XavierianAerospace/Plane_Proyect/Simulacion_Matlab_SolidWorks/Documento_Maestro_Proyecto_VTOL_Tipo_Stallion.docx

Documento Maestro del Proyecto

Avión VTOL Académico de Ala Fija Tipo Stallion

Campo | Definición inicial
Tipo de aeronave | VTOL académico de ala fija
Configuración | Tricóptero tipo Stallion: 2 motores delanteros inclinables + 1 motor trasero
Objetivo principal | Despegue vertical, hover estacionario, transición y vuelo horizontal
Autonomía objetivo | 20 a 30 minutos
Carga útil | Cámara pequeña de 300 a 400 g como máximo
Equipo de trabajo | 5 integrantes
Presupuesto inicial | Aproximadamente 1 millón COP, ampliable si es necesario

# 1. Descripción general del proyecto

El proyecto consiste en desarrollar un prototipo académico de avión VTOL de ala fija, inspirado en la configuración tipo Stallion. La aeronave deberá despegar y aterrizar verticalmente, mantenerse en hover como un dron, realizar una transición controlada hacia vuelo horizontal y operar en crucero como un avión de ala fija. El diseño se plantea desde cero para poder adaptar geometría, estructura, electrónica y distribución interna a las necesidades del equipo.

La configuración seleccionada es de tricóptero VTOL: dos motores delanteros inclinables y un motor trasero. Durante el despegue y el hover, los motores generan la sustentación vertical. Durante el vuelo horizontal, los motores delanteros inclinables actúan como propulsión principal y las alas generan la sustentación aerodinámica.

Planteamiento central

El avión debe comportarse como un dron durante el despegue, aterrizaje y hover, pero como un avión de ala fija durante la mayor parte del vuelo para alcanzar una autonomía objetivo de 20 a 30 minutos.

Variable | Valor o decisión actual
Envergadura | 1.2 m a 1.5 m
Longitud | 0.8 m a 1.2 m
Peso total objetivo | 2.5 kg a 3.5 kg
Velocidad de crucero | 40 a 60 km/h
Carga útil | Cámara pequeña de 300 a 400 g máximo
Autonomía objetivo | 20 a 30 minutos
Fabricación disponible | Impresión 3D en PLA/PETG, aluminio y barras de fibra comercial
Pruebas | Primero en laboratorio y luego en campo abierto

# 2. Objetivos del avión VTOL

## 2.1 Objetivo general

Diseñar y construir un prototipo académico de avión VTOL de ala fija tipo tricóptero, capaz de realizar despegue vertical, hover estacionario, transición a vuelo horizontal y vuelo de crucero, considerando una carga útil de cámara pequeña y una autonomía objetivo de 20 a 30 minutos.

## 2.2 Objetivos específicos

1. Definir una arquitectura VTOL tipo Stallion con dos motores delanteros inclinables y un motor trasero.
2. Diseñar una estructura liviana, fabricable con impresión 3D, aluminio y elementos de fibra comercial.
3. Seleccionar un sistema de propulsión que permita despegue vertical, hover estable y vuelo horizontal eficiente.
4. Escoger un controlador de vuelo y software gratuito que facilite la integración de motores, servos, sensores y modos VTOL.
5. Reservar desde el diseño espacio, capacidad de carga y ubicación adecuada para una cámara de 300 a 400 g.
6. Desarrollar pruebas progresivas: laboratorio, motores sin hélices, hover controlado, vuelo horizontal y transición.
7. Mantener una documentación clara del diseño, presupuesto, riesgos, pruebas y modificaciones realizadas.

# 3. Requisitos de diseño

Los requisitos iniciales se dividen en funcionales, de desempeño, de fabricación, de presupuesto y de seguridad. Estos requisitos permiten que todos los grupos trabajen con una misma base de diseño.

Tipo de requisito | Requisito inicial
Funcional | Despegue y aterrizaje vertical, hover estacionario, transición y vuelo horizontal.
Configuración | Tricóptero VTOL: 2 motores delanteros inclinables + 1 motor trasero.
Autonomía | 20 a 30 minutos, priorizando el vuelo horizontal y minimizando el tiempo en hover.
Carga útil | Cámara pequeña de 300 a 400 g máximo. La transmisión de video será una meta posterior.
Velocidad | Crucero entre 40 y 60 km/h.
Peso | Objetivo entre 2.5 kg y 3.5 kg. Se debe evitar superar este rango sin recalcular propulsión y estructura.
Materiales | PLA, PETG, aluminio y barras de fibra comercial disponibles en Colombia.
Presupuesto | 1 millón COP inicial, ampliable si la selección de componentes lo exige.
Software | Preferiblemente gratuito, de fácil integración y con soporte para VTOL.
Pruebas | Secuencia segura: laboratorio, configuración sin hélices, pruebas estáticas, hover bajo, vuelo horizontal y transición.

Criterio de autonomía

La autonomía objetivo de 20 a 30 minutos debe buscarse principalmente en modo avión. El hover consume mucha energía y debe limitarse a despegue, aterrizaje, estabilización y pruebas cortas.

# 4. Configuración tipo Stallion

La configuración tipo Stallion combina características de un avión de ala fija y de un multirrotor. El avión utiliza dos motores delanteros capaces de inclinarse y un motor trasero para el modo vertical. Esta arquitectura permite despegar como dron y luego inclinar los motores delanteros para generar empuje horizontal durante el vuelo de crucero.

Etapa de vuelo | Funcionamiento esperado
Despegue vertical | Los tres motores generan empuje vertical. El fuselaje debe mantenerse nivelado como un dron.
Hover estacionario | El avión se mantiene quieto en el aire durante pruebas o maniobras cortas.
Transición | Los motores delanteros se inclinan progresivamente hasta generar empuje horizontal. Las alas comienzan a producir sustentación.
Vuelo horizontal | Las alas sostienen la aeronave y los motores delanteros actúan como propulsores principales.
Aterrizaje vertical | El avión reduce velocidad, vuelve a modo vertical y desciende de forma controlada.

Ventaja | Implicación para el proyecto
Menos motores que un quadplane | Puede reducir peso y resistencia, pero aumenta la exigencia de control.
Transición eficiente | Los motores delanteros sirven para hover y crucero.
Diseño limpio | Permite una geometría de avión más integrada.
Mayor complejidad que un avión normal | Requiere servos inclinables, configuración VTOL y pruebas cuidadosas.
Mayor dificultad que quadplane | El control de hover y transición puede ser más delicado al tener tres puntos de empuje.

# 5. Arquitectura general del sistema

La aeronave se puede entender como la integración de cinco sistemas principales: estructura, propulsión, energía, control de vuelo y carga útil. Todos deben diseñarse coordinadamente porque los cambios de peso, ubicación o consumo afectan al resto del avión.

Sistema | Elementos principales | Función
Estructura y aerodinámica | Fuselaje, alas, cola, soportes, tren o patas | Dar forma al avión, soportar cargas y garantizar estabilidad.
Propulsión VTOL/crucero | Motores, hélices, ESC y servos inclinables | Permitir despegue vertical, hover, transición y vuelo horizontal.
Energía | Batería, distribución de potencia, reguladores, conectores | Alimentar motores, controlador, servos, sensores y cámara.
Control de vuelo | Controlador, IMU, barómetro, GPS, receptor, telemetría | Estabilizar el avión y gestionar modos de vuelo.
Carga útil y video | Cámara, soporte antivibración, transmisor o módulo de video futuro | Capturar y transmitir video en una etapa posterior del proyecto.

Esquema general de flujo de energía y control:

Batería -> distribución de potencia -> ESC -> motores VTOL/crucero
Batería -> regulador 5 V / BEC -> controlador de vuelo -> sensores, receptor, servos y cámara

# 6. Distribución de grupos de trabajo

Se recomienda dividir el trabajo en cinco grupos o responsables. Cada responsable puede liderar un área, pero todas las decisiones críticas deben revisarse en conjunto.

Responsable / grupo | Área principal | Actividades | Entregables
Grupo 1 | Aerodinámica y geometría | Definir ala, fuselaje, cola, centro de gravedad preliminar y estabilidad básica. | Plano general, dimensiones, área alar, ubicación del centro de gravedad.
Grupo 2 | Estructura y manufactura | Diseñar piezas, soportes de motores, unión de alas, tren/patas y selección de materiales. | CAD, piezas imprimibles, lista de materiales estructurales, plan de ensamble.
Grupo 3 | Propulsión y energía | Seleccionar motores, hélices, ESC, batería, servos y estimar consumo. | Tabla de componentes, empuje requerido, potencia, autonomía estimada.
Grupo 4 | Electrónica y control | Seleccionar controlador, software, sensores, cableado y configuración de modos VTOL. | Diagrama eléctrico, configuración inicial, checklist de conexión.

Regla de coordinación

Cada cambio de peso, batería, cámara, motor o posición interna debe actualizarse en una tabla común del proyecto. En un VTOL, un cambio pequeño puede afectar el centro de gravedad, la autonomía, la estabilidad y la selección de motores.

# 7. Materiales y fabricación

El equipo cuenta con una impresora Ender 3 S1 y puede fabricar piezas en PLA y PETG. También se consideran materiales comerciales de aluminio y barras de fibra disponibles en Colombia. La estrategia recomendada es usar impresión 3D para piezas de unión, soportes y carcasas, pero no depender de piezas impresas pesadas para toda la estructura.

Material | Uso recomendado | Observaciones
PLA | Prototipos, carcasas, piezas no críticas y pruebas de forma. | Fácil de imprimir, pero puede deformarse con temperatura y no es ideal para zonas de alto esfuerzo.
PETG | Soportes, piezas expuestas a esfuerzo moderado, bases de motor y elementos funcionales. | Más resistente y flexible que PLA, aunque puede ser más difícil de imprimir con buena precisión.
Aluminio | Refuerzos, soportes, uniones y elementos estructurales delgados. | Buena resistencia, fácil de conseguir y útil para zonas sometidas a carga.
Barras/tubos de fibra | Brazos de motor, largueros de ala y refuerzos livianos. | Muy útiles para reducir peso y aumentar rigidez.
Tornillería y adhesivos | Uniones desmontables y ensamble final. | Debe controlarse el peso acumulado de tornillos, tuercas y accesorios.

- Evitar un fuselaje completamente macizo o excesivamente impreso en 3D, porque el peso puede aumentar rápidamente.
- Usar PETG o piezas reforzadas en zonas cercanas a motores, servos y mecanismos de inclinación.
- Diseñar alas y fuselaje pensando en mantenimiento: acceso a batería, ESC, controlador, cableado y cámara.
- Asegurar que las piezas principales puedan imprimirse dentro del volumen útil de la Ender 3 S1.

# 8. Electrónica, control y software

El equipo todavía no cuenta con controlador de vuelo, radio control, cargador ni sensores. Por eso, la selección debe hacerse considerando compatibilidad con VTOL, facilidad de configuración, disponibilidad, documentación y presupuesto.

Elemento | Criterio de selección
Controlador de vuelo | Debe soportar modos VTOL, salidas para motores/servos, sensores integrados y configuración con software libre.
Software | Debe ser gratuito, documentado y compatible con configuración de tricóptero VTOL o tiltrotor.
Radio control | Debe tener suficientes canales para modo manual, armado, cambio de modo, transición y seguridad.
GPS | Recomendado para vuelo asistido, navegación y pruebas en campo abierto.
Telemetría | Útil para monitorear batería, modo de vuelo, posición y parámetros durante pruebas.
Servos de inclinación | Deben tener torque suficiente, buena precisión y baja holgura mecánica.
Reguladores/BEC | Deben entregar voltajes estables para controlador, receptor, servos y cámara.

Recomendación inicial: evaluar primero controladores compatibles con ArduPilot o PX4. Para un equipo que busca facilidad y documentación, ArduPilot suele ser una opción fuerte para configuraciones VTOL/QuadPlane, pero la decisión final debe tomarse al comparar compatibilidad, costo y disponibilidad de hardware.

- No instalar hélices durante configuración inicial del controlador.
- Verificar sentido de giro de motores y respuesta de servos sin hélices.
- Documentar cada canal, salida PWM, modo de vuelo y parámetro modificado.
- Separar pruebas de electrónica, pruebas de motores y pruebas de control antes de volar.

# 9. Propulsión y energía

La propulsión es uno de los sistemas más importantes del proyecto. Debe cumplir dos condiciones: generar suficiente empuje vertical para despegar y tener eficiencia adecuada para el vuelo horizontal. No basta con seleccionar motores de mucho empuje; también se debe controlar peso, consumo, tamaño de hélice, corriente de batería y eficiencia en crucero.

Parámetro | Criterio inicial
Relación empuje/peso en vertical | Mínimo 1.5:1. Para pruebas, es preferible acercarse a 1.8:1 o 2:1.
Tiempo en hover | Debe ser corto. El hover consume más energía que el vuelo horizontal.
Autonomía | 20 a 30 minutos, principalmente en vuelo de ala fija.
Batería | Debe entregar suficiente corriente para despegue vertical y suficiente energía para crucero.
ESC | Deben soportar la corriente máxima con margen de seguridad.
Hélices | Deben seleccionarse junto con motor y batería, no de forma aislada.
Servos inclinables | Deben soportar carga aerodinámica y vibración durante transición y crucero.

Advertencia de diseño

Aumentar batería no siempre aumenta la autonomía. Una batería más grande aporta más energía, pero también más peso; ese peso incrementa consumo, esfuerzo estructural y empuje requerido. La autonomía debe obtenerse con eficiencia, no solo con capacidad de batería.

# 10. Cámara y transmisión de video como meta futura

La cámara será una carga útil de 300 a 400 g como máximo. La transmisión de video en tiempo real no será parte de la primera etapa funcional, pero debe considerarse desde el inicio para evitar rediseños fuertes del fuselaje y del sistema eléctrico.

Aspecto | Consideración de diseño
Peso | Reservar 300 a 400 g dentro del presupuesto de masa del avión.
Ubicación | Preferiblemente cerca del centro de gravedad o en una posición que pueda compensarse con la batería.
Vibración | Usar soporte o montaje que reduzca vibraciones de motores y estructura.
Energía | Prever alimentación estable para cámara y transmisor de video.
Espacio interno | Diseñar compartimento accesible para cámara, cables y posible transmisor.
Interferencia | Mantener ordenado el cableado y separar potencia de señal cuando sea posible.
Etapa de integración | Primero probar avión básico; luego integrar cámara física; finalmente transmisión en tiempo real.

# 11. Fases de desarrollo

El proyecto debe desarrollarse por etapas. No conviene intentar desde el inicio un vuelo completo con transición y cámara funcionando. La estrategia debe ser construir confianza técnica en cada subsistema antes de integrarlos.

Fase | Objetivo | Resultado esperado
Fase 0 - Definición | Cerrar misión, configuración, rango de peso, carga útil y presupuesto. | Documento maestro y requisitos base.
Fase 1 - Diseño preliminar | Definir geometría, estructura, ubicación de componentes y arquitectura eléctrica. | Bocetos, CAD preliminar y tabla de masa.
Fase 2 - Selección de componentes | Elegir motores, ESC, hélices, batería, servos, controlador y radio. | Lista de materiales y presupuesto actualizado.
Fase 3 - Fabricación | Construir fuselaje, alas, soportes, mecanismos de inclinación y compartimentos. | Estructura ensamblada y lista para integración.
Fase 4 - Integración electrónica | Conectar controlador, ESC, servos, receptor, sensores y alimentación. | Sistema encendido y configurado sin hélices.
Fase 5 - Pruebas de laboratorio | Verificar motores, servos, sensores, comunicación y seguridad. | Checklist validado y correcciones iniciales.
Fase 6 - Pruebas de hover | Probar despegue bajo, estabilidad y control como dron. | Hover estable y aterrizaje controlado.
Fase 7 - Vuelo horizontal | Validar comportamiento como avión de ala fija. | Vuelo estable a velocidad de crucero.
Fase 8 - Transición | Probar el cambio entre modo vertical y modo avión. | Transición controlada y repetible.
Fase 9 - Cámara y video | Integrar cámara física y luego transmisión en tiempo real. | Carga útil funcional sin comprometer estabilidad.

https://app.clickup.com/90131695726/v/li/901327686813

Proyecto VTOL tipo Stallion - Documento maestro
