XavierianAerospace/Plane_Proyect/Simulacion_Matlab_SolidWorks/Estado_Tecnico_VTOL_Stallion.docx

README tecnico del codigo
Proyecto VTOL Stallion

MATLAB - SolidWorks - CSV - Simulink

Version de trabajo: calculos iniciales de masa y centro de gravedad
Fecha: 2026-07-17

Proposito del documento: Este documento funciona como un README en formato Word. Su objetivo es que una persona que nunca haya visto el codigo pueda entender que se quiere lograr, como esta organizada la arquitectura, que archivos son importantes, que calcula actualmente MATLAB y que falta por desarrollar.

# 1. Resumen ejecutivo

El proyecto busca construir una cadena de trabajo para un avion VTOL tipo tricopter, llamado internamente VTOL Stallion. La idea es conectar progresivamente el diseno CAD, los datos de masa, los calculos fisicos y un simulador simple en MATLAB/Simulink.

El flujo actual parte de archivos DXF exportados desde SolidWorks. MATLAB lee esos DXF, identifica o importa partes separadas, crea un CSV maestro, permite completar masas y posiciones verticales manualmente, y luego calcula la masa total y el centro de gravedad del avion.

La meta no es tener desde el primer dia un modelo final exacto, sino construir una arquitectura ordenada que permita reemplazar datos manuales por datos reales de SolidWorks y, mas adelante, conectar esos resultados con Simulink y pruebas de banco.

Bloque | Estado actual | Comentario
DXF general | Funcionando | Se usa para silueta y referencia visual del avion.
DXF por partes | Funcionando | Cada pieza importante se importa desde una carpeta separada.
CSV maestro | Funcionando | Guarda geometria, masa, material y posicion de cada parte.
Masa y CG | En desarrollo funcional | Ya se plantea el calculo desde el CSV.
Inercias | Pendiente | Se hara primero como masa puntual y luego con SolidWorks.
Aerodinamica basica | Pendiente | Area alar, MAC, carga alar y estimaciones de vuelo.
Simulink | Pendiente | Primero servos, luego dinamica basica del avion.

# 2. Objetivo tecnico del proyecto

El objetivo tecnico es crear una herramienta de calculo que reciba informacion geometrica y de masa del avion, calcule propiedades fisicas importantes y prepare parametros para simulacion. La herramienta debe crecer por etapas, evitando depender desde el inicio de automatizaciones complejas.

Etapa | Objetivo | Resultado esperado
1 | Exportar o preparar datos desde SolidWorks | DXF general y DXF por partes.
2 | Crear CSV maestro | Tabla editable con nombre, tipo, posicion, area, masa y material.
3 | Calcular masa y CG | Masa total, peso total y centro de gravedad 3D.
4 | Calcular inercias aproximadas | Ixx, Iyy, Izz e inercias cruzadas con masas puntuales.
5 | Calcular geometria aerodinamica | Area alar, envergadura, MAC y posicion CG/MAC.
6 | Preparar Simulink | Estructura de parametros para servos, motores y dinamica.
7 | Automatizar SolidWorks | Macro para exportar masa, CG e inercias reales.

# 3. Flujo de trabajo recomendado

El flujo de trabajo se definio para ir de lo simple a lo automatizado. Primero se acepta una etapa manual con CSV, despues se reemplazan esos datos por salidas automaticas de SolidWorks.

SolidWorks / CAD
-> exporta DXF general y DXF por partes

MATLAB
-> lee DXF
-> crea tabla maestra
-> guarda componentes_vtol_base.csv

Usuario
-> completa masa_g, z_mm y material

MATLAB
-> lee CSV completo
-> calcula masa total y CG
-> genera graficas y tablas

Futuro
-> calcula inercias, MAC, carga alar, hover y parametros Simulink
-> reemplaza datos manuales con macro de SolidWorks

Regla clave: Los DXF separados deben conservar el mismo origen global que el DXF general. No deben exportarse centrados en su propio origen local, porque eso romperia las posiciones relativas dentro del avion.

# 4. Arquitectura de carpetas

La arquitectura separa CAD, codigo fuente, resultados, pruebas y modelos de Simulink. Esto permite que cada modulo tenga una responsabilidad clara.

MatLab_Simulaciones/
|
|-- Main_Vtol.m
|
|-- cad/
| |-- general_dxf/
| | `-- VTOL_GENERAL.dxf
| |
| |-- estructura_dxf/
| | |-- ALA_DER_FIJA.dxf
| | |-- ALA_IZQ_FIJA.dxf
| | |-- ALERON_DER.dxf
| | |-- ALERON_IZQ.dxf
| | |-- BOOM_TRASERO.dxf
| | |-- COLA_DER_FIJA.dxf
| | |-- COLA_IZQ_FIJA.dxf
| | |-- ELEVON_COLA_DER.dxf
| | |-- ELEVON_COLA_IZQ.dxf
| | |-- FUSELAJE.dxf
| | |-- FUSELAJE_COLA.dxf
| | |-- SOPORTE_MOTOR_DER.dxf
| | `-- SOPORTE_MOTOR_IZQ.dxf
| |
| |-- componentes_dxf/
| | |-- BATERIA.dxf
| | |-- ELECTRONICA.dxf
| | |-- MOTOR_DER.dxf
| | |-- MOTOR_IZQ.dxf
| | |-- MOTOR_TRASERO.dxf
| | |-- SERVO_ALA_DER.dxf
| | |-- SERVO_ALA_IZQ.dxf
| | |-- SERVO_COLA_DER.dxf
| | |-- SERVO_COLA_IZQ.dxf
| | |-- SERVO_MOTOR_DER.dxf
| | `-- SERVO_MOTOR_IZQ.dxf
| |
| `-- Piezas3D/
|
|-- src/
| |-- config/
| |-- CAD_2D/
| |-- geometria/
| |-- exportacion/
| |-- masa_CG/
| |-- aero/
| |-- propulsion/
| |-- visualizacion/
| `-- simulador/
|
|-- resultados/
| |-- datos_procesados/
| `-- figuras/
|
|-- tests/
`-- simulink/

# 5. Responsabilidad de cada carpeta de codigo

Carpeta | Responsabilidad | Ejemplos de funciones
src/config | Crear rutas, configurar unidades y parametros globales. | configurar_proyecto_vtol.m, configurar_DXF_vtol.m
src/CAD_2D | Leer archivos DXF ASCII y convertir entidades geometricas. | analizar_DXF_avion_2D.m, importar_DXF_avion_2D.m
src/geometria | Procesar geometria general del avion. | procesar_geometria_2D.m, imprimir_resumen_geometria_2D.m
src/exportacion | Crear o actualizar tablas/CSV. | actualizar_tabla_maestra_desde_csv.m
src/masa_CG | Calcular masa total, peso y centro de gravedad. | calcular_masa_CG_vtol.m, imprimir_resumen_masa_CG_vtol.m
src/visualizacion | Generar graficas, tablas visuales y guardar figuras. | graficar_masa_CG_vtol.m, mostrar_tabla_partes_vtol.m
src/aero | Calculos aerodinamicos futuros. | Area alar, MAC, carga alar, stall.
src/propulsion | Calculos de motores, hover y empuje. | T/W, brazos de motor, momentos.
src/simulador | Preparacion de datos para Simulink. | Parametros para servos, motores y dinamica.

# 6. Sistema de coordenadas y unidades

El sistema interno del proyecto usa coordenadas del avion. Es importante no confundir coordenadas con momentos de inercia. Las columnas x_mm, y_mm y z_mm son posiciones de cada parte, no son Ixx, Iyy ni Izz.

Variable | Significado | Unidad en CSV | Quien la define
x_mm | Posicion longitudinal desde la nariz hacia la cola. | mm | MATLAB desde DXF.
y_mm | Posicion lateral, izquierda/derecha del avion. | mm | MATLAB desde DXF.
z_mm | Posicion vertical, arriba/abajo del plano de referencia. | mm | Usuario por ahora.
masa_g | Masa de la pieza. | g | Usuario por ahora.
area_mm2 | Area 2D aproximada de la pieza en el DXF. | mm2 | MATLAB desde DXF.
material | Material o tipo de elemento. | texto | Usuario o script de prueba.

Convencion temporal de z: z_mm = 0 representa el plano medio usado en el DXF. Valores positivos indican piezas por encima del plano y valores negativos indican piezas por debajo. Esta convencion sirve para probar la logica antes de tener el modelo 3D final.

# 7. CSV maestro: componentes_vtol_base.csv

El CSV maestro es el puente entre CAD y calculos fisicos. MATLAB lo crea desde los DXF y el usuario completa los datos que aun no se extraen automaticamente.

Columna | Uso actual | Observacion
id_global | Identificador interno. | Lo asigna MATLAB.
categoria | Distingue estructura o componente. | Ejemplo: estructura, componente.
tipo | Clasifica la pieza. | Ejemplo: ala, servo, motor, bateria.
nombre | Nombre de la pieza. | Debe coincidir con el nombre del DXF.
x_mm, y_mm | Posicion 2D. | Calculada desde DXF.
z_mm | Posicion vertical. | Manual por ahora.
area_mm2 | Area 2D. | Sirve como referencia geometrica.
masa_g | Masa de la pieza. | Manual por ahora. Es obligatoria para calcular CG.
material | Material o descripcion. | No afecta el CG, pero ayuda en reportes.
fuente_masa | Origen de la masa. | manual, manual_prueba, csv_manual, futuro SolidWorks.

Archivo esperado:
resultados/datos_procesados/componentes_vtol_base.csv

Columnas que se completan manualmente ahora:
masa_g
z_mm
material

# 8. Funcion principal: Main_Vtol.m

Main_Vtol.m es el punto de entrada del proyecto. Ejecuta el flujo completo y conecta los modulos. La idea es que el usuario no tenga que correr funciones individuales, excepto scripts de prueba o herramientas auxiliares.

Paso en Main | Que hace | Resultado
1 | Configura carpetas y rutas. | cfgProyecto.
2 | Configura lector DXF. | cfgDXF.
3 | Selecciona DXF general. | Ruta a VTOL_GENERAL.dxf.
4 | Importa geometria general. | geom2D.
5 | Procesa geometria general. | resGeom2D.
6 | Importa partes separadas. | resPartesDXF.
7 | Crea/actualiza CSV maestro. | tablaMaestraVTOL.
8 | Muestra resumen y graficas de partes. | Figuras de geometria.
9 | Calcula masa y CG. | resMasaCG.
10 | Guarda datos y figuras. | MAT, CSV y PNG/figuras.

Forma usual de ejecucion en MATLAB:

cd("C:\Users\Juan Andres Sanchez\Desktop\Vtol Stallion\MatLab_Simulaciones")
clear functions
rehash
Main_Vtol

# 9. Calculos actuales: masa total y centro de gravedad

El primer modulo fisico calcula masa total, peso total y centro de gravedad del avion a partir del CSV. El calculo usa todas las filas que tengan masa_g positiva y posiciones x_mm, y_mm, z_mm validas.

Masa total:
masa_total_g = suma(masa_g)
masa_total_kg = masa_total_g / 1000
peso_total_N = masa_total_kg * g

Centro de gravedad:
CG_x = suma(masa_i * x_i) / suma(masa_i)
CG_y = suma(masa_i * y_i) / suma(masa_i)
CG_z = suma(masa_i * z_i) / suma(masa_i)

Las graficas de masa y CG muestran puntos cuyo tamano es proporcional a masa_g. Como peso = masa por gravedad, visualmente una bola mas grande tambien representa una pieza con mayor peso relativo.

Resultado | Descripcion
resMasaCG.masa.total_g | Masa total en gramos.
resMasaCG.masa.total_kg | Masa total en kilogramos.
resMasaCG.masa.peso_N | Peso total en newtons.
resMasaCG.CG.x_mm | Centro de gravedad longitudinal.
resMasaCG.CG.y_mm | Centro de gravedad lateral.
resMasaCG.CG.z_mm | Centro de gravedad vertical.
resMasaCG.resumen.porCategoria | Masa acumulada por categoria.
resMasaCG.resumen.porTipo | Masa acumulada por tipo.

# 10. Visualizacion actual

Las visualizaciones ayudan a revisar que la distribucion de masas tenga sentido antes de usar los resultados en calculos mas avanzados.

Figura | Contenido | Detalles importantes
Partes DXF separadas | Dibuja piezas importadas desde DXF. | Usa lineas finas y areas transparentes.
Tabla resumen partes | Muestra las piezas detectadas/importadas. | No debe tener textos dentro de la silueta.
Vista superior masa-CG | Puntos de masa sobre el avion. | Debe mantener la orientacion con la nariz hacia arriba y contorno gris.
Vista lateral masa-CG | Puntos segun x y z. | Muestra altura vertical z_mm de cada pieza.
Masa por categoria/tipo | Barras de masa acumulada. | Sirve para detectar componentes que dominan el peso.
Tabla referencia masa-CG | Tabla externa de colores y puntos. | Evita poner etiquetas dentro de la grafica.

# 11. Scripts de prueba

Para probar la logica sin datos reales se usa un script que llena masa_g, z_mm y material con valores temporales. Esto no valida el avion real, solo valida que el flujo de lectura, calculo y graficacion funcione.

Script recomendado:
tests/editar_csv_prueba_masas.m

Que hace:
- lee componentes_vtol_base.csv
- convierte columnas a tipos correctos
- llena masa_g, z_mm y material
- guarda de nuevo el CSV

Despues se corre:
Main_Vtol

Importante: Antes de guardar el CSV desde MATLAB, cerrar el archivo en Excel, VS Code u otro visor. Si el CSV esta abierto, MATLAB puede fallar al escribirlo.

# 12. Supuestos y limitaciones actuales

Tema | Supuesto actual | Impacto
Masa | Se ingresa manualmente en el CSV. | Sirve para probar, pero luego debe medirse o salir de SolidWorks.
z_mm | Se ingresa manualmente. | El CG vertical es aproximado.
x_mm, y_mm | Salen del centro geometrico 2D de cada DXF. | No son todavia el CG 3D real de cada pieza.
Inercias | No se calculan todavia. | La dinamica Simulink aun no debe considerarse final.
Area alar | No esta integrada al calculo fisico final. | Aun falta relacionar alas, alerones y MAC.
Unidades DXF | General en mm y partes posiblemente en m. | cfgDXF debe indicar correctamente unidadesDXFPartes.
Validacion aerodinamica | Pendiente. | Los resultados actuales son de arquitectura y masa/CG.

# 13. Que falta por desarrollar

Prioridad | Modulo pendiente | Descripcion
Alta | Inercias aproximadas | Calcular Ixx, Iyy, Izz, Ixy, Ixz e Iyz con masas puntuales respecto al CG.
Alta | Area alar y MAC | Usar alas y alerones para area alar, cuerda media y posicion del 25% MAC.
Media | Carga alar y stall | Calcular W/S, CL de crucero y velocidad de perdida aproximada.
Media | Geometria de motores | Calcular brazos de momento de motores respecto al CG.
Media | Hover tricopter | Empuje requerido, T/W y distribucion inicial entre motores.
Media | Parametros Simulink | Crear estructura limpia para alimentar bloques de servos y dinamica.
Baja/Posterior | Macro SolidWorks | Exportar masa, CG e inercias reales automaticamente a CSV.
Posterior | Pruebas de banco | Conectar hardware real y comparar con simulador.

# 14. Guia rapida para una persona nueva

Para entender y correr el proyecto por primera vez, seguir este orden:

1. Abrir la carpeta raiz MatLab_Simulaciones.
2. Revisar que Main_Vtol.m este en la raiz, no dentro de src.
3. Revisar que los DXF esten en cad/general_dxf, cad/estructura_dxf y cad/componentes_dxf.
4. Ejecutar Main_Vtol para crear o actualizar el CSV maestro.
5. Completar masa_g, z_mm y material en componentes_vtol_base.csv.
6. Ejecutar Main_Vtol otra vez.
7. Revisar consola:
- masa total
- CG_x, CG_y, CG_z
- partes ignoradas
8. Revisar figuras:
- vista superior
- vista lateral
- masas por tipo/categoria
9. Solo despues de que masa y CG sean razonables, pasar a inercias y aerodinamica.

# 15. Errores comunes y solucion

Problema | Causa probable | Solucion
MATLAB no encuentra una funcion | La carpeta src no esta en el path o se movio un archivo. | Ejecutar clear functions, rehash y correr Main desde la raiz.
CSV no guarda | El archivo esta abierto en Excel o VS Code. | Cerrar el archivo y volver a ejecutar writetable.
Masa total sale NaN o 0 | masa_g tiene celdas vacias, texto no numerico o NaN. | Limpiar el CSV o usar el script de prueba.
Filas ignoradas en masa/CG | Faltan masa_g, x_mm, y_mm o z_mm. | Completar esas columnas.
Piezas aparecen fuera de lugar | DXF separado no conserva origen global. | Reexportar desde SolidWorks con la misma referencia global.
Areas muy pequenas o enormes | Unidades incorrectas en DXF separados. | Revisar cfgDXF.unidadesDXFPartes.
Graficas con lineas raras | Uso de contornos aproximados en vez de entidades reales. | Dibujar entidades DXF reales y evitar boundary para visualizacion.

# 16. Glosario minimo

Termino | Significado
CG | Centro de gravedad. Punto donde se balancea el avion segun su distribucion de masa.
DXF | Archivo 2D exportado desde CAD que contiene lineas, arcos, splines, circulos y polilineas.
CSV maestro | Tabla central que conecta CAD con calculos de masa, CG y futuros modulos.
MAC | Cuerda aerodinamica media. Referencia clave para ubicar el CG respecto al ala.
Ixx, Iyy, Izz | Momentos de inercia alrededor de los ejes principales del avion.
T/W | Relacion empuje/peso. Importante para hover y margen de control.
masa_g | Masa de una pieza en gramos.
z_mm | Altura vertical de una pieza respecto al plano de referencia.

# 17. Recomendacion de mantenimiento

Mantener la regla de una responsabilidad por archivo. Las funciones que calculan deben quedarse en carpetas de calculo, y las funciones que solo dibujan deben quedarse en visualizacion. Main_Vtol debe coordinar, pero no debe llenarse de formulas largas.

Buena practica:
- calcular_masa_CG_vtol.m calcula.
- imprimir_resumen_masa_CG_vtol.m imprime.
- graficar_masa_CG_vtol.m grafica.
- actualizar_tabla_maestra_desde_csv.m conserva datos manuales.
- Main_Vtol.m conecta el flujo completo.

Estado final de esta etapa: La etapa actual se considera correcta cuando el CSV se lee sin errores, no hay filas ignoradas por datos incompletos, la masa total aparece razonable y el CG se muestra correctamente en las vistas superior y lateral.

Documento de orientacion para arquitectura MATLAB/SolidWorks/Simulink

README tecnico - Proyecto VTOL Stallion
