XavierianAerospace/Plane_Proyect/DOCUMENTACIÓN/2026_01/INDIVIDUAL/Antonio Mora-reporte_semana 13.docx

Reporte Semanal Individual

Lo llena cada miembro cada semana. Toma máximo 10 minutos. El coordinador lo revisa antes de la reunión.

Identificación

Nombre | Proyecto / Rol | Semana # | Fecha de envío
Antonio Mora | Avion | Semana 13 | 28/04/2026

Esta semana

Nota: Describe lo que hiciste en términos de tus metas del semestre. No lo que intentaste: lo que efectivamente avanzaste.

Meta | ¿Qué avancé esta semana? | % de avance acumulado
Meta 1 | Estudiar la manera de como hacer los planos | 20%
Meta 2 | Describe brevemente qué hiciste | Ej: 40%
Meta 3 | Describe brevemente qué hiciste | Ej: 40%

La próxima semana

¿Qué voy a hacer la próxima semana?

Analisis mecánicos de encaje de partes internas para el funcionamiento eléctrico

Bloqueos y necesidades

Nota: Si no tienes nada bloqueando, escribe 'Sin bloqueos'. No lo dejes en blanco: un blanco no le dice nada al coordinador.

¿Algo me está bloqueando? | ¿Qué necesito del coordinador o del semillero?
Tener parciales y entregas de avances de proyectos | Ej: por ahora ninguno

Participación

¿Asistí a la reunión de esta semana? | Si no asistí, ¿por qué?
Sí | Dejar en blanco si sí asistí

XAVERIAN AEROSPACE ENGINEERING Reporte Semanal Individual Versión 1.0 · 2025
