XavierianAerospace/Plane_Proyect/DOCUMENTACIÓN/2026_01/PROYECTO_SEMANAL/reporte_semanal_transversal_20260421.docx

Reporte Semanal Individual

Lo llena cada miembro cada semana. Toma máximo 10 minutos. El coordinador lo revisa antes de la reunión.

Identificación

Nombre | Proyecto / Rol | Semana # | Fecha de envío
Miguel | Avion | Semana 11 | 21/04/2026

Esta semana

Nota: Se consulto distintitos tipos de amortiguadores para visualizar cual es mas indicado

Meta | ¿Qué avancé esta semana? | % de avance acumulado
Meta 1 | Se avanzo en los diferentes tipos de amortiguadores aplicando un tabla de diferencias | 80%

La próxima semana

¿Qué voy a hacer la próxima semana?

Terminar de visualizar y hacer la propuesta para que se acepte la propuesta del prototipo

Bloqueos y necesidades

Nota: Si no tienes nada bloqueando, escribe 'Sin bloqueos'. No lo dejes en blanco: un blanco no le dice nada al coordinador.

¿Algo me está bloqueando? | ¿Qué necesito del coordinador o del semillero?
El tiempo de realizado de los por parciales continuoa | Por el momento no hay novedad

Participación

¿Asistí a la reunión de esta semana? | Si no asistí, ¿por qué?
SI | Dejar en blanco si sí asistí

XAVERIAN AEROSPACE ENGINEERING Reporte Semanal Individual Versión 1.0 · 2025
