XavierianAerospace/Plane_Proyect/DOCUMENTACIÓN/2026_01/INDIVIDUAL/samuel_garcia_reporte_semanal_individual.docx

Reporte Semanal Individual

Lo llena cada miembro cada semana. Toma máximo 10 minutos. El coordinador lo revisa antes de la reunión.

Identificación

Nombre | Proyecto / Rol | Semana # | Fecha de envío
Samuel Garcia | Avión | Semana 12 | 21/04/2026

Esta semana

Nota: Describe lo que hiciste en términos de tus metas del semestre. No lo que intentaste: lo que efectivamente avanzaste.

Meta | ¿Qué avancé esta semana? | % de avance acumulado
Meta 1 | Tren de aterrizaje del avión | Ej: 80%
Meta 2 | Describe brevemente qué hiciste | Ej: 40%
Meta 3 | Describe brevemente qué hiciste | Ej: 40%

La próxima semana

¿Qué voy a hacer la próxima semana?

- Rediseñar el tren de aterrizaje .
- Organizar el github.
- Diseñar sistema de flaps.

Bloqueos y necesidades

Nota: Si no tienes nada bloqueando, escribe 'Sin bloqueos'. No lo dejes en blanco: un blanco no le dice nada al coordinador.

¿Algo me está bloqueando? | ¿Qué necesito del coordinador o del semillero?
Sin bloqueos por ahora

Participación

¿Asistí a la reunión de esta semana? | Si no asistí, ¿por qué?
Sí | Dejar en blanco si sí asistí

XAVERIAN AEROSPACE ENGINEERING Reporte Semanal Individual Versión 1.0 · 2025
