XavierianAerospace/Plane_Proyect/Simulacion_Matlab_SolidWorks/Vtol Stallion/MatLab_Simulaciones/codigo Matlab avion explicacion.docx

Explicación del código Main_Vtol.m

Introducción

El archivo Main_Vtol.m constituye el programa principal del proyecto VTOL. Su función es coordinar todas las etapas necesarias para importar la geometría del avión desde archivos DXF, procesar la información obtenida, generar una tabla maestra con todos los componentes del vehículo, calcular propiedades como la masa total y el centro de gravedad, y finalmente guardar todos los resultados obtenidos.

Este script actúa como el punto de control del proyecto, llamando diferentes funciones especializadas que realizan tareas específicas.

1. Encabezado del programa

%% Main_Vtol.m

% MAIN PRINCIPAL DEL PROYECTO VTOL

%

% Flujo actual:

Explicación

En esta primera sección se encuentra la documentación del programa. Mediante comentarios se describe el propósito general del script y el flujo de trabajo que sigue el proyecto.

Se diferencian dos etapas:

- Flujo actual: corresponde a las funciones que ya están implementadas.
- Flujo futuro: enumera las funcionalidades que posteriormente serán añadidas al proyecto, como el cálculo del área alar, la cuerda aerodinámica media (MAC) y la preparación de parámetros para Simulink.

Estos comentarios sirven como guía para cualquier persona que necesite comprender rápidamente la estructura general del proyecto.

2. Limpieza del entorno de trabajo

clear;

clc;

close all;

Explicación

Antes de comenzar la ejecución del programa se limpia completamente el entorno de MATLAB.

La instrucción

clear

elimina todas las variables almacenadas en memoria, evitando que datos de ejecuciones anteriores afecten los resultados actuales.

La instrucción

clc

limpia la ventana de comandos para que la salida sea más organizada.

Finalmente,

close all

cierra todas las figuras abiertas, garantizando que las nuevas gráficas correspondan únicamente a la ejecución actual.

3. Mensaje de inicio

fprintf('\n============================================\n');

fprintf(' PROYECTO VTOL - MAIN GENERAL\n');

fprintf('============================================\n\n');

Explicación

Se imprime un encabezado en la consola indicando que el programa ha comenzado su ejecución.

La función fprintf permite escribir texto en la ventana de comandos, facilitando el seguimiento del proceso mientras el programa se ejecuta.

4. Configuración del proyecto

rootProyecto = fileparts(mfilename('fullpath'));

if isempty(rootProyecto)

rootProyecto = pwd;

end

Explicación

Esta sección determina automáticamente la ubicación del proyecto.

La función

mfilename('fullpath')

obtiene la ruta completa del archivo que se está ejecutando.

Posteriormente,

fileparts()

extrae únicamente la carpeta donde se encuentra dicho archivo.

Si por alguna razón MATLAB no puede determinar la ruta, se utiliza

pwd

para obtener el directorio de trabajo actual.

De esta manera el programa puede ejecutarse desde cualquier computador sin modificar rutas manualmente.

5. Agregar la carpeta "src"

srcPath = fullfile(rootProyecto,'src');

if isfolder(srcPath)

addpath(genpath(srcPath));

end

Explicación

Aquí se incorpora automáticamente la carpeta src al Path de MATLAB.

La función

fullfile()

construye rutas compatibles con cualquier sistema operativo.

Posteriormente,

isfolder()

verifica que la carpeta exista.

Si existe, la instrucción

addpath(genpath(srcPath))

añade dicha carpeta y todas sus subcarpetas al entorno de MATLAB, permitiendo utilizar todas las funciones del proyecto sin necesidad de indicar su ubicación.

6. Configuración general del proyecto

cfgProyecto = configurar_proyecto_vtol(rootProyecto);

Explicación

Se llama a la función configurar_proyecto_vtol, cuya finalidad es crear una estructura (cfgProyecto) con todas las rutas importantes del proyecto.

Entre ellas se encuentran:

- Carpeta principal.
- Carpeta de archivos DXF.
- Carpeta de resultados.
- Carpeta de figuras.
- Carpeta de datos.
- Carpeta de código fuente.

Esta estructura centraliza toda la configuración del proyecto.

7. Mostrar información de las carpetas

fprintf(...)

Explicación

Se muestran en pantalla las rutas utilizadas por el programa.

Esto permite verificar rápidamente que el proyecto está utilizando las carpetas correctas para leer los archivos DXF y guardar los resultados.

8. Configuración del lector DXF

cfgDXF = configurar_DXF_vtol();

Explicación

Se crea una estructura denominada cfgDXF, la cual contiene toda la configuración relacionada con la importación de archivos DXF.

Esta estructura almacena información como:

- unidades del dibujo;
- orientación;
- escala;
- configuración de importación.

Centralizar estos parámetros facilita modificar el proyecto sin cambiar múltiples archivos.

9. Número de servomotores

cfgDXF.numServos = 6;

Explicación

Se especifica que el vehículo VTOL posee seis servomotores.

Los servos definidos corresponden a:

- Servo ala derecha.
- Servo ala izquierda.
- Servo cola derecha.
- Servo cola izquierda.
- Servo motor derecho.
- Servo motor izquierdo.

Este dato puede ser utilizado posteriormente para cálculos de masa, centro de gravedad o generación automática de componentes.

10. Verificación de unidades

if ~isfield(...)

Explicación

Esta condición verifica si dentro de la estructura cfgDXF existe el campo correspondiente a las unidades de los DXF de las piezas individuales.

Si el campo no existe, se asigna automáticamente:

cfgDXF.unidadesDXFPartes = "m";

Esto evita errores durante la importación de archivos.

11. Selección del archivo DXF general

archivoDXFGeneral = seleccionar_archivo_DXF(cfgProyecto);

Explicación

Se selecciona el archivo DXF que contiene la geometría completa del avión.

Este archivo representa la silueta general del vehículo y servirá como referencia para posicionar todas las piezas individuales.

12. Importación del DXF general

geom2D = importar_DXF_avion_2D(archivoDXFGeneral,cfgDXF);

Explicación

En esta etapa se importa toda la geometría bidimensional del avión.

La función genera una estructura denominada geom2D, que almacena:

- líneas;
- polilíneas;
- coordenadas;
- límites del dibujo;
- información geométrica necesaria para el resto del proyecto.

13. Verificación del Bounding Box

if ~isfield(geom2D,'bbox')

Explicación

Se comprueba que la estructura generada contenga el Bounding Box (bbox).

El Bounding Box es un rectángulo que encierra completamente la geometría del avión.

Este dato es indispensable para posicionar correctamente las piezas individuales importadas posteriormente.

Si no existe, el programa se detiene utilizando la función

error(...)

indicando que existe un problema durante la importación.

14. Procesamiento de la geometría

resGeom2D = procesar_geometria_2D(geom2D);

Explicación

Una vez importada la geometría, esta es procesada para obtener información adicional.

Durante este proceso pueden calcularse parámetros geométricos como dimensiones, áreas o referencias que serán utilizadas en etapas posteriores.

Toda esta información queda almacenada en la estructura resGeom2D.

15. Importación de partes separadas

resPartesDXF = importar_partes_separadas_DXF(...)

Explicación

Esta función importa cada componente del avión desde archivos DXF independientes.

Por ejemplo:

- alas;
- fuselaje;
- motores;
- superficies de control;
- estructura.

Cada pieza se procesa individualmente y posteriormente se almacena dentro de la estructura resPartesDXF.

16. Creación de la tabla maestra

tablaMaestraVTOL = resPartesDXF.tablaCSV;

Explicación

Se crea una tabla que contiene toda la información de los componentes del vehículo.

Cada fila representa una pieza distinta.

Entre las columnas se encuentran:

- identificador;
- categoría;
- tipo;
- nombre;
- posición;
- área;
- masa;
- material.

Esta tabla será la base para todos los cálculos posteriores.

17. Recuperación de información previa

actualizar_tabla_maestra_desde_csv(...)

Explicación

Si ya existe un archivo CSV previamente editado por el usuario, esta función recupera los valores ingresados manualmente.

Por ejemplo:

- masa;
- posición en Z;
- material.

De esta manera el usuario no necesita volver a escribir toda la información después de ejecutar nuevamente el programa.

18. Resumen de la geometría

imprimir_resumen_geometria_2D(resGeom2D);

Explicación

Se imprime en la consola un resumen de la geometría procesada.

Este resumen facilita comprobar que la importación fue correcta antes de continuar con el resto del análisis.

19. Vista previa de la tabla

disp(tablaMaestraVTOL(:,columnasDisponibles));

Explicación

Se muestran únicamente las columnas más importantes de la tabla maestra.

Esto permite revisar rápidamente los datos de cada componente sin imprimir toda la tabla.

20. Generación de la gráfica

graficar_zonas_sobre_silueta_DXF(...)

Explicación

Se genera una representación gráfica donde las diferentes piezas del avión son dibujadas sobre la silueta general obtenida del archivo DXF.

Esta gráfica permite verificar visualmente que todos los componentes fueron ubicados correctamente.

21. Tabla visual

mostrar_tabla_partes_vtol(tablaMaestraVTOL);

Explicación

Se genera una tabla visual con todos los componentes detectados.

Su finalidad es facilitar la inspección de la información almacenada antes de realizar los cálculos de masa.

22. Cálculo de masa y centro de gravedad

resMasaCG = calcular_masa_CG_vtol(tablaMaestraVTOL);

Explicación

Esta es una de las etapas más importantes del programa.

A partir de las masas y posiciones de todos los componentes se calcula:

- masa total del vehículo;
- centro de gravedad (CG).

El resultado queda almacenado en la estructura resMasaCG.

Posteriormente se imprime un resumen y se genera una gráfica donde se muestra la ubicación del centro de gravedad respecto al avión.

23. Guardado de datos MATLAB

save(...)

Explicación

Toda la información procesada se almacena en un archivo con extensión .mat.

Este archivo conserva todas las variables de MATLAB y permite continuar el trabajo posteriormente sin repetir toda la importación.

24. Guardado del archivo CSV

writetable(tablaMaestraVTOL,archivoCSV);

Explicación

La tabla maestra se exporta a un archivo CSV.

Este archivo puede abrirse fácilmente en Microsoft Excel para completar manualmente datos como:

- masa de cada componente;
- posición en el eje Z;
- material.

25. Guardado de figuras

guardar_figuras_abiertas_vtol(...)

Explicación

Todas las figuras abiertas durante la ejecución se guardan automáticamente en la carpeta de resultados.

Esto evita perder las gráficas generadas y facilita su inclusión en informes o documentación técnica.

26. Finalización del programa

fprintf(' MAIN FINALIZADO CORRECTAMENTE\n');

Explicación

Finalmente, el programa muestra un mensaje indicando que todas las etapas fueron ejecutadas correctamente y que los resultados han sido almacenados.

Este mensaje confirma que no ocurrieron errores durante la ejecución del script.
