XavierianAerospace/Plane_Proyect/DOCUMENTACIÓN/2026_01/INDIVIDUAL/Juan_Pablo_Arenas.docx

Reporte Semanal · Roles Transversales

Para Gestión del Conocimiento, Vinculación Externa e Infraestructura Digital. Se entrega a la Dirección cada semana.

Identificación

Nombre | Rol transversal | Semana # | Fecha
Juan Pablo Arenas | Subsistema de electrónica | Semana 12 | 21/04/2026

Avance en metas del semestre

Nota: Referencia directamente las metas que acordaste al inicio del semestre.

Meta | ¿Qué avancé esta semana? | % de avance acumulado
Meta 1 | He estado diseñando el sistema de regulación de potencia y conversión de voltaje a un voltaje digital. | 10%
Meta 2 | El diseño debe tener un mayor avance para poder comenzar con el prototipo | 0%

Actividades de la semana

¿Qué hice esta semana? | ¿A qué proyectos o personas impactó?
Realizar los reportes semanal/semestral | Todos

Próxima semana

¿Qué voy a hacer la próxima semana?

Continuar (finalizar) el sistema de potencia para poder empezar a revisar los tipos de sensores que queremos para el avión y validar que sus rangos concuerden con el contexto

Solicitudes a la Dirección

Nota: Lo que necesitas para poder cumplir tus metas. Si no necesitas nada, escríbelo explícitamente.

¿Qué necesito? | ¿Para cuándo lo necesito?
Sin solicitudes | DD/MM/AAAA o 'Sin urgencia'

XAVERIAN AEROSPACE ENGINEERING Reporte Semanal · Roles Transversales Versión 1.0 · 2025
