XavierianAerospace/Plane_Proyect/DOCUMENTACIÓN/PLANTILLAS/Plantillas de los Proyectos/Plantillas de los Proyectos/xae_P3_registro_de_decisiones.docx

Registro de Decisiones Técnicas

Documenta las decisiones que cambian el rumbo técnico del proyecto: materiales, diseños, métodos, enfoques. Este documento es lo que demuestra que el equipo sabe por qué hace lo que hace.

↳ Crea una entrada nueva por cada decisión técnica relevante. No todas las decisiones van aquí: solo las que, si se tomaran diferente, cambiarían el proyecto de forma significativa.

Decisión 1

ID de decisión | Fecha | Área técnica | Tomada por
DEC-001 | DD/MM/AAAA | Ej: Propulsión / Estructura / Aerodinámica | Nombre o 'Equipo completo'

¿Qué se decidió?

Enuncia la decisión de forma clara y definitiva. Ej: se utilizará propulsión sólida con motor comercial clase H en lugar de motor híbrido de fabricación propia.

Contexto: ¿por qué esta decisión era necesaria?

Explica el problema o la encrucijada que llevó a tomar esta decisión. Qué estaba en juego.

Opción evaluada | Ventajas | Por qué se descartó
Describe la alternativa considerada | ¿Qué tenía a favor? | ¿Por qué no se eligió?
Describe la alternativa considerada | ¿Qué tenía a favor? | ¿Por qué no se eligió?
Describe la alternativa considerada | ¿Qué tenía a favor? | ¿Por qué no se eligió?

Justificación de la decisión tomada

Explica por qué esta opción fue la elegida. Incluye los criterios técnicos, económicos o prácticos que la sustentan.

Referencias o evidencias que respaldan la decisión | Riesgos o limitaciones que se asumen
Ej: cálculo estructural en archivo 'estructura_v3.xlsx', norma ASTM E1382, paper adjunto | Ej: el motor comercial limita la altitud máxima, pero elimina el riesgo de falla en fabricación propia

¿Esta decisión es revisable? ¿Bajo qué condiciones se reconsideraría?

Ej: se reconsiderará si el presupuesto aumenta en más del 30% o si se consigue acceso al torno CNC del departamento.

Decisión 2

ID de decisión | Fecha | Área técnica | Tomada por
DEC-002 | DD/MM/AAAA | Ej: Propulsión / Estructura / Aerodinámica | Nombre o 'Equipo completo'

¿Qué se decidió?

Enuncia la decisión de forma clara y definitiva. Ej: se utilizará propulsión sólida con motor comercial clase H en lugar de motor híbrido de fabricación propia.

Contexto: ¿por qué esta decisión era necesaria?

Explica el problema o la encrucijada que llevó a tomar esta decisión. Qué estaba en juego.

Opción evaluada | Ventajas | Por qué se descartó
Describe la alternativa considerada | ¿Qué tenía a favor? | ¿Por qué no se eligió?
Describe la alternativa considerada | ¿Qué tenía a favor? | ¿Por qué no se eligió?
Describe la alternativa considerada | ¿Qué tenía a favor? | ¿Por qué no se eligió?

Justificación de la decisión tomada

Explica por qué esta opción fue la elegida. Incluye los criterios técnicos, económicos o prácticos que la sustentan.

Referencias o evidencias que respaldan la decisión | Riesgos o limitaciones que se asumen
Ej: cálculo estructural en archivo 'estructura_v3.xlsx', norma ASTM E1382, paper adjunto | Ej: el motor comercial limita la altitud máxima, pero elimina el riesgo de falla en fabricación propia

¿Esta decisión es revisable? ¿Bajo qué condiciones se reconsideraría?

Ej: se reconsiderará si el presupuesto aumenta en más del 30% o si se consigue acceso al torno CNC del departamento.

Decisión 3

ID de decisión | Fecha | Área técnica | Tomada por
DEC-003 | DD/MM/AAAA | Ej: Propulsión / Estructura / Aerodinámica | Nombre o 'Equipo completo'

¿Qué se decidió?

Enuncia la decisión de forma clara y definitiva. Ej: se utilizará propulsión sólida con motor comercial clase H en lugar de motor híbrido de fabricación propia.

Contexto: ¿por qué esta decisión era necesaria?

Explica el problema o la encrucijada que llevó a tomar esta decisión. Qué estaba en juego.

Opción evaluada | Ventajas | Por qué se descartó
Describe la alternativa considerada | ¿Qué tenía a favor? | ¿Por qué no se eligió?
Describe la alternativa considerada | ¿Qué tenía a favor? | ¿Por qué no se eligió?
Describe la alternativa considerada | ¿Qué tenía a favor? | ¿Por qué no se eligió?

Justificación de la decisión tomada

Explica por qué esta opción fue la elegida. Incluye los criterios técnicos, económicos o prácticos que la sustentan.

Referencias o evidencias que respaldan la decisión | Riesgos o limitaciones que se asumen
Ej: cálculo estructural en archivo 'estructura_v3.xlsx', norma ASTM E1382, paper adjunto | Ej: el motor comercial limita la altitud máxima, pero elimina el riesgo de falla en fabricación propia

¿Esta decisión es revisable? ¿Bajo qué condiciones se reconsideraría?

Ej: se reconsiderará si el presupuesto aumenta en más del 30% o si se consigue acceso al torno CNC del departamento.

Agregar más decisiones según sea necesario

↳ Copia el bloque completo de una entrada y pégalo a continuación. Numera las decisiones de forma consecutiva (DEC-004, DEC-005...).

XAVERIAN AEROSPACE ENGINEERING Registro de Decisiones Técnicas Versión 1.0 · 2025
