XavierianAerospace/Plane_Proyect/MECÁNICA/Modelo 3D Avion/Bateria Avion/CAPTURA CAJA CE.png

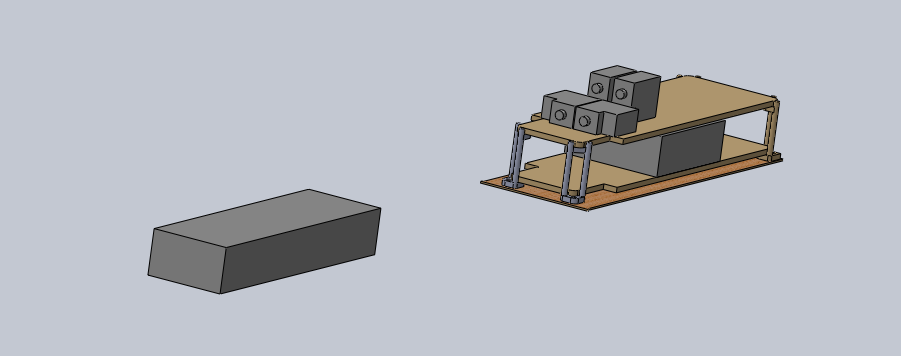
MECÁNICA/Modelo 3D Avion/Bateria Avion/CAPTURA CAJA CE.png
