XavierianAerospace/Plane_Proyect/Electronica/VTOL_RC_Plane_BOM(1).xlsx

RC Tilt-Rotor VTOL — Design Bill of Materials (BOM)
Juan · Mechatronics Engineering, PUJ — Propulsion & tilt-mechanism electronics
MAIN LIST — Target Budget Selection
Category | Component | Qty | Key Characteristics | Unit Price (USD) | Total Price (USD) | Notes / Source
Motors (x3, one per rotor/tilt-arm)
Motor | FlashHobby Arthur A2807 1300KV | 3 | 2807 stator, 12N14P, ~56g w/ cable, 4mm shaft, 19x19mm mount (M2), 175W rated power, CNC 6061-T6 aluminum bell, NSK/NMB bearings. Suited to 7" props for hover + forward-flight thrust. | $15.29 | $45.87 | Approx. street price (Banggood/RaceDayQuads), single unit, ex-shipping. Verify current stock.
Motor (alt-in-main) | EMAX ECO II 2807 1300KV | 3 | 2807 stator, N52SH arc magnets, 12mm EZO bearing, 19x19mm mount, mirror-polished bell. Listed as an equal option to the FlashHobby unit in your main selection. | $18.50 | $55.50 | Range seen $16.99–$19.49 (GetFPV/RaceDayQuads/EMAX USA). Use ONE motor SKU only — this row is the alternate brand for the same main-list slot, not an extra purchase.
Servos (x2, tilt-rotor actuation)
Servo | Corona DS-939MG Digital Metal Gear | 2 | 22.5x11.5x24.6mm, 12.5g, metal gear + MR85 ball bearing, coreless motor, 2.5–2.7kg·cm torque (4.8V/6V), 0.13–0.14s/60°, digital, 21T spline. Handles tilt-mechanism mechanical loads. | $9.50 | $19.00 | Range seen $8.29–$11.90 (HobbyKing/RCecho). Confirm torque is adequate for your tilt-arm lever length under motor thrust load.
ESCs (x3, one per motor)
ESC | Flycolor 45A BLHeli_S (single/individual) | 3 | 45A continuous / ~55A burst, 2–6S, BLHeli_S firmware, DShot150/300/600 support, runs cleanly off F405 signal pads. Individual (non 4-in-1) ESC so each motor/arm is electrically independent. | $13.50 | $40.50 | Estimated from comparable single BLHeli_S 45A units (Flycolor/GoolRC/Readytosky $8–15); confirm exact SKU + price with a Colombia-reachable vendor (e.g. AliExpress/Banggood) before ordering.
Flight Computer (x1)
Flight Controller | STM32 F405 Flight Controller (e.g. Matek F405-Wing V2 class) | 1 | STM32F405RGT6 @168MHz, 1MB flash, 6x UART, 10x PWM outputs, dual BEC, IMU + barometer, OSD, microSD blackbox. Runs ArduPilot (ArduPlane/QuadPlane) or INAV for VTOL mixing. | $62.00 | $62.00 | Range seen $58.87–$65 for Matek F405-Wing V2 class boards (Amazon/eBay). Confirm 10 PWM outputs cover 3 motors + 2 tilt servos + control surfaces.
MAIN LIST SUBTOTAL (excl. duplicate motor alt.) |  |  |  |  | $167.37
SECONDARY LIST — Alternatives (price / quality trade-offs)
Category | Component | Qty | Key Characteristics | Unit Price (USD) | Total Price (USD) | Notes / Source
Motors (x3) — Alternatives
Motor - Option A | Readytosky / Angel A2807 1300KV | 3 | Entry-level clone motor, 2807 size, 1300KV. Lower-cost bearings/build tolerance than name-brand units. | $11.00 | $33.00 | User-provided range $10–$12 each. Budget clone — inspect bearing play on arrival.
Motor - Option B | BrotherHobby SE 2807 1300KV | 3 | Higher quality build, smoother bearings, better heat dissipation/management than budget clones. | $17.00 | $51.00 | User-provided range $16–$18 each.
Servos (x2) — Alternatives
Servo - Option A | Emax ES08MD II Digital Metal Gear | 2 | Popular budget digital metal-gear servo. Note: ~12mm thick — check tilt-mechanism slot depth before committing. | $7.00 | $14.00 | User-provided range $6–$8 each.
Servo - Option B | GDW DS041MG / Kingmax 1203MD (low-profile 9mm) | 2 | Slim 9mm wing servos, fit flat inside thin 3D-printed wing sections — useful if tilt-arm housing is space-constrained. | $16.50 | $33.00 | User-provided range $15–$18 each.
ESCs (x3) — Alternatives
ESC - Option A | Spedix IS45A / Skystars 45A BLHeli_32 | 3 | 32-bit upgrade over BLHeli_S — smoother telemetry and RPM filtering (useful for ArduPilot ESC telemetry / harmonic notch). | $12.00 | $36.00 | User-provided range $10–$14 each.
ESC - Option B | Flycolor Francy 2 40A/50A | 3 | Includes small integrated BEC — useful if the F405 board's high-current servo power output is insufficient for both tilt servos under load. | $16.50 | $49.50 | User-provided range $15–$18 each.
Flight Computer (x1) — Alternative
Flight Controller - Knockoff | Generic/unbranded F405 clone (JHEMCU/HGLRC-style mini F405 board) | 1 | STM32F405 MCU, unbranded PCB commonly sold on AliExpress/Banggood. Typically fewer UARTs/PWM outputs and looser QC than Matek-class boards; firmware target (ArduPilot 'MatekF405-Wing' or generic 'GENERIC') must be verified per listing, not assumed. | $19.99 | $19.99 | Estimated from generic bare F405 clone listings (AliExpress/Banggood, ~$15–$25). Applies to BOTH Option A and Option B combos below — same FC slot either way.
SECONDARY LIST SUBTOTAL — Option A combo (motors A + servos A + ESCs A + FC knockoff) |  |  |  |  | $102.99
SECONDARY LIST SUBTOTAL — Option B combo (motors B + servos B + ESCs B + FC knockoff) |  |  |  |  | $153.49
RECOMMENDED BUILD TOTAL (FlashHobby motors + Corona servos + Flycolor ESCs + F405 FC) |  |  |  |  | $167.37
Assumptions & sourcing notes
• All unit prices are approximate international retail (USD), sourced from Banggood, GetFPV, HobbyKing, Amazon, RaceDayQuads, WREKD Co. and EMAX USA listings, July 2026. They exclude shipping, customs/import duties into Colombia, and any local vendor markup.
• Prices fluctuate by vendor and stock; re-verify before purchase, especially for items sourced from AliExpress/Banggood where shipping to Colombia can take 3–6 weeks.
• The 'Main List' total counts ONE motor SKU (FlashHobby) + servos + ESCs + FC. The EMAX ECO II row is shown as a same-slot alternative, not additive — swap it in if you prefer that brand.
• The 'Secondary List' now has two separate subtotals — Option A combo and Option B combo — each pricing ONE full alternative build (motors + servos + ESCs, all same letter) plus the F405 knockoff FC, which is shared by both combos since it's a single-item alternative to the main-list FC, not an A/B choice itself.
• Flycolor 45A BLHeli_S single-ESC pricing is an estimate — I could not confirm an exact current listing/price for that specific individual (non-4-in-1) SKU; verify with your supplier before finalizing budget.
• The F405 knockoff price is a rough estimate for an unbranded clone board; exact specs (UART/PWM count, IMU model) vary a lot between listings — treat this as a placeholder to size the budget, not a specific SKU to order.
