XavierianAerospace/Plane_Proyect/MECÁNICA/Modelo 3D Avion/TREN DE ATERRIZAJE/main landing gear.SLDPRT

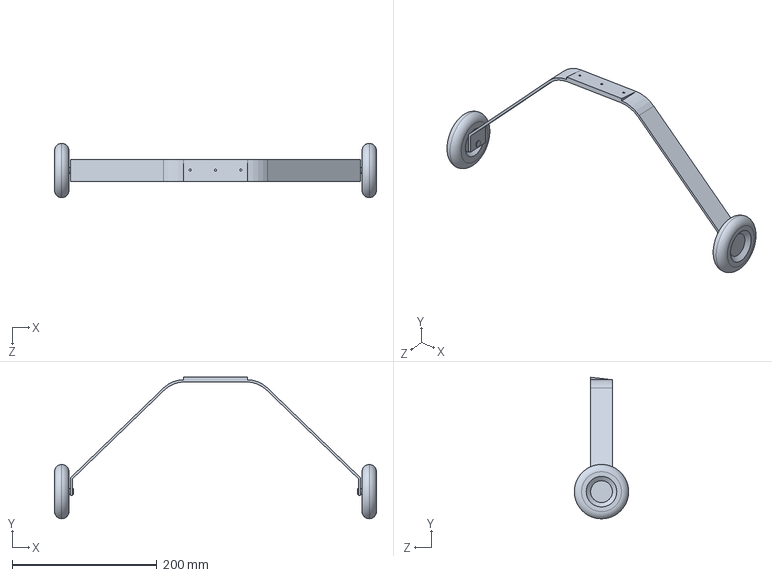
[picture p2: CAD file, 2026-05-02]
MECÁNICA/Modelo 3D Avion/TREN DE ATERRIZAJE/main landing gear.SLDPRT
444.3 x 195.3 x 75.0 mm
