XavierianAerospace/Plane_Proyect/Simulacion_Matlab_SolidWorks/Vtol Stallion/MatLab_Simulaciones/cad/Piezas3D/Diseño Avion/Archivos_Cola/Ensamble_cola.SLDASM

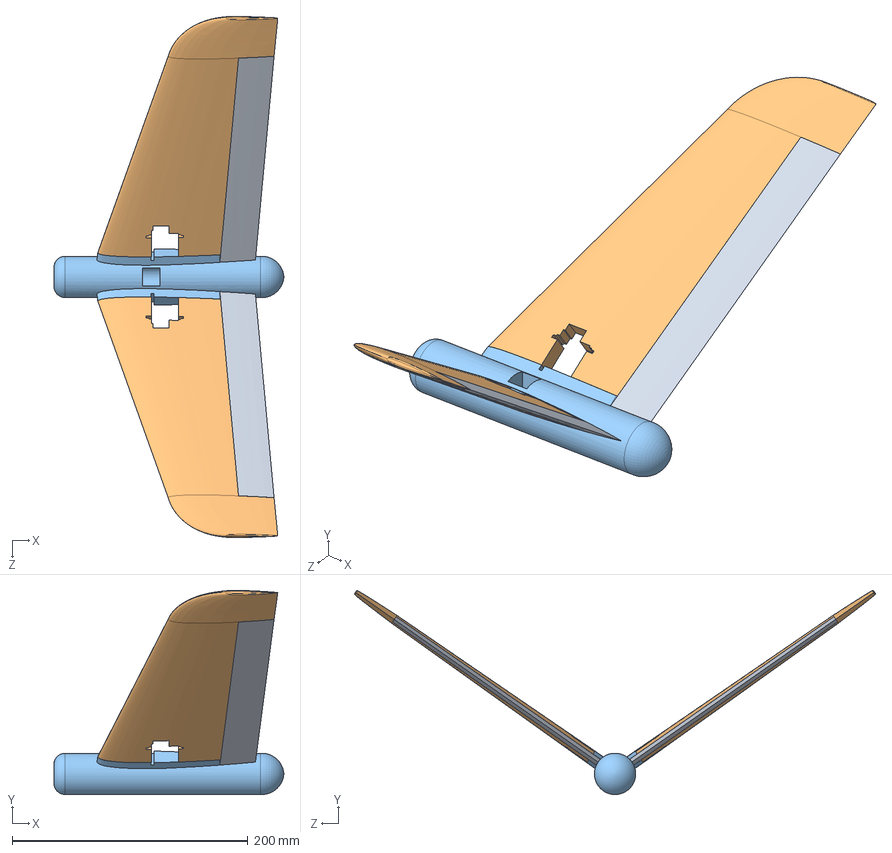
[picture p3: CAD file, 2026-09-08]
Simulacion_Matlab_SolidWorks/Vtol Stallion/MatLab_Simulaciones/cad/Piezas3D/Diseño Avion/Archivos_Cola/Ensamble_cola.SLDASM
194.8 x 172.9 x 441.6 mm
cuerpo de cola
cola vtol x 2
flap_cola x 2
