XavierianAerospace/Plane_Proyect/Simulacion_Matlab_SolidWorks/Vtol Stallion/MatLab_Simulaciones/cad/Piezas3D/Diseño Avion/Archivos_Fuselaje/Ensamblaje_Fuselaje_Vtol.SLDASM

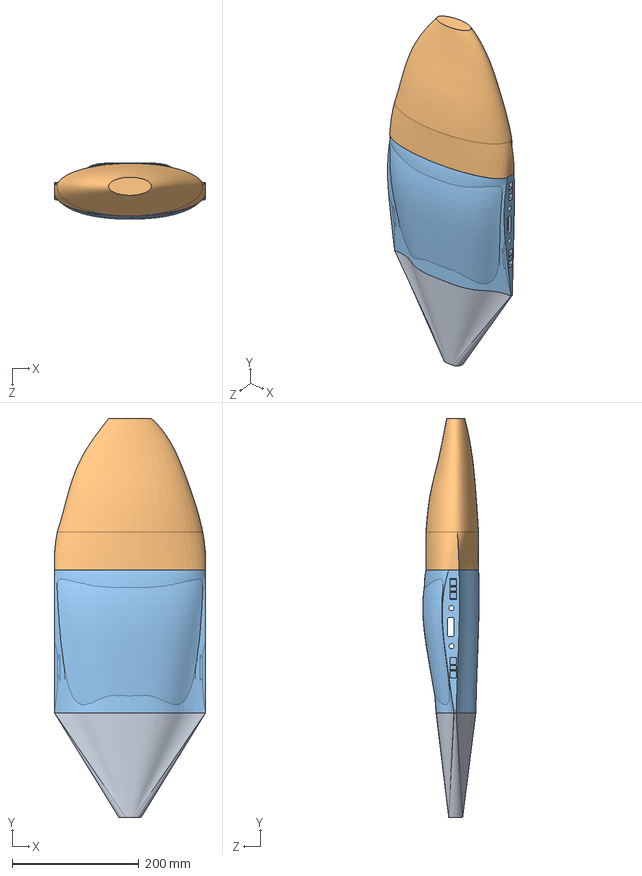
[picture p4: CAD file, 2026-09-22]
Simulacion_Matlab_SolidWorks/Vtol Stallion/MatLab_Simulaciones/cad/Piezas3D/Diseño Avion/Archivos_Fuselaje/Ensamblaje_Fuselaje_Vtol.SLDASM
238.3 x 628.7 x 88.9 mm
Fuselaje_Vtol_Central
Fuselaje_Vtol_Frontal
Fuselaje_Vtol_Trasero
