XavierianAerospace/Plane_Proyect/MECÁNICA/Modelo 3D Avion/Bateria Avion/Ensamblaje distribucion CE.SLDASM

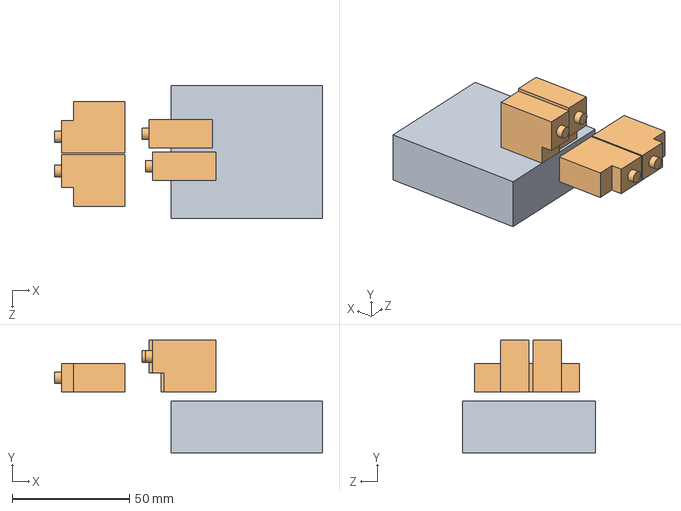
[picture p5: CAD file, 2026-04-06]
MECÁNICA/Modelo 3D Avion/Bateria Avion/Ensamblaje distribucion CE.SLDASM
114.1 x 48.0 x 56.5 mm
servomotor x 4
CPU
