XavierianAerospace/Plane_Proyect/Simulacion_Matlab_SolidWorks/Vtol Stallion/MatLab_Simulaciones/cad/Piezas3D/Diseño Avion/Archivos_SnapFit/ensamble_snapFit.SLDASM

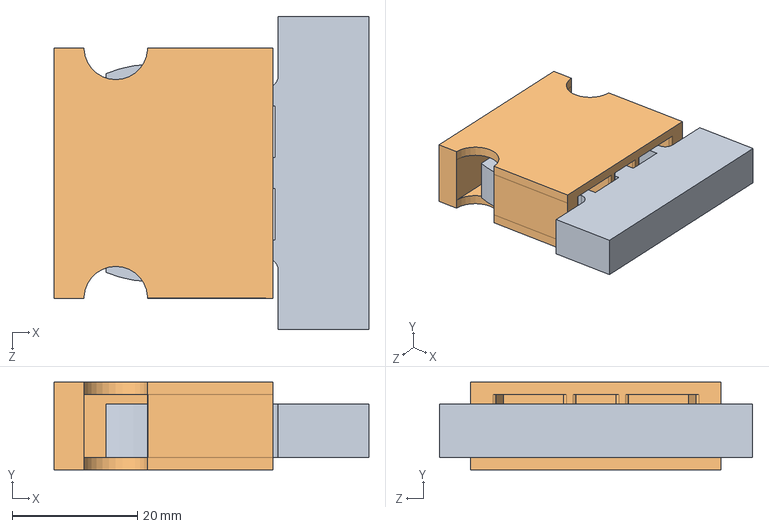
[picture p6: CAD file, 2026-09-22]
Simulacion_Matlab_SolidWorks/Vtol Stallion/MatLab_Simulaciones/cad/Piezas3D/Diseño Avion/Archivos_SnapFit/ensamble_snapFit.SLDASM
50.3 x 14.0 x 50.0 mm
hembra
gancho
