XavierianAerospace/Plane_Proyect/MECÁNICA/Modelo 3D Avion/TREN DE ATERRIZAJE-ACERO/ENSAMBLE TREN DE ATERRIZAJE FIJO.SLDASM

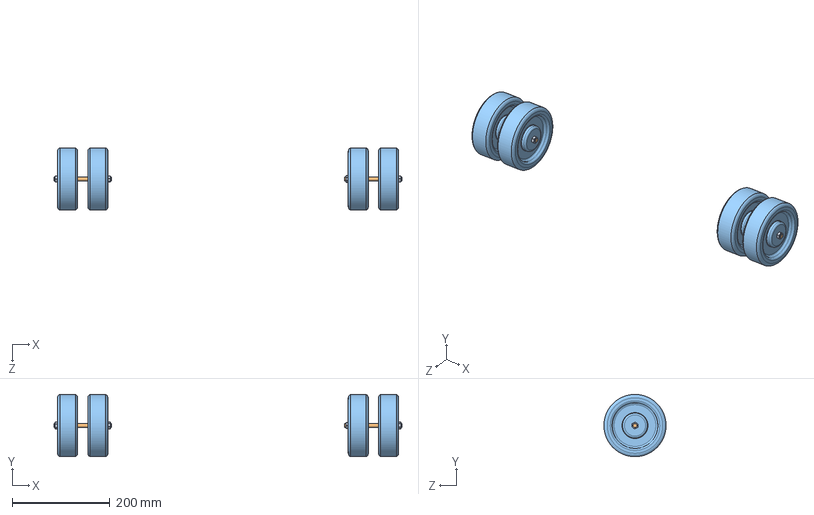
[picture p7: CAD file, 2026-08-14]
MECÁNICA/Modelo 3D Avion/TREN DE ATERRIZAJE-ACERO/ENSAMBLE TREN DE ATERRIZAJE FIJO.SLDASM
710.3 x 126.6 x 127.0 mm
RUEDA x 4
EJE x 2
tuerca x 4
