XavierianAerospace/Plane_Proyect/MECÁNICA/Modelo 3D Avion/TREN DE ATERRIZAJE/tren de aterrizaje delantero.SLDASM

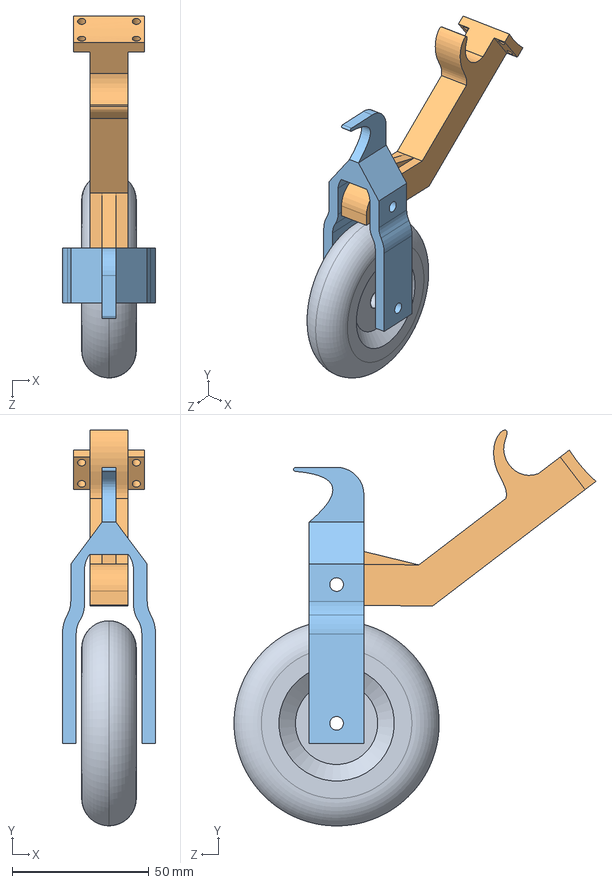
[picture p8: CAD file, 2026-04-15]
MECÁNICA/Modelo 3D Avion/TREN DE ATERRIZAJE/tren de aterrizaje delantero.SLDASM
34.0 x 144.7 x 132.3 mm
nose gear inferior
nose gear superior
rueda avión
