XavierianAerospace/Plane_Proyect/MECÁNICA/Modelo 3D Avion/Estrucutura General/ensamble tren de aterrizaje.SLDASM

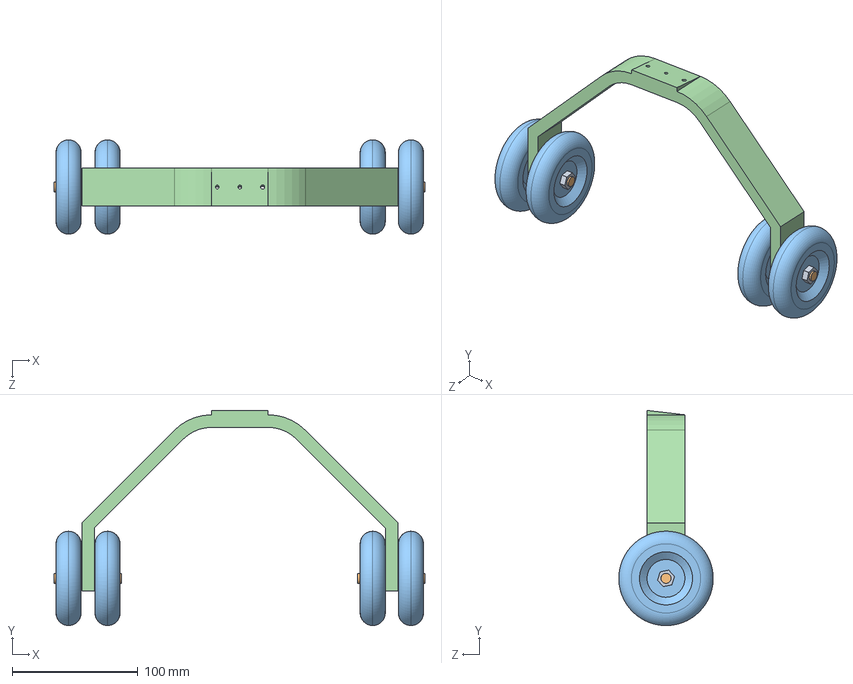
[picture p9: CAD file, 2026-08-14]
MECÁNICA/Modelo 3D Avion/Estrucutura General/ensamble tren de aterrizaje.SLDASM
294.8 x 171.0 x 75.0 mm
cuerpo tren
rueda avión x 4
eje tren de aterrizaje x 2
tuerca x 4
