XavierianAerospace/Plane_Proyect/Electronica/SpeedyBee 2807 1050kV Motor/SpeedyBee 2807 1050kV Motor.SLDASM

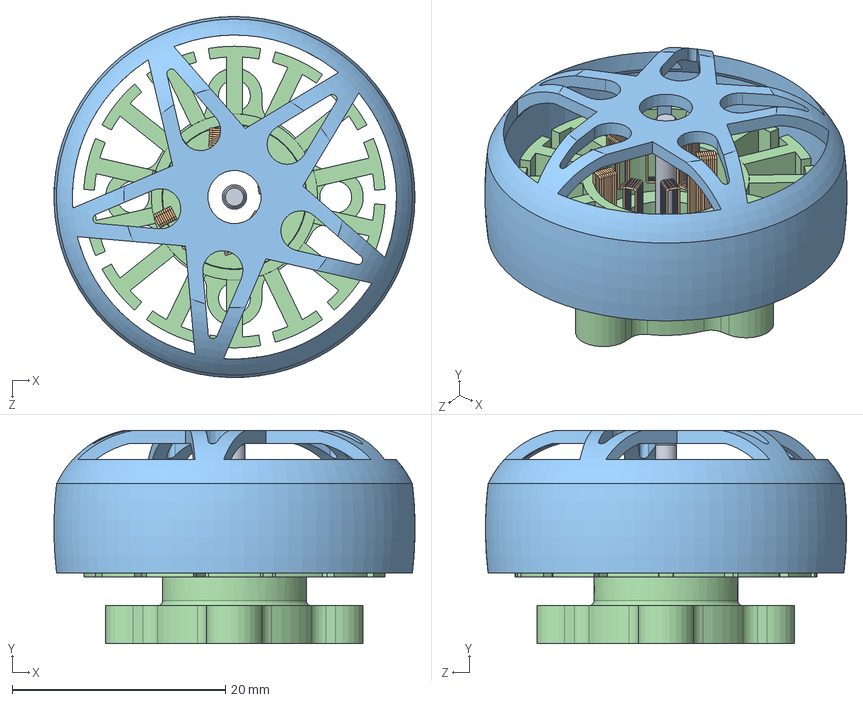
[picture p10: CAD file, 2026-08-14]
Electronica/SpeedyBee 2807 1050kV Motor/SpeedyBee 2807 1050kV Motor.SLDASM
33.9 x 20.0 x 33.9 mm
Stator
Rotor
Coil
Shaft
