XavierianAerospace/Plane_Proyect/Electronica/SpeedyBee 2807 1050kV Motor/Rotor.SLDPRT

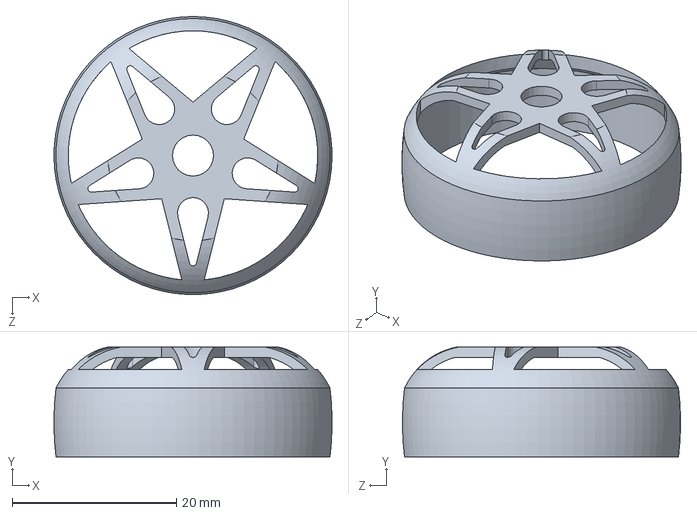
[picture p11: CAD file, 2026-08-14]
Electronica/SpeedyBee 2807 1050kV Motor/Rotor.SLDPRT
33.9 x 13.4 x 33.9 mm
