XavierianAerospace/Plane_Proyect/MECÁNICA/Modelo 3D Avion/Bateria Avion/cuerpo_superior.SLDPRT

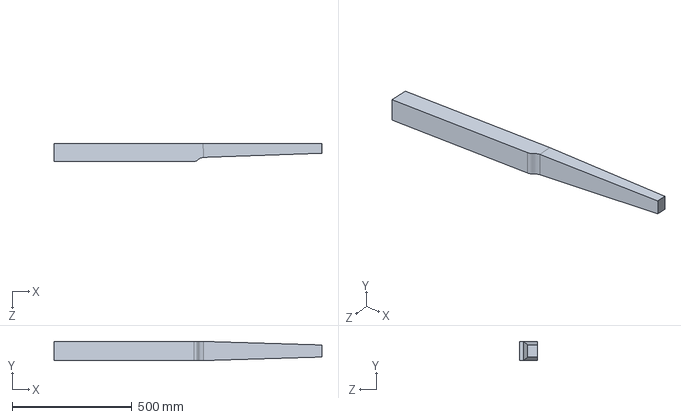
[picture p12: CAD file, 2026-04-15]
MECÁNICA/Modelo 3D Avion/Bateria Avion/cuerpo_superior.SLDPRT
1120.0 x 80.0 x 73.6 mm
