XavierianAerospace/Plane_Proyect/MECÁNICA/Modelo 3D Avion/Estrucutura General/cuerpo tren.SLDPRT

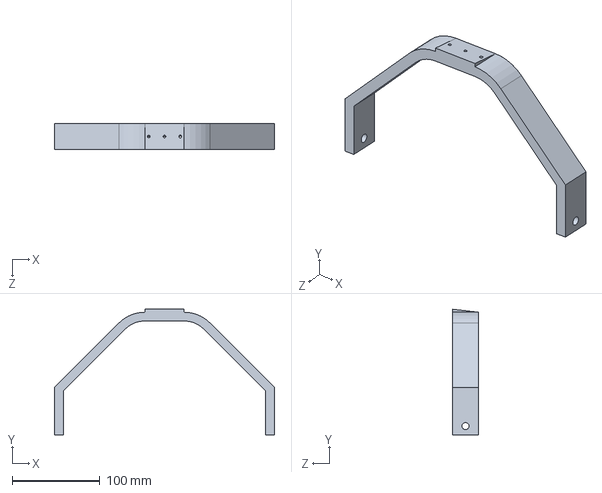
[picture p13: CAD file, 2026-08-14]
MECÁNICA/Modelo 3D Avion/Estrucutura General/cuerpo tren.SLDPRT
251.2 x 143.5 x 30.0 mm
