XavierianAerospace/Plane_Proyect/MECÁNICA/Modelo 3D Avion/TREN DE ATERRIZAJE-ACERO/tuerca.SLDPRT

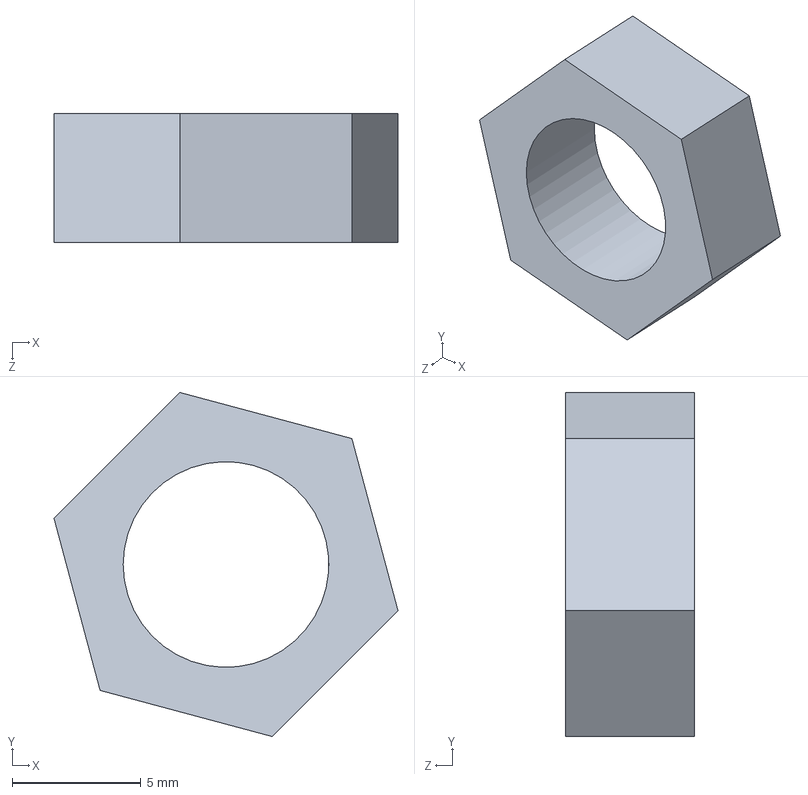
[picture p14: CAD file, 2026-08-14]
MECÁNICA/Modelo 3D Avion/TREN DE ATERRIZAJE-ACERO/tuerca.SLDPRT
13.4 x 13.4 x 5.00 mm
