XavierianAerospace/Plane_Proyect/Prueba thrust/Bracket 40.SLDPRT

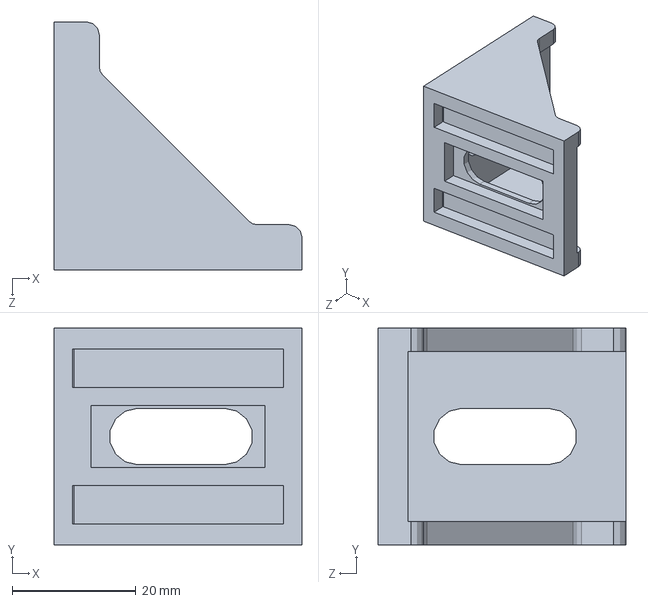
[picture p15: CAD file, 2026-05-09]
Prueba thrust/Bracket 40.SLDPRT
40.0 x 35.0 x 40.0 mm
