XavierianAerospace/Plane_Proyect/Simulacion_Matlab_SolidWorks/Vtol Stallion/MatLab_Simulaciones/cad/componentes_dxf/ELECTRONICA.DXF

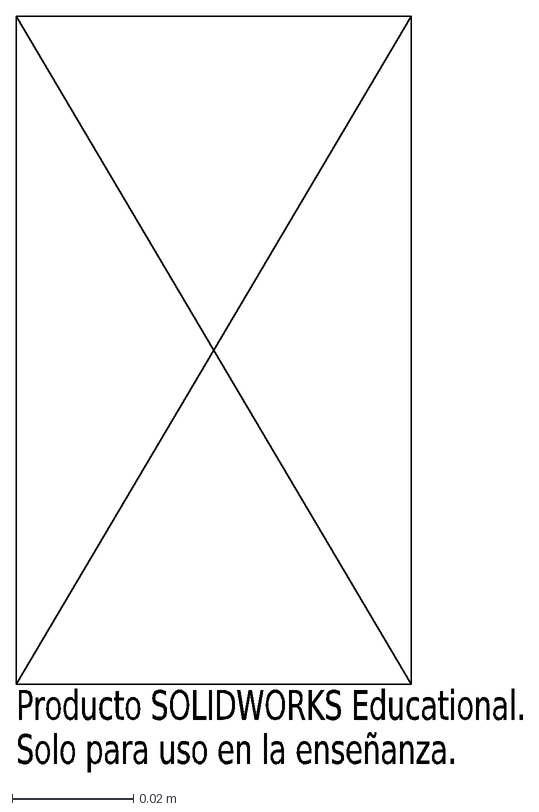
[picture p16: CAD file, 2026-08-14]
Simulacion_Matlab_SolidWorks/Vtol Stallion/MatLab_Simulaciones/cad/componentes_dxf/ELECTRONICA.DXF
Producto SOLIDWORKS Educational.
Solo para uso en la enseñanza.
