XavierianAerospace/Plane_Proyect/Simulacion_Matlab_SolidWorks/Vtol Stallion/MatLab_Simulaciones/cad/estructura_dxf/ALA_DER_FIJA.DXF

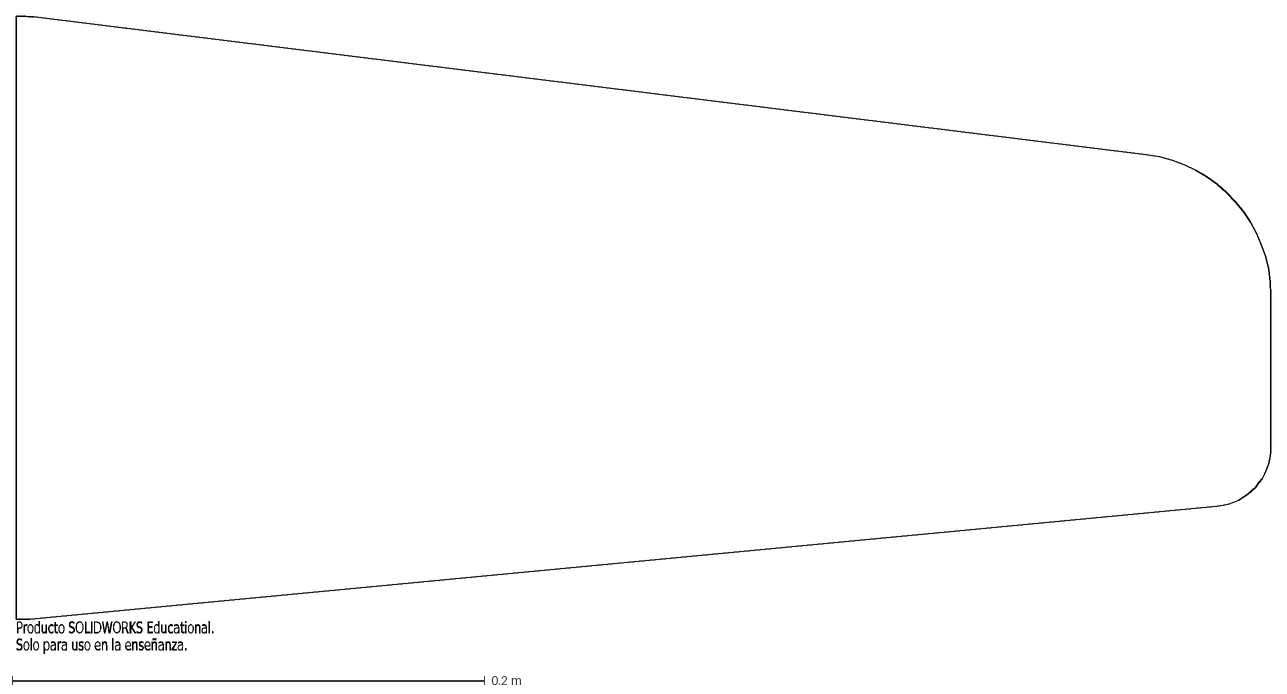
[picture p17: CAD file, 2026-08-14]
Simulacion_Matlab_SolidWorks/Vtol Stallion/MatLab_Simulaciones/cad/estructura_dxf/ALA_DER_FIJA.DXF
Producto SOLIDWORKS Educational.
Solo para uso en la enseñanza.
