XavierianAerospace/Plane_Proyect/Simulacion_Matlab_SolidWorks/Vtol Stallion/MatLab_Simulaciones/cad/Piezas3D/Diseño Avion/Archivos_Fuselaje/Fuselaje_Vtol_Central.SLDPRT

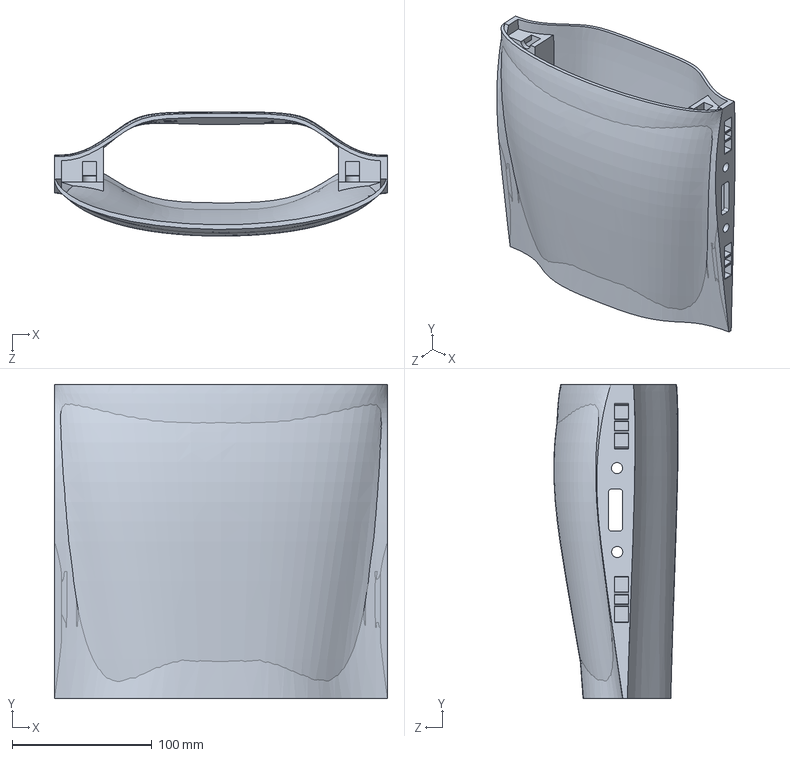
[picture p18: CAD file, 2026-09-22]
Simulacion_Matlab_SolidWorks/Vtol Stallion/MatLab_Simulaciones/cad/Piezas3D/Diseño Avion/Archivos_Fuselaje/Fuselaje_Vtol_Central.SLDPRT
238.3 x 225.0 x 88.9 mm
