XavierianAerospace/Plane_Proyect/Simulacion_Matlab_SolidWorks/Vtol Stallion/MatLab_Simulaciones/cad/Piezas3D/Diseño Avion/Archivos_SnapFit/gancho.SLDPRT

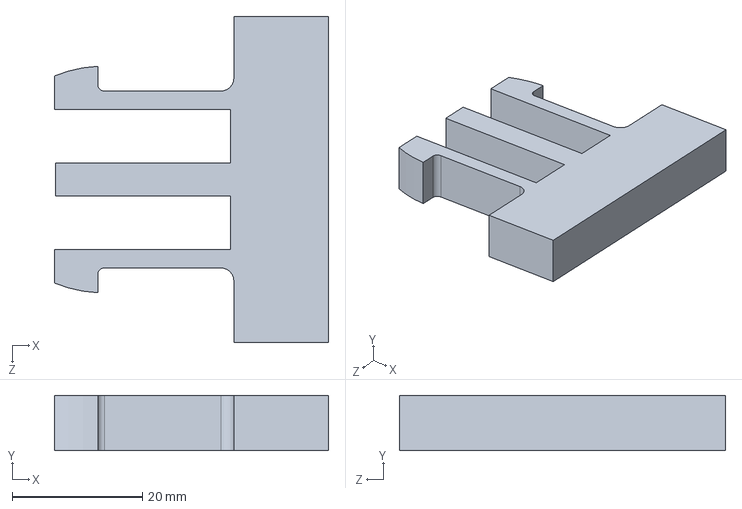
[picture p19: CAD file, 2026-09-22]
Simulacion_Matlab_SolidWorks/Vtol Stallion/MatLab_Simulaciones/cad/Piezas3D/Diseño Avion/Archivos_SnapFit/gancho.SLDPRT
42.0 x 8.50 x 50.0 mm
