XavierianAerospace/Plane_Proyect/Simulacion_Matlab_SolidWorks/Vtol Stallion/MatLab_Simulaciones/cad/Piezas3D/Diseño Avion/Archvivos_Alas/Ensamblaje Alas y Flaps/Ala_Vtol_Primera_Etapa.SLDPRT

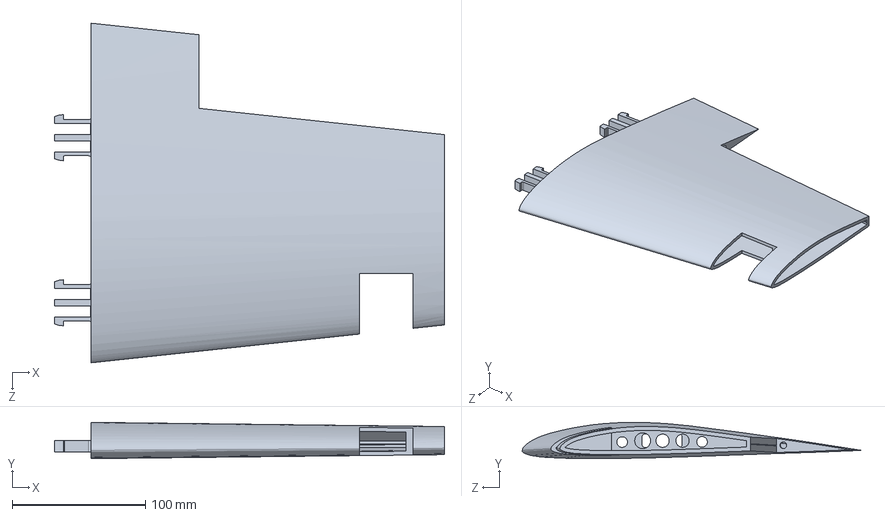
[picture p20: CAD file, 2026-09-22]
Simulacion_Matlab_SolidWorks/Vtol Stallion/MatLab_Simulaciones/cad/Piezas3D/Diseño Avion/Archvivos_Alas/Ensamblaje Alas y Flaps/Ala_Vtol_Primera_Etapa.SLDPRT
292.9 x 27.3 x 255.1 mm
