XavierianAerospace/Plane_Proyect/Electronica/SpeedyBee 2807 1050kV Motor/Stator.SLDPRT

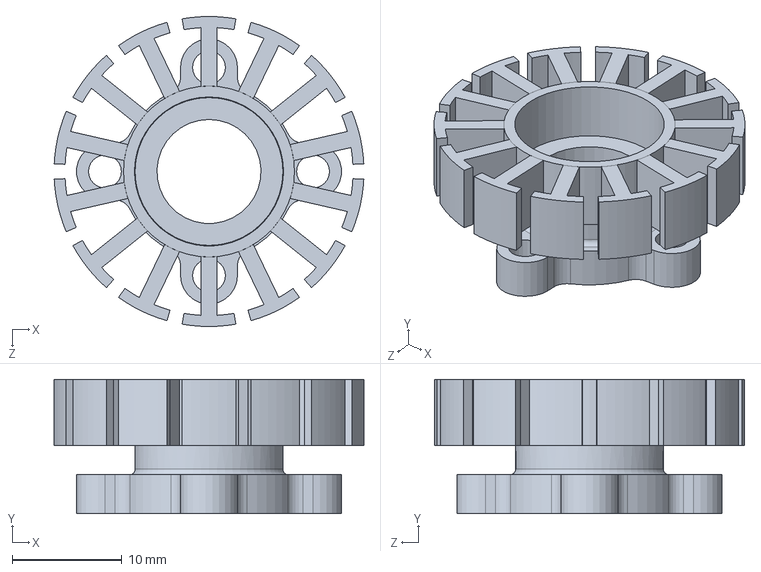
[picture p22: CAD file, 2026-08-14]
Electronica/SpeedyBee 2807 1050kV Motor/Stator.SLDPRT
28.3 x 12.3 x 28.3 mm
