XavierianAerospace/Plane_Proyect/MECÁNICA/Modelo 3D Avion/Bateria Avion/servomotor.SLDPRT

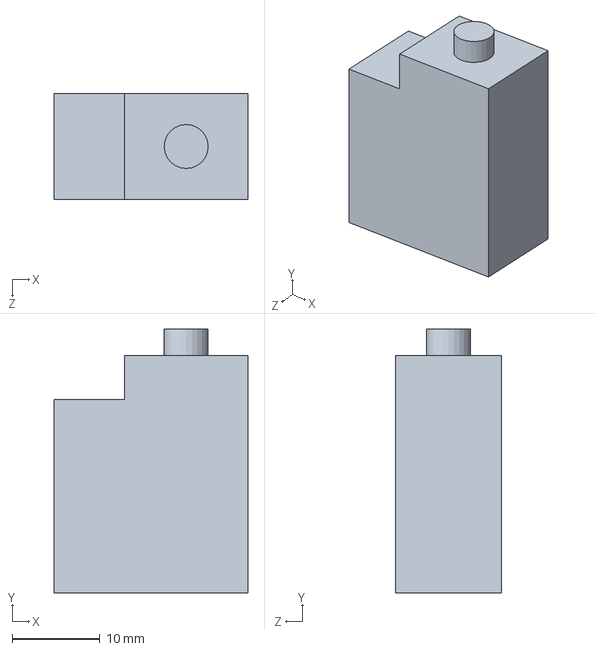
[picture p23: CAD file, 2026-04-06]
MECÁNICA/Modelo 3D Avion/Bateria Avion/servomotor.SLDPRT
22.0 x 30.0 x 12.0 mm
