XavierianAerospace/Plane_Proyect/MECÁNICA/Modelo 3D Avion/Estrucutura General/rueda avión.SLDPRT

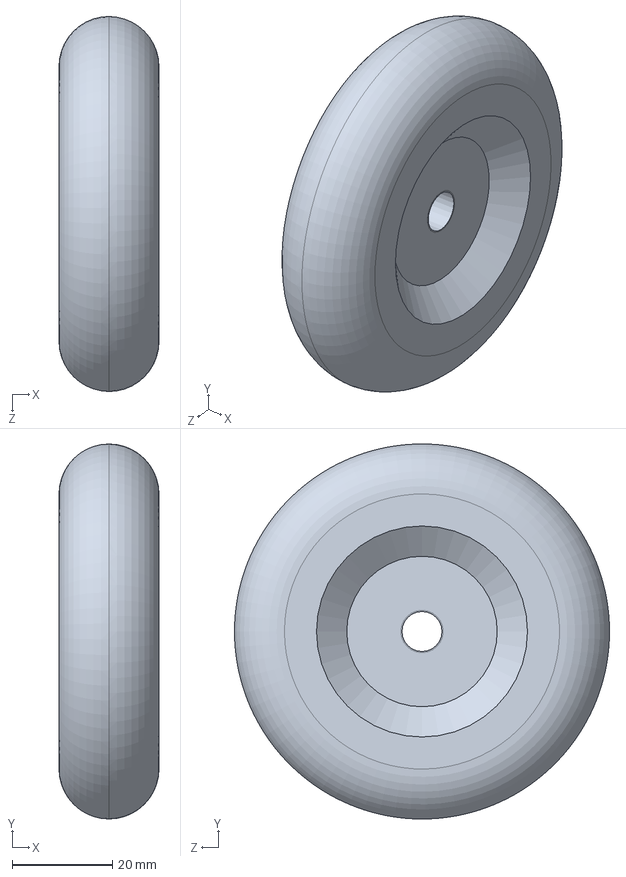
[picture p24: CAD file, 2026-08-14]
MECÁNICA/Modelo 3D Avion/Estrucutura General/rueda avión.SLDPRT
20.0 x 75.0 x 75.0 mm
