XavierianAerospace/Plane_Proyect/MECÁNICA/Modelo 3D Avion/TREN DE ATERRIZAJE-ACERO/EJE.SLDPRT

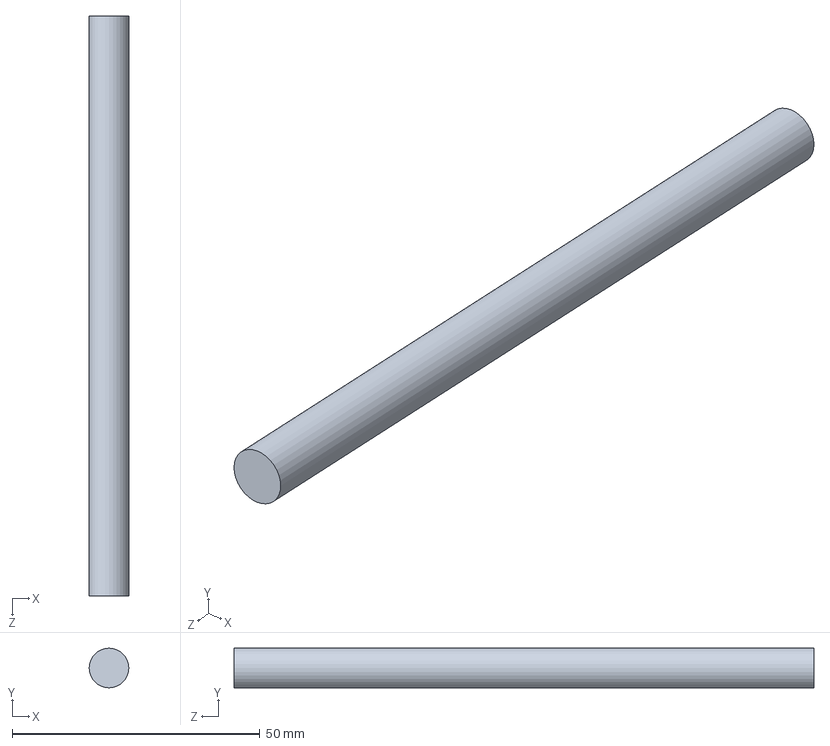
[picture p25: CAD file, 2026-08-14]
MECÁNICA/Modelo 3D Avion/TREN DE ATERRIZAJE-ACERO/EJE.SLDPRT
8.00 x 8.00 x 117.0 mm
