XavierianAerospace/Plane_Proyect/MECÁNICA/Modelo 3D Avion/TREN DE ATERRIZAJE/nose gear superior.SLDPRT

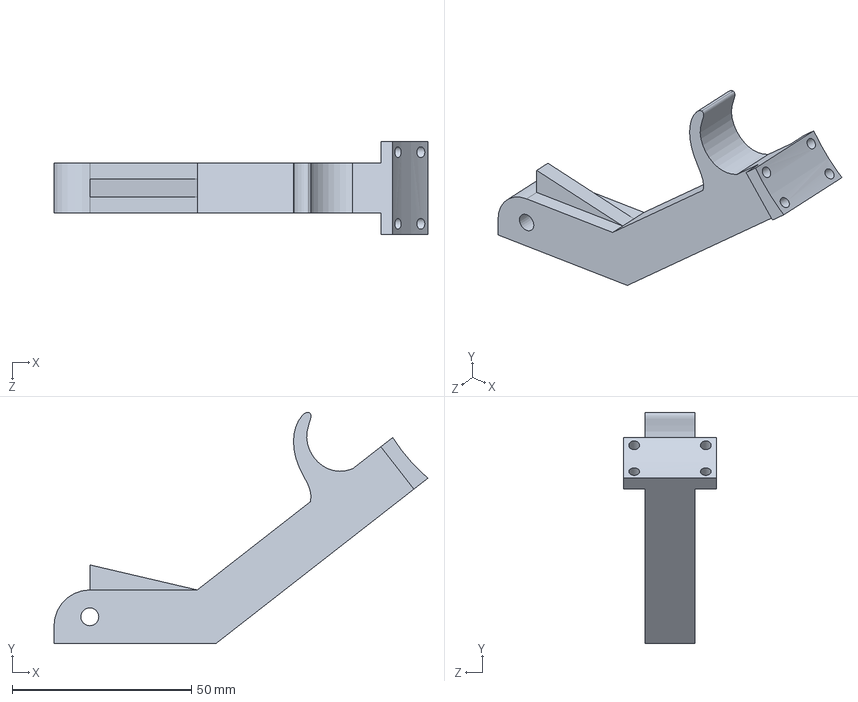
[picture p26: CAD file, 2026-04-15]
MECÁNICA/Modelo 3D Avion/TREN DE ATERRIZAJE/nose gear superior.SLDPRT
104.4 x 64.6 x 26.0 mm
