XavierianAerospace/Plane_Proyect/Prueba thrust/Plugs_soporte_motor.SLDPRT

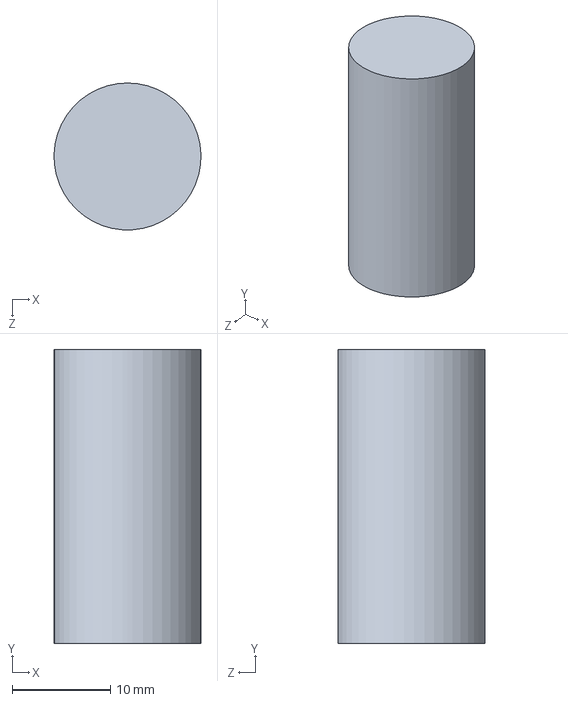
[picture p27: CAD file, 2026-05-09]
Prueba thrust/Plugs_soporte_motor.SLDPRT
15.0 x 30.0 x 15.0 mm
