XavierianAerospace/Plane_Proyect/Simulacion_Matlab_SolidWorks/Vtol Stallion/MatLab_Simulaciones/cad/estructura_dxf/ELEVON_COLA_DER.DXF

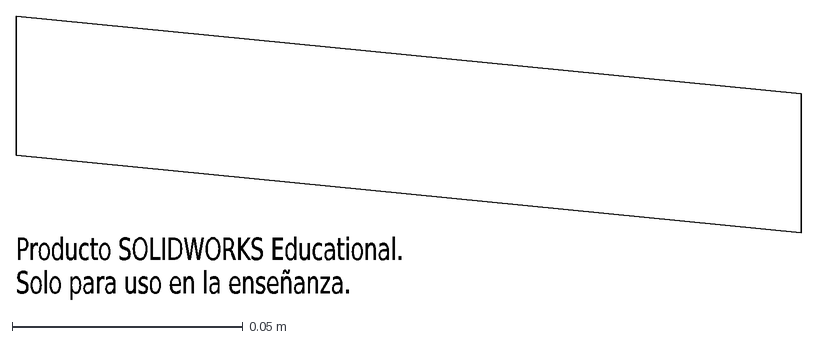
[picture p29: CAD file, 2026-08-14]
Simulacion_Matlab_SolidWorks/Vtol Stallion/MatLab_Simulaciones/cad/estructura_dxf/ELEVON_COLA_DER.DXF
Producto SOLIDWORKS Educational.
Solo para uso en la enseñanza.
