XavierianAerospace/Plane_Proyect/Simulacion_Matlab_SolidWorks/Vtol Stallion/MatLab_Simulaciones/cad/Piezas3D/Diseño Avion/Archivos_Cola/flap_cola.SLDPRT

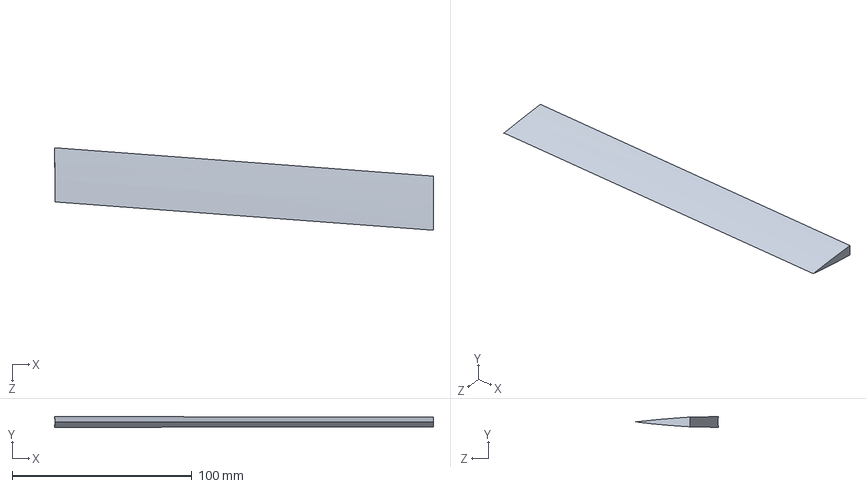
[picture p30: CAD file, 2026-09-08]
Simulacion_Matlab_SolidWorks/Vtol Stallion/MatLab_Simulaciones/cad/Piezas3D/Diseño Avion/Archivos_Cola/flap_cola.SLDPRT
211.1 x 6.03 x 46.0 mm
