XavierianAerospace/Plane_Proyect/Simulacion_Matlab_SolidWorks/Vtol Stallion/MatLab_Simulaciones_Actualizado/cad/componentes_dxf/MOTOR_IZQ.DXF

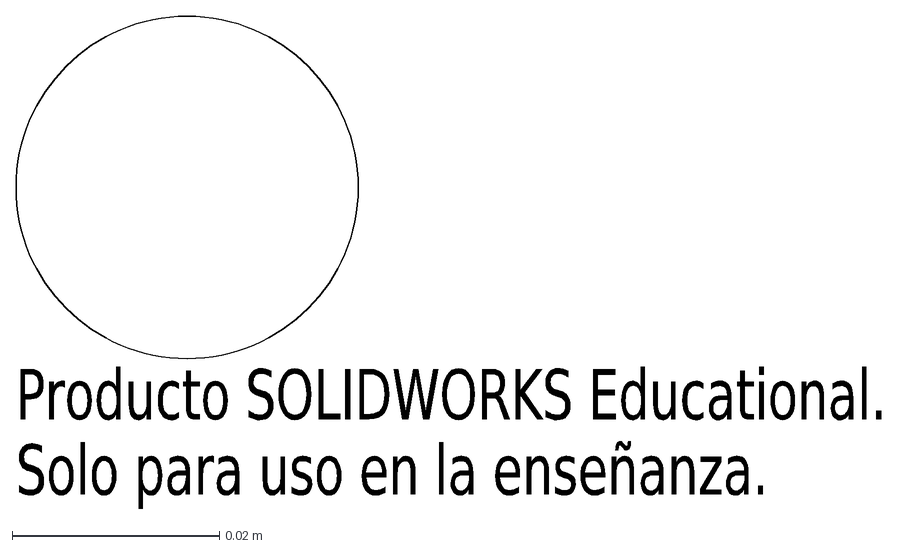
[picture p32: CAD file, 2026-08-14]
Simulacion_Matlab_SolidWorks/Vtol Stallion/MatLab_Simulaciones_Actualizado/cad/componentes_dxf/MOTOR_IZQ.DXF
Producto SOLIDWORKS Educational.
Solo para uso en la enseñanza.
