XavierianAerospace/Plane_Proyect/Electronica/SpeedyBee 2807 1050kV Motor/Shaft.SLDPRT

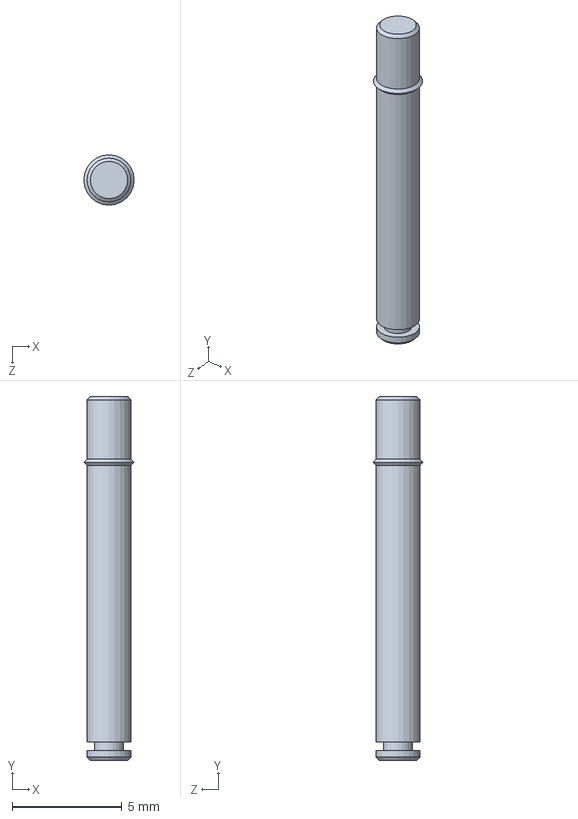
[picture p34: CAD file, 2026-08-14]
Electronica/SpeedyBee 2807 1050kV Motor/Shaft.SLDPRT
2.30 x 16.6 x 2.30 mm
