XavierianAerospace/Plane_Proyect/MECÁNICA/Modelo 3D Avion/Estrucutura General/eje tren de aterrizaje.SLDPRT

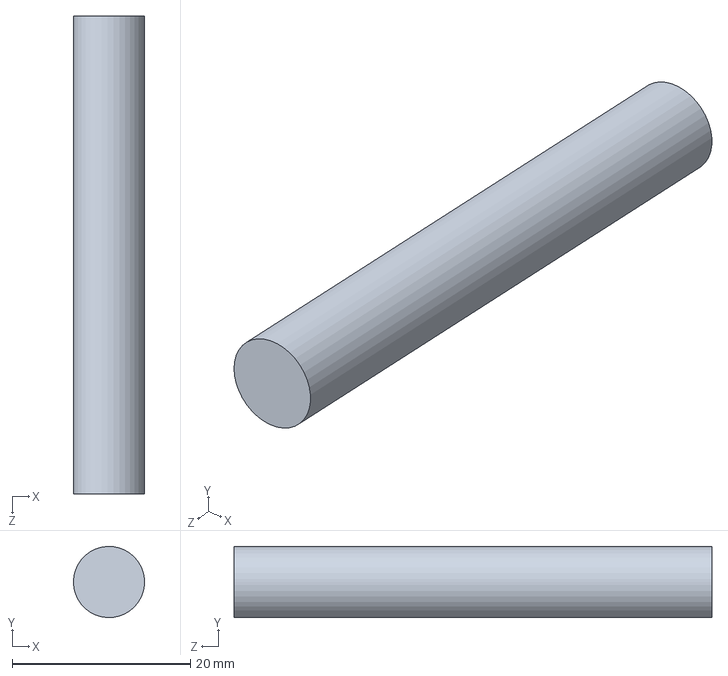
[picture p35: CAD file, 2026-08-14]
MECÁNICA/Modelo 3D Avion/Estrucutura General/eje tren de aterrizaje.SLDPRT
8.00 x 7.99 x 53.7 mm
