XavierianAerospace/Plane_Proyect/MECÁNICA/Modelo 3D Avion/TREN DE ATERRIZAJE-ACERO/RUEDA.SLDPRT

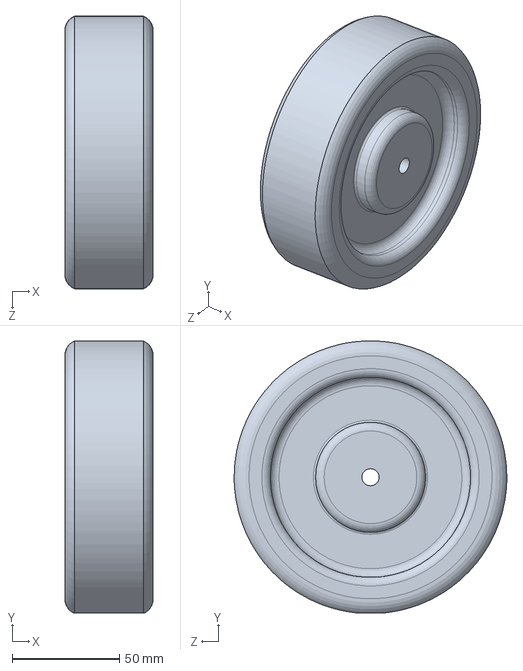
[picture p36: CAD file, 2026-08-14]
MECÁNICA/Modelo 3D Avion/TREN DE ATERRIZAJE-ACERO/RUEDA.SLDPRT
41.0 x 126.6 x 127.0 mm
