XavierianAerospace/Plane_Proyect/MECÁNICA/Modelo 3D Avion/TREN DE ATERRIZAJE/nose gear inferior.SLDPRT

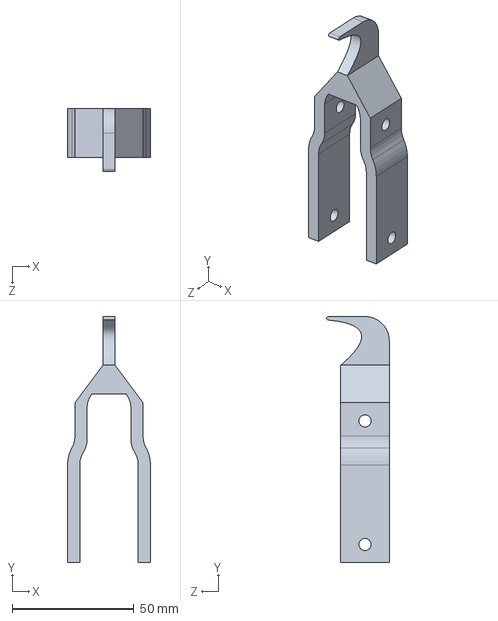
[picture p37: CAD file, 2026-04-15]
MECÁNICA/Modelo 3D Avion/TREN DE ATERRIZAJE/nose gear inferior.SLDPRT
34.0 x 101.0 x 25.8 mm
