XavierianAerospace/Plane_Proyect/Prueba thrust/SK6.SLDPRT

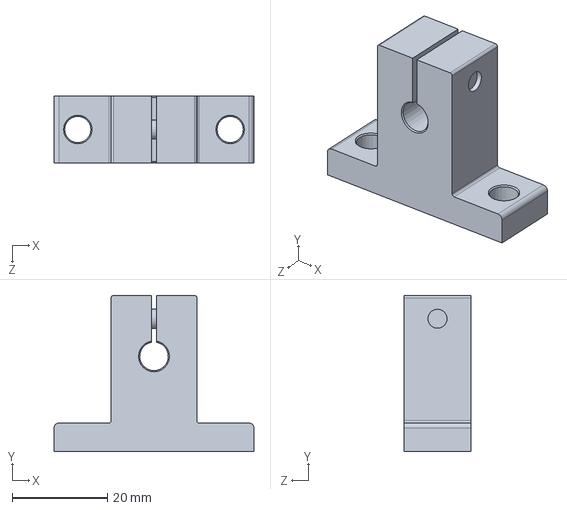
[picture p38: CAD file, 2026-05-09]
Prueba thrust/SK6.SLDPRT
42.0 x 32.8 x 14.0 mm
