XavierianAerospace/Plane_Proyect/Simulacion_Matlab_SolidWorks/Vtol Stallion/MatLab_Simulaciones/cad/Piezas3D/Diseño Avion/Archivos_Cola/cola vtol.SLDPRT

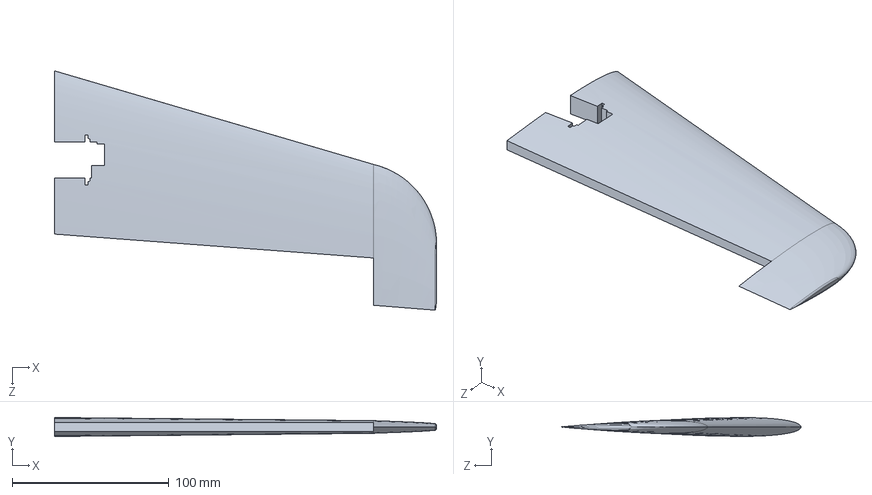
[picture p40: CAD file, 2026-09-08]
Simulacion_Matlab_SolidWorks/Vtol Stallion/MatLab_Simulaciones/cad/Piezas3D/Diseño Avion/Archivos_Cola/cola vtol.SLDPRT
243.6 x 12.1 x 152.6 mm
