XavierianAerospace/Plane_Proyect/Simulacion_Matlab_SolidWorks/Vtol Stallion/MatLab_Simulaciones/cad/Piezas3D/Diseño Avion/Archivos_Fuselaje/Fuselaje_Vtol_Trasero.SLDPRT

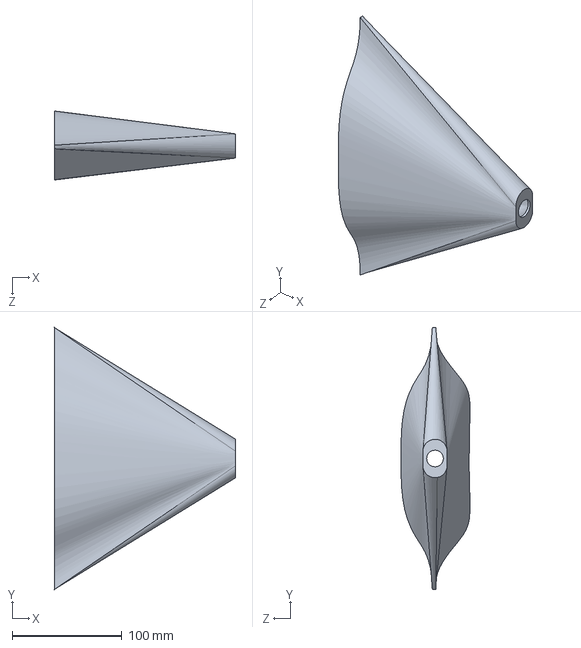
[picture p41: CAD file, 2026-08-23]
Simulacion_Matlab_SolidWorks/Vtol Stallion/MatLab_Simulaciones/cad/Piezas3D/Diseño Avion/Archivos_Fuselaje/Fuselaje_Vtol_Trasero.SLDPRT
165.0 x 238.3 x 62.8 mm
