XavierianAerospace/Plane_Proyect/Simulacion_Matlab_SolidWorks/Vtol Stallion/MatLab_Simulaciones/cad/Piezas3D/Diseño Avion/Archivos_servos/cabeza_servo.SLDPRT

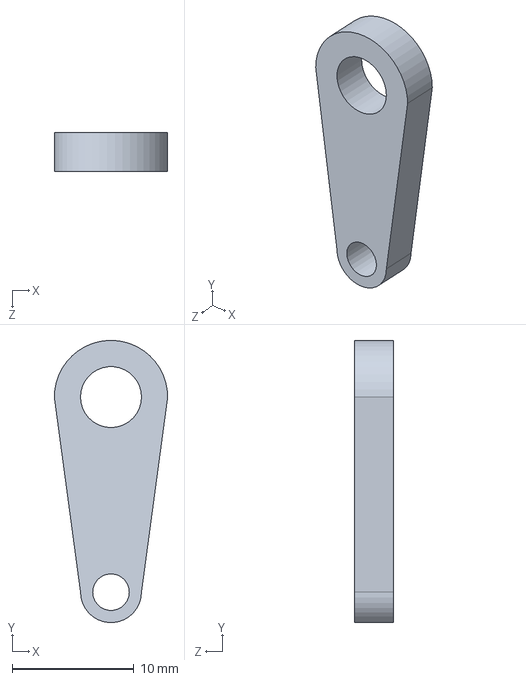
[picture p42: CAD file, 2026-08-17]
Simulacion_Matlab_SolidWorks/Vtol Stallion/MatLab_Simulaciones/cad/Piezas3D/Diseño Avion/Archivos_servos/cabeza_servo.SLDPRT
9.30 x 23.1 x 3.20 mm
