XavierianAerospace/Plane_Proyect/Simulacion_Matlab_SolidWorks/Vtol Stallion/MatLab_Simulaciones_Actualizado/cad/estructura_dxf/FUSELAJE.DXF

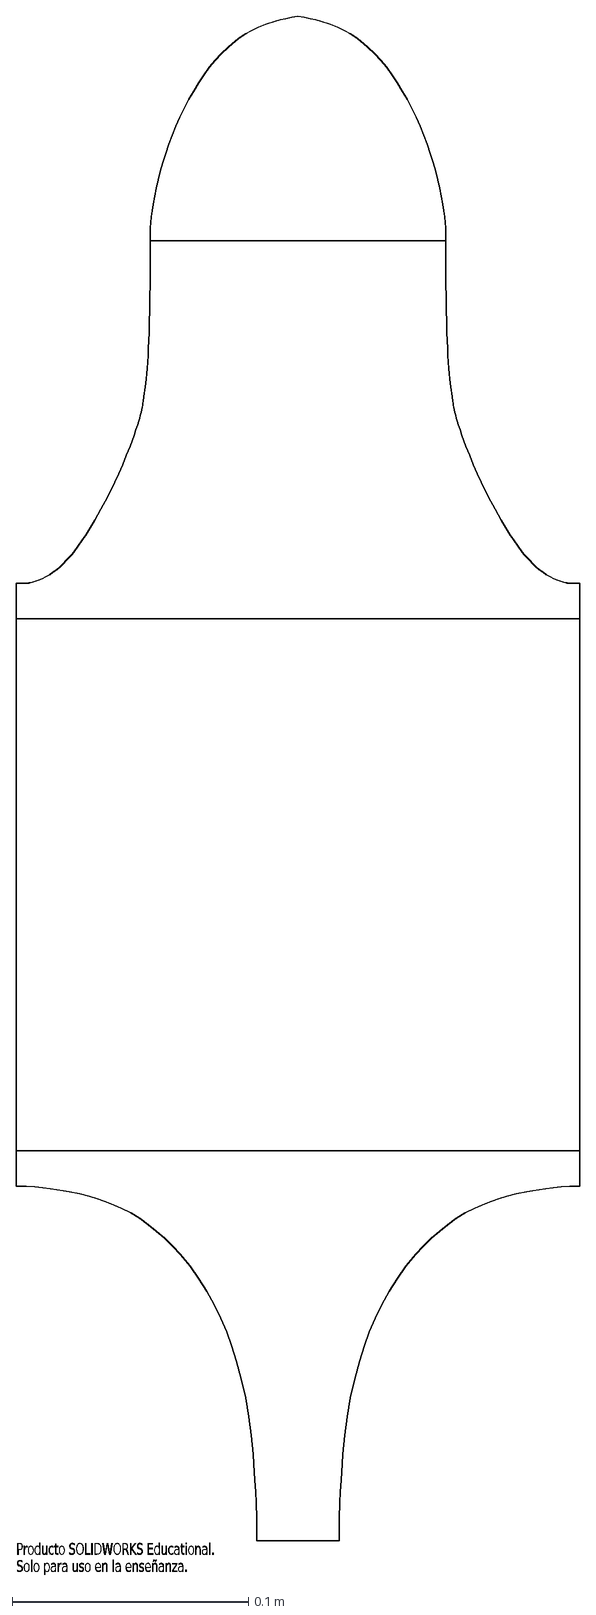
[picture p43: CAD file, 2026-08-14]
Simulacion_Matlab_SolidWorks/Vtol Stallion/MatLab_Simulaciones_Actualizado/cad/estructura_dxf/FUSELAJE.DXF
Producto SOLIDWORKS Educational.
Solo para uso en la enseñanza.
