XavierianAerospace/Plane_Proyect/Electronica/Matek F405.step.SLDPRT

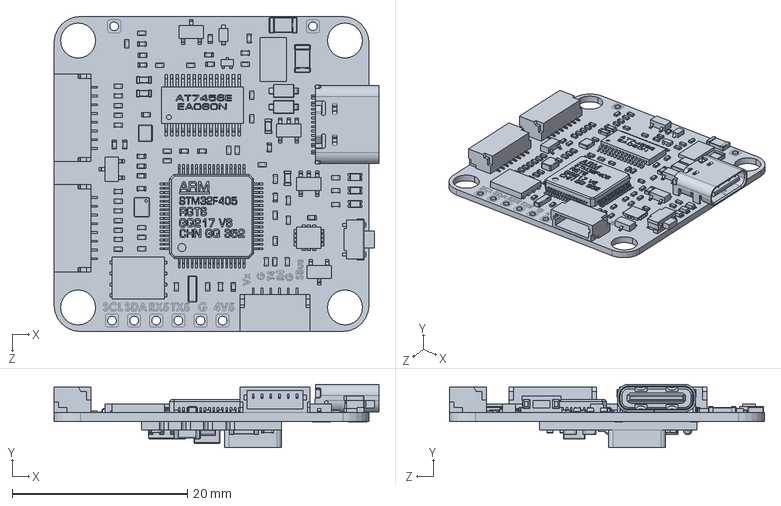
[picture p44: CAD file, 2026-08-14]
Electronica/Matek F405.step.SLDPRT
37.1 x 7.26 x 36.0 mm
