XavierianAerospace/Plane_Proyect/MECÁNICA/Modelo 3D Avion/Bateria Avion/CPU.SLDPRT

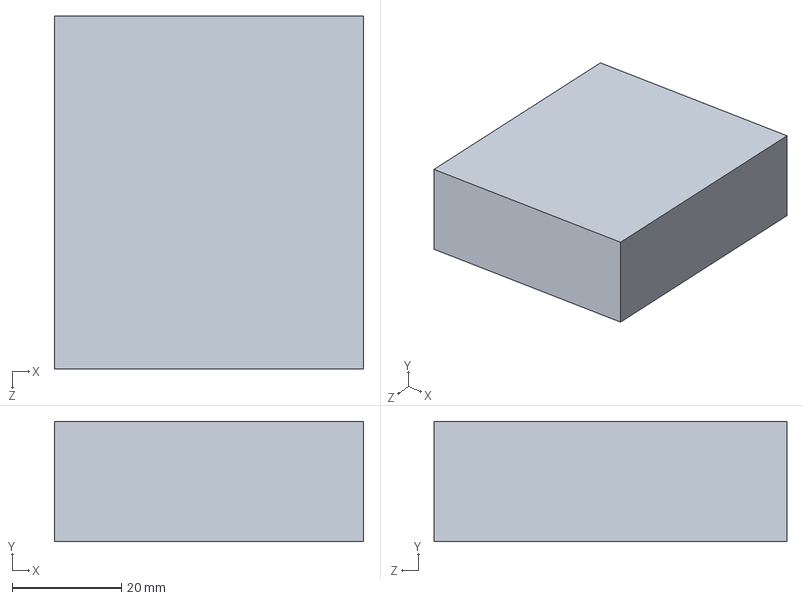
[picture p45: CAD file, 2026-04-06]
MECÁNICA/Modelo 3D Avion/Bateria Avion/CPU.SLDPRT
56.5 x 22.0 x 64.5 mm
