XavierianAerospace/Plane_Proyect/Prueba thrust/Base1.SLDPRT

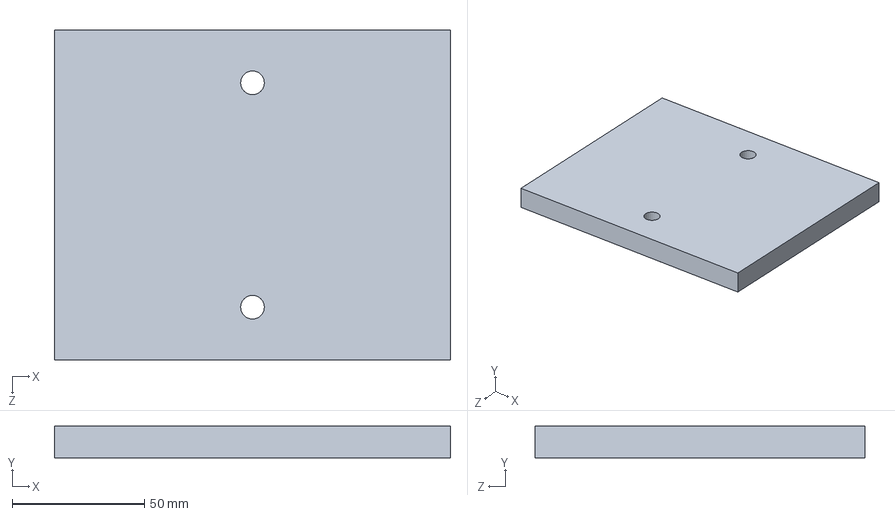
[picture p46: CAD file, 2026-05-09]
Prueba thrust/Base1.SLDPRT
150.0 x 12.0 x 125.0 mm
