XavierianAerospace/Plane_Proyect/Simulacion_Matlab_SolidWorks/Vtol Stallion/MatLab_Simulaciones/cad/componentes_dxf/SERVO_MOTOR_IZQ.DXF

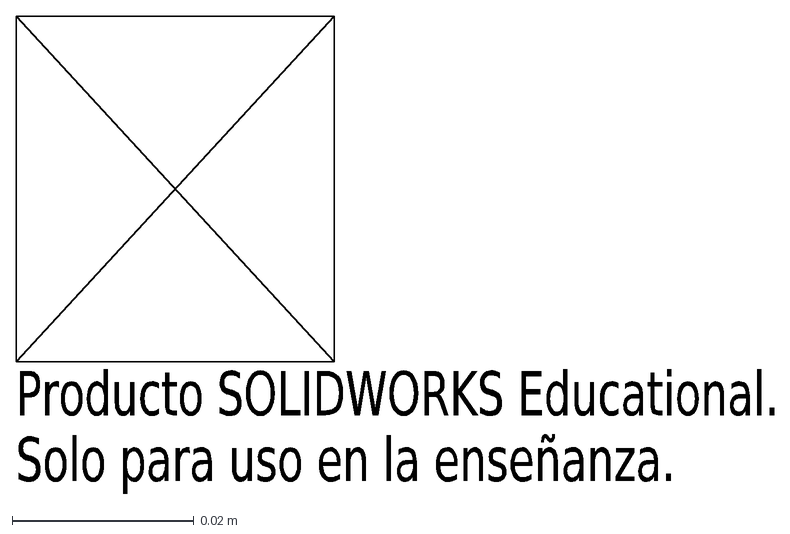
[picture p47: CAD file, 2026-08-14]
Simulacion_Matlab_SolidWorks/Vtol Stallion/MatLab_Simulaciones/cad/componentes_dxf/SERVO_MOTOR_IZQ.DXF
Producto SOLIDWORKS Educational.
Solo para uso en la enseñanza.
