XavierianAerospace/Plane_Proyect/Simulacion_Matlab_SolidWorks/Vtol Stallion/MatLab_Simulaciones/cad/estructura_dxf/ELEVON_COLA_IZQ.DXF

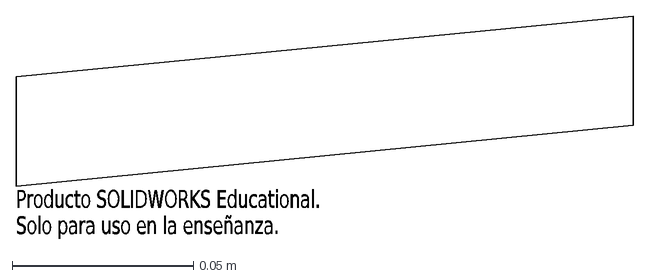
[picture p48: CAD file, 2026-08-14]
Simulacion_Matlab_SolidWorks/Vtol Stallion/MatLab_Simulaciones/cad/estructura_dxf/ELEVON_COLA_IZQ.DXF
Producto SOLIDWORKS Educational.
Solo para uso en la enseñanza.
