XavierianAerospace/Plane_Proyect/Simulacion_Matlab_SolidWorks/Vtol Stallion/MatLab_Simulaciones/cad/Piezas3D/Diseño Avion/Archivos_Cola/cuerpo de cola.SLDPRT

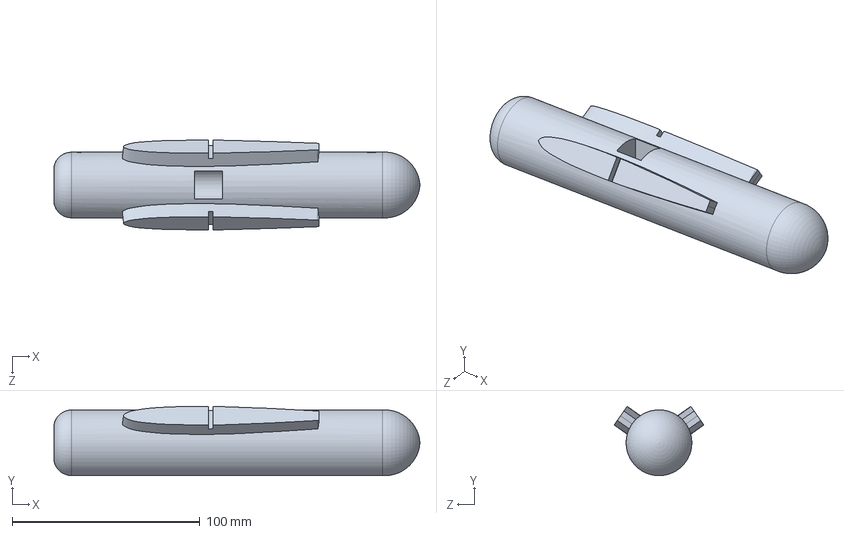
[picture p49: CAD file, 2026-08-17]
Simulacion_Matlab_SolidWorks/Vtol Stallion/MatLab_Simulaciones/cad/Piezas3D/Diseño Avion/Archivos_Cola/cuerpo de cola.SLDPRT
194.8 x 36.8 x 47.8 mm
