XavierianAerospace/Plane_Proyect/Simulacion_Matlab_SolidWorks/Vtol Stallion/MatLab_Simulaciones/cad/Piezas3D/Diseño Avion/Archivos_Fuselaje/Fuselaje_Vtol_Frontal.SLDPRT

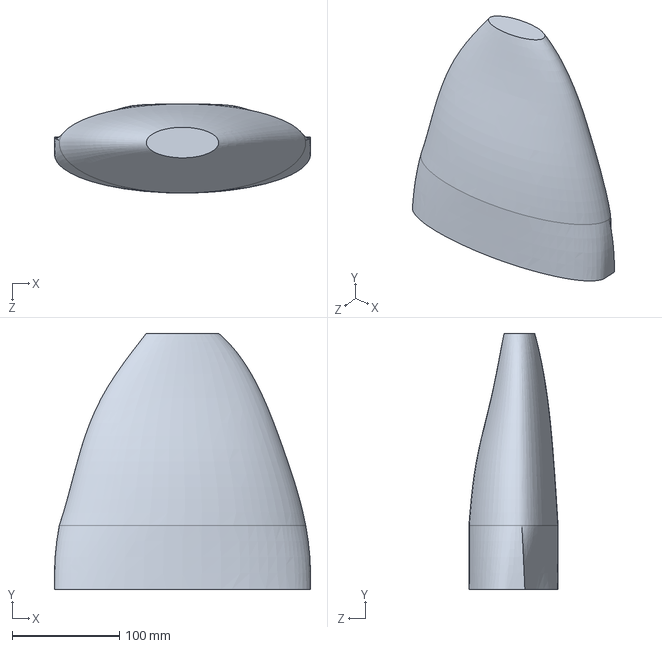
[picture p50: CAD file, 2026-08-14]
Simulacion_Matlab_SolidWorks/Vtol Stallion/MatLab_Simulaciones/cad/Piezas3D/Diseño Avion/Archivos_Fuselaje/Fuselaje_Vtol_Frontal.SLDPRT
238.3 x 238.7 x 83.0 mm
