XavierianAerospace/Plane_Proyect/Electronica/FlyColor_X-Cross_HV 3_120A_5-12S.stp.SLDPRT

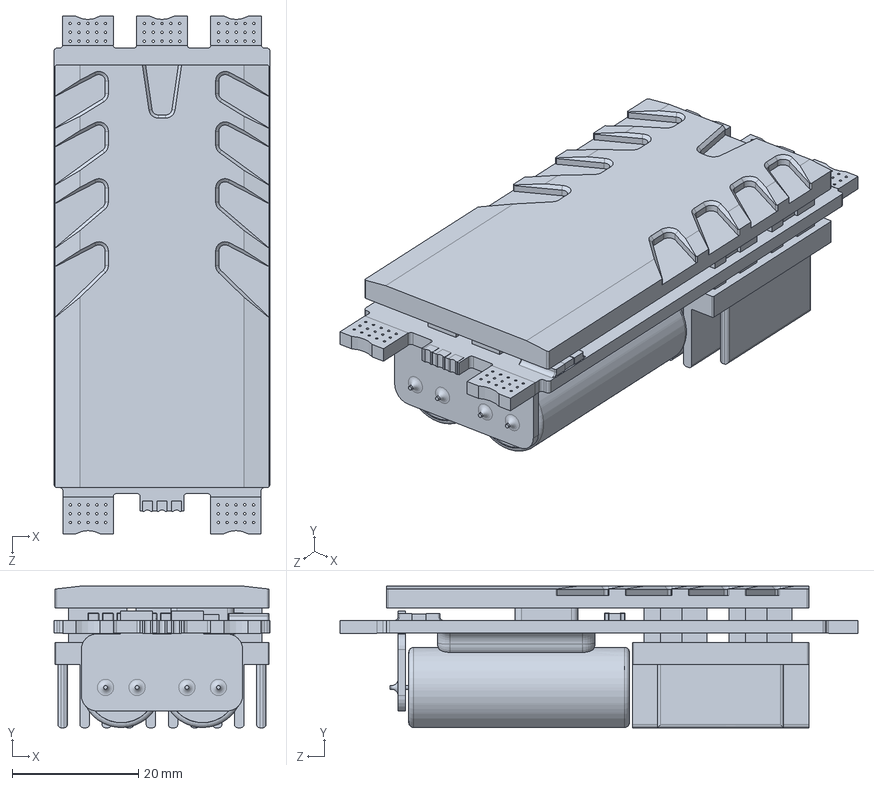
[picture p53: CAD file, 2026-08-14]
Electronica/FlyColor_X-Cross_HV 3_120A_5-12S.stp.SLDPRT
34.2 x 22.5 x 82.1 mm
