XavierianAerospace/Plane_Proyect/Electronica/SpeedyBee 2807 1050kV Motor/Coil.SLDPRT

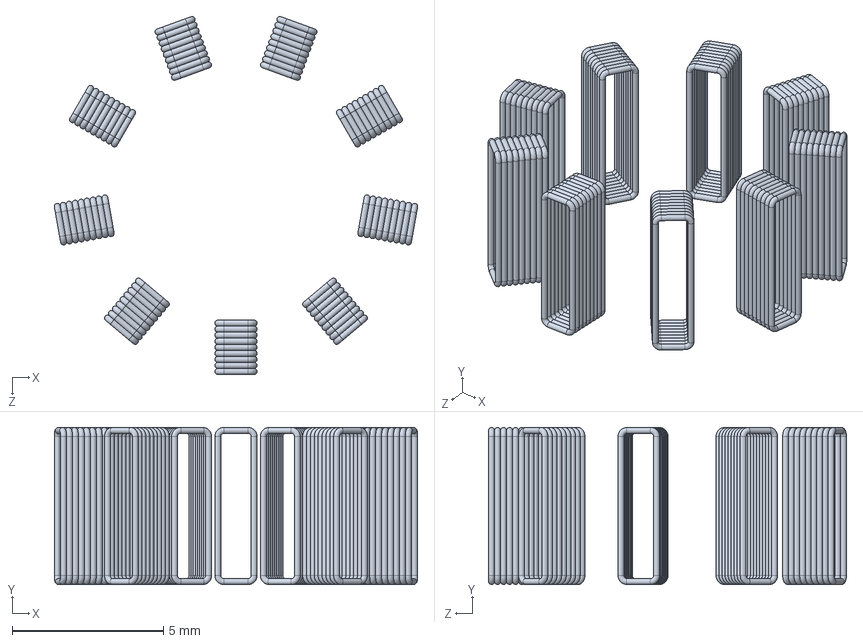
[picture p54: CAD file, 2026-08-14]
Electronica/SpeedyBee 2807 1050kV Motor/Coil.SLDPRT
12.0 x 5.20 x 11.8 mm
