XavierianAerospace/Plane_Proyect/MECÁNICA/Modelo 3D Avion/Bateria Avion/Tabla.SLDPRT

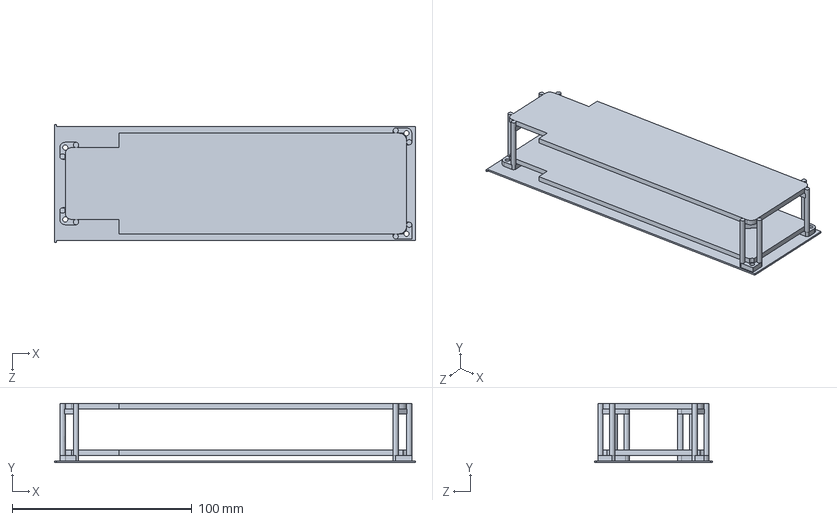
[picture p55: CAD file, 2026-04-06]
MECÁNICA/Modelo 3D Avion/Bateria Avion/Tabla.SLDPRT
201.0 x 33.0 x 65.5 mm
