XavierianAerospace/Plane_Proyect/MECÁNICA/Modelo 3D Avion/TREN DE ATERRIZAJE-ACERO/CUERPO TREN DE ATERRIZAJE FIJO.SLDPRT

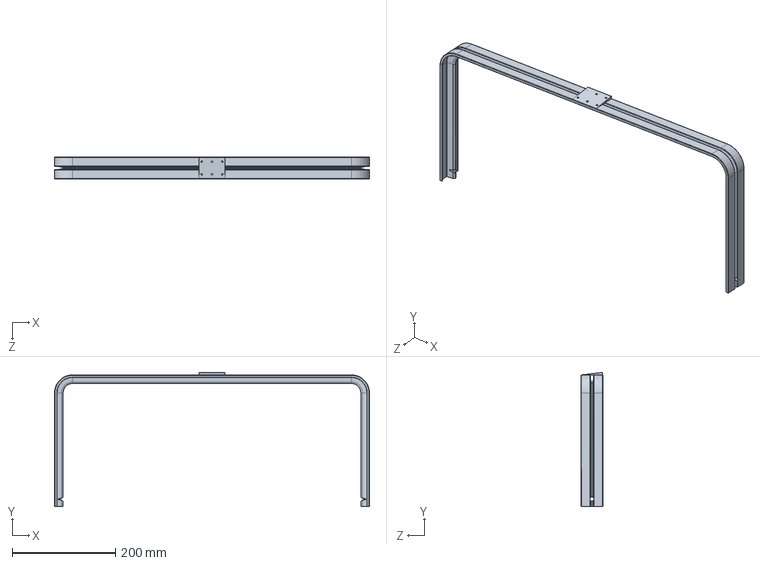
[picture p56: CAD file, 2026-08-14]
MECÁNICA/Modelo 3D Avion/TREN DE ATERRIZAJE-ACERO/CUERPO TREN DE ATERRIZAJE FIJO.SLDPRT
610.0 x 259.7 x 43.0 mm
