XavierianAerospace/Plane_Proyect/MECÁNICA/Modelo 3D Avion/TREN DE ATERRIZAJE/eje inferior nose gear.SLDPRT

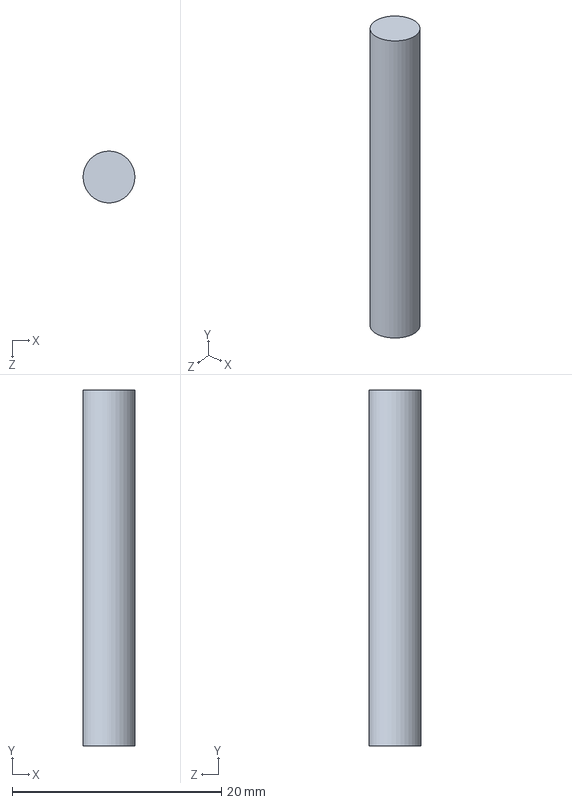
[picture p57: CAD file, 2026-04-15]
MECÁNICA/Modelo 3D Avion/TREN DE ATERRIZAJE/eje inferior nose gear.SLDPRT
4.95 x 34.0 x 4.95 mm
