XavierianAerospace/Plane_Proyect/Prueba thrust/15 cm Propeller.SLDPRT

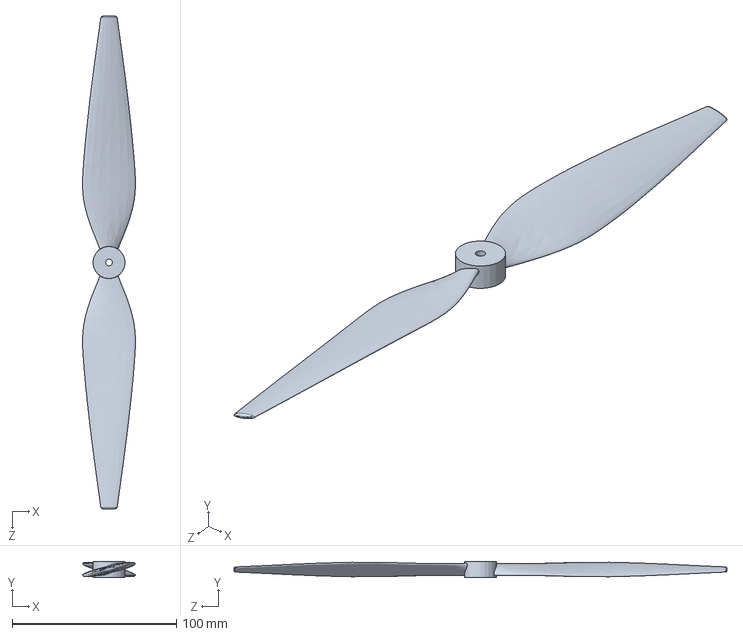
[picture p58: CAD file, 2026-05-09]
Prueba thrust/15 cm Propeller.SLDPRT
32.2 x 10.0 x 300.0 mm
