XavierianAerospace/Plane_Proyect/Simulacion_Matlab_SolidWorks/Vtol Stallion/MatLab_Simulaciones/cad/estructura_dxf/ALA_IZQ_FIJA.DXF

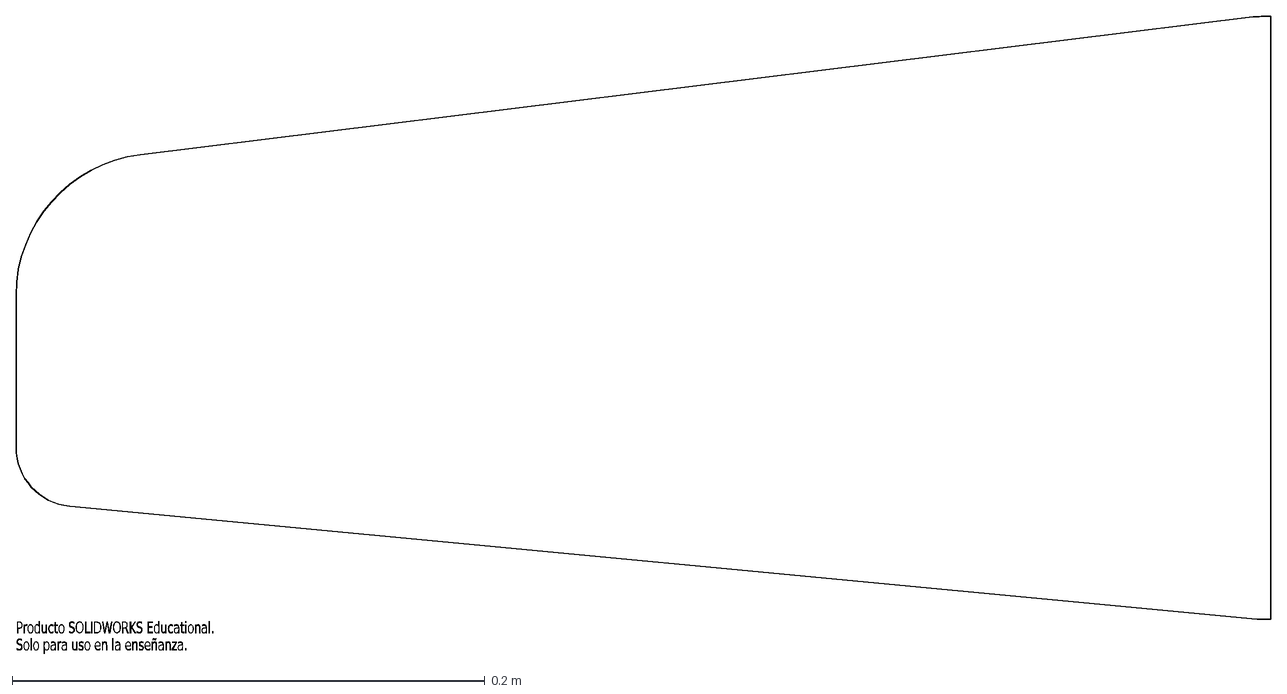
[picture p59: CAD file, 2026-08-14]
Simulacion_Matlab_SolidWorks/Vtol Stallion/MatLab_Simulaciones/cad/estructura_dxf/ALA_IZQ_FIJA.DXF
Producto SOLIDWORKS Educational.
Solo para uso en la enseñanza.
