XavierianAerospace/Plane_Proyect/Simulacion_Matlab_SolidWorks/Vtol Stallion/MatLab_Simulaciones_Actualizado/cad/componentes_dxf/SERVO_ALA_DER.DXF

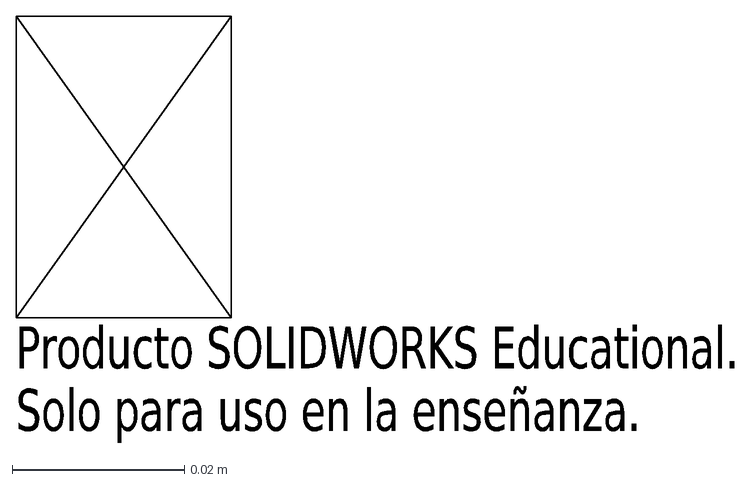
[picture p61: CAD file, 2026-08-14]
Simulacion_Matlab_SolidWorks/Vtol Stallion/MatLab_Simulaciones_Actualizado/cad/componentes_dxf/SERVO_ALA_DER.DXF
Producto SOLIDWORKS Educational.
Solo para uso en la enseñanza.
