XavierianAerospace/Plane_Proyect/MECÁNICA/Modelo 3D Avion/Bateria Avion/batería.SLDPRT

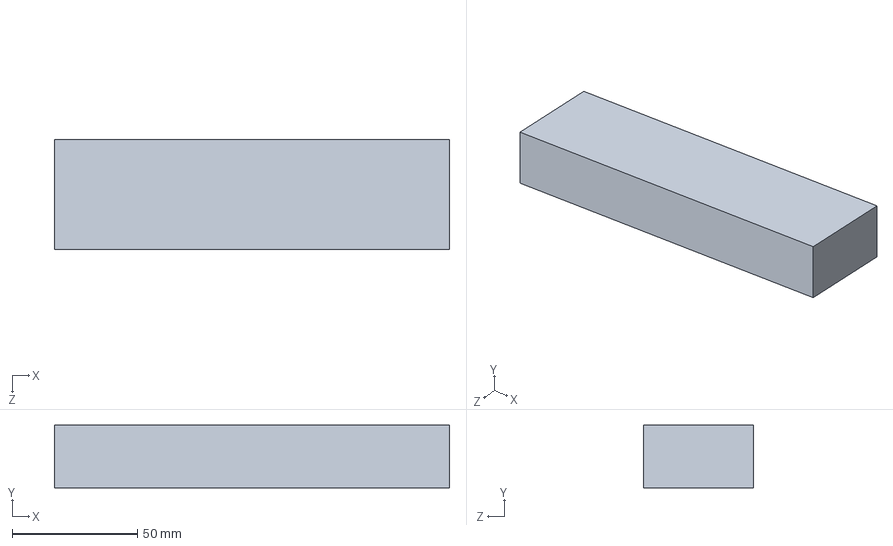
[picture p63: CAD file, 2026-04-06]
MECÁNICA/Modelo 3D Avion/Bateria Avion/batería.SLDPRT
158.0 x 25.0 x 44.0 mm
