XavierianAerospace/Plane_Proyect/MECÁNICA/Modelo 3D Avion/TREN DE ATERRIZAJE/eje superior nose gear.SLDPRT

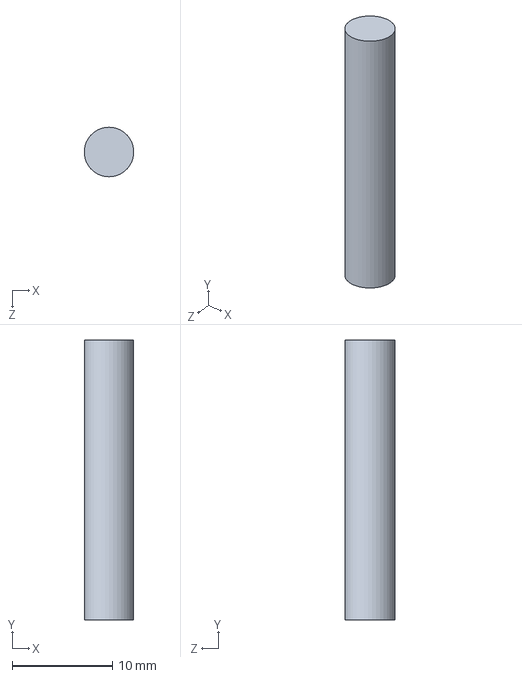
[picture p64: CAD file, 2026-04-15]
MECÁNICA/Modelo 3D Avion/TREN DE ATERRIZAJE/eje superior nose gear.SLDPRT
4.93 x 28.0 x 4.95 mm
