XavierianAerospace/Plane_Proyect/Simulacion_Matlab_SolidWorks/Vtol Stallion/MatLab_Simulaciones/cad/estructura_dxf/FUSELAJE_COLA.DXF

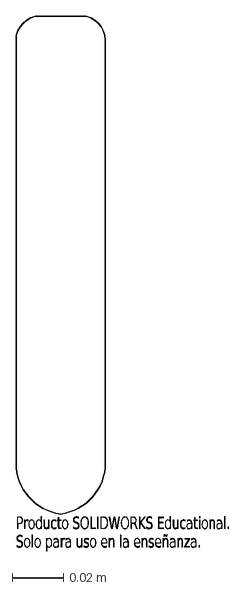
[picture p65: CAD file, 2026-08-14]
Simulacion_Matlab_SolidWorks/Vtol Stallion/MatLab_Simulaciones/cad/estructura_dxf/FUSELAJE_COLA.DXF
Producto SOLIDWORKS Educational.
Solo para uso en la enseñanza.
