XavierianAerospace/Plane_Proyect/Simulacion_Matlab_SolidWorks/Vtol Stallion/MatLab_Simulaciones_Actualizado/cad/componentes_dxf/SERVO_MOTOR_DER.DXF

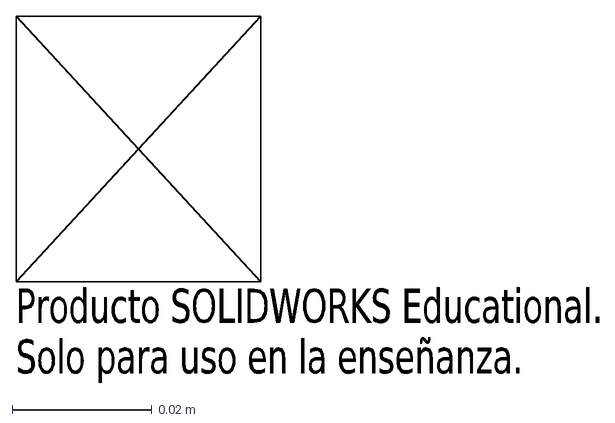
[picture p66: CAD file, 2026-08-14]
Simulacion_Matlab_SolidWorks/Vtol Stallion/MatLab_Simulaciones_Actualizado/cad/componentes_dxf/SERVO_MOTOR_DER.DXF
Producto SOLIDWORKS Educational.
Solo para uso en la enseñanza.
