XavierianAerospace/Plane_Proyect/MECÁNICA/Modelo 3D Avion/Estrucutura General/placa de madera.SLDPRT

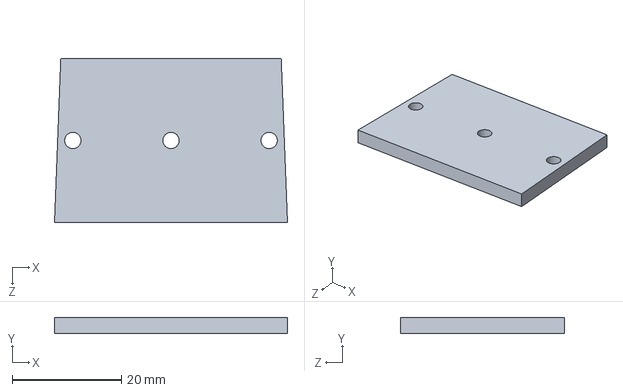
[picture p67: CAD file, 2026-05-02]
MECÁNICA/Modelo 3D Avion/Estrucutura General/placa de madera.SLDPRT
42.7 x 3.00 x 30.0 mm
