XavierianAerospace/Plane_Proyect/Prueba thrust/Soporte.SLDPRT

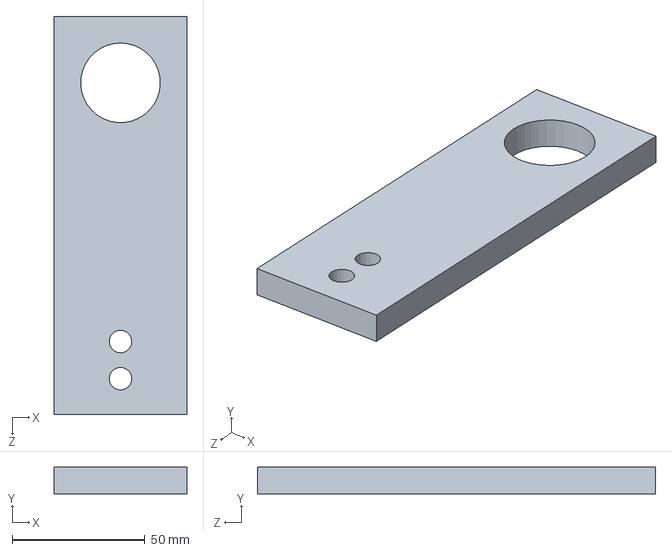
[picture p68: CAD file, 2026-05-09]
Prueba thrust/Soporte.SLDPRT
50.0 x 10.0 x 150.0 mm
