XavierianAerospace/Plane_Proyect/Simulacion_Matlab_SolidWorks/Vtol Stallion/MatLab_Simulaciones/cad/componentes_dxf/MOTOR_TRASERO.DXF

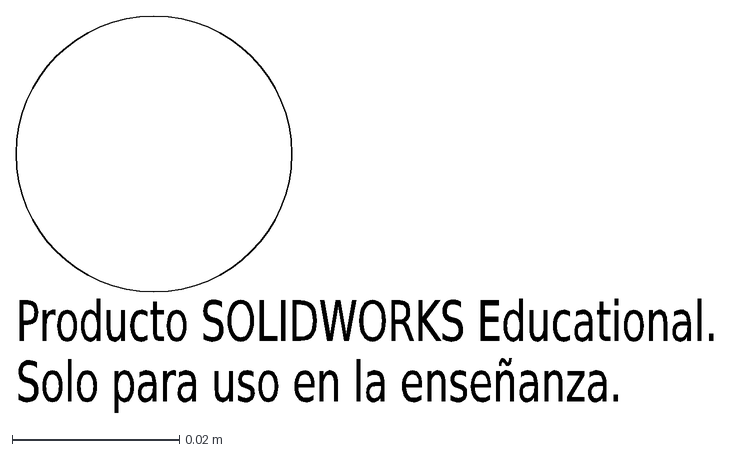
[picture p69: CAD file, 2026-08-14]
Simulacion_Matlab_SolidWorks/Vtol Stallion/MatLab_Simulaciones/cad/componentes_dxf/MOTOR_TRASERO.DXF
Producto SOLIDWORKS Educational.
Solo para uso en la enseñanza.
