XavierianAerospace/Plane_Proyect/MECÁNICA/Modelo 3D Avion/Estrucutura General/Cola.SLDPRT

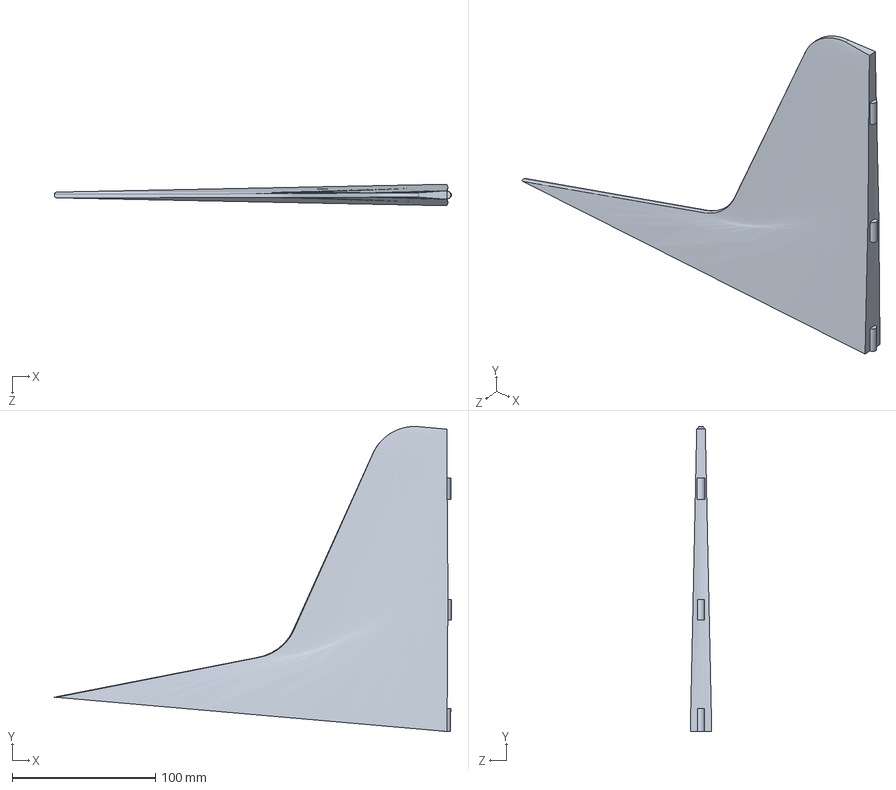
[picture p70: CAD file, 2026-05-02]
MECÁNICA/Modelo 3D Avion/Estrucutura General/Cola.SLDPRT
277.1 x 212.9 x 15.0 mm
