XavierianAerospace/Plane_Proyect/Prueba thrust/Eje.SLDPRT

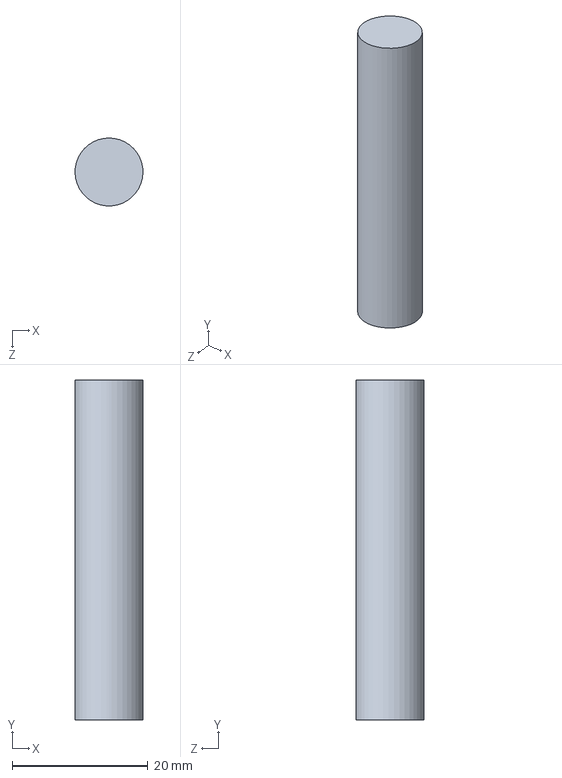
[picture p71: CAD file, 2026-05-09]
Prueba thrust/Eje.SLDPRT
9.99 x 50.0 x 10.0 mm
