XavierianAerospace/Plane_Proyect/Simulacion_Matlab_SolidWorks/Vtol Stallion/MatLab_Simulaciones/cad/Piezas3D/Diseño Avion/Archvivos_Alas/Ensamblaje Alas y Flaps/Ala_Vtol_Segunda_Etapa.SLDPRT

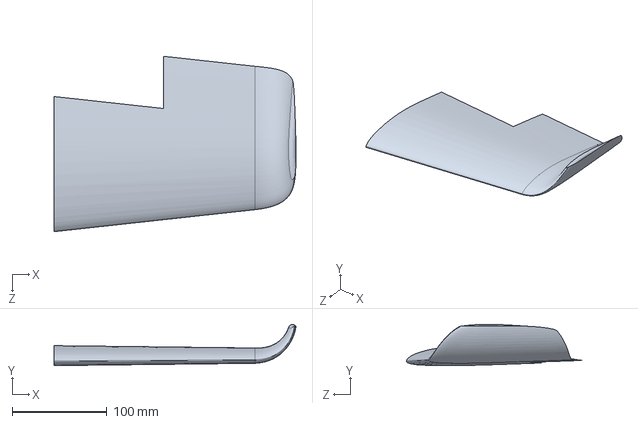
[picture p72: CAD file, 2026-08-23]
Simulacion_Matlab_SolidWorks/Vtol Stallion/MatLab_Simulaciones/cad/Piezas3D/Diseño Avion/Archvivos_Alas/Ensamblaje Alas y Flaps/Ala_Vtol_Segunda_Etapa.SLDPRT
255.9 x 43.7 x 185.5 mm
