XavierianAerospace/Plane_Proyect/MECÁNICA/Modelo 3D Avion/Estrucutura General/Ala Inferior Avion.SLDPRT

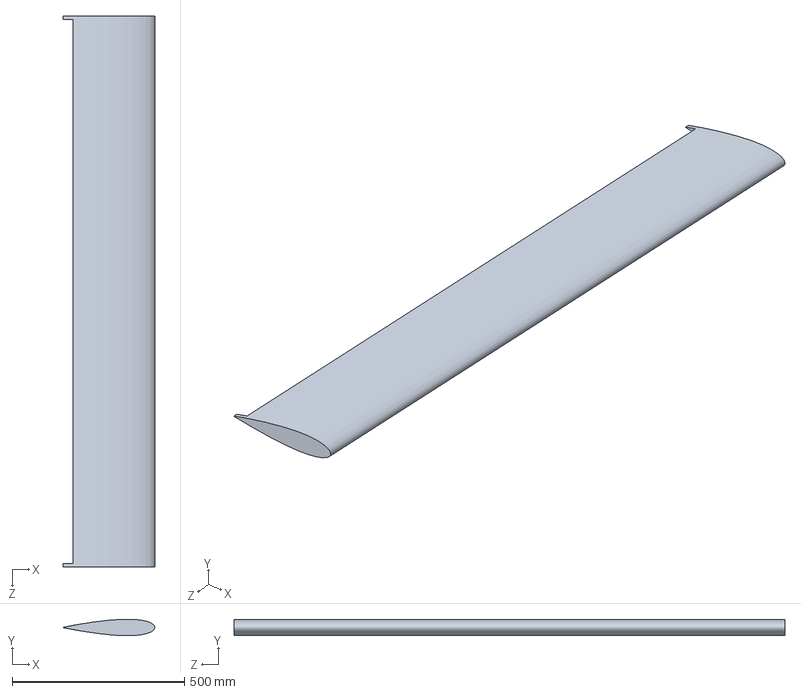
[picture p75: CAD file, 2026-05-02]
MECÁNICA/Modelo 3D Avion/Estrucutura General/Ala Inferior Avion.SLDPRT
266.0 x 47.5 x 1600.0 mm
