XavierianAerospace/Plane_Proyect/Prueba thrust/Soporte motor.SLDPRT

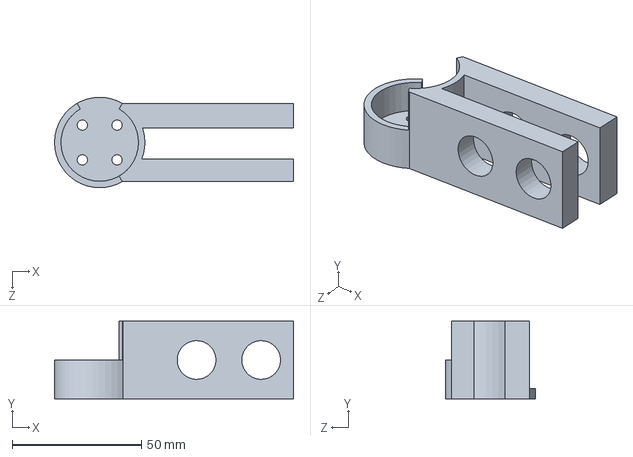
[picture p76: CAD file, 2026-05-09]
Prueba thrust/Soporte motor.SLDPRT
92.5 x 30.0 x 35.0 mm
