XavierianAerospace/Plane_Proyect/Simulacion_Matlab_SolidWorks/Vtol Stallion/MatLab_Simulaciones/cad/Piezas3D/Diseño Avion/Archvivos_Alas/Ensamblaje Soporte Motor/Soporte Motor.SLDPRT

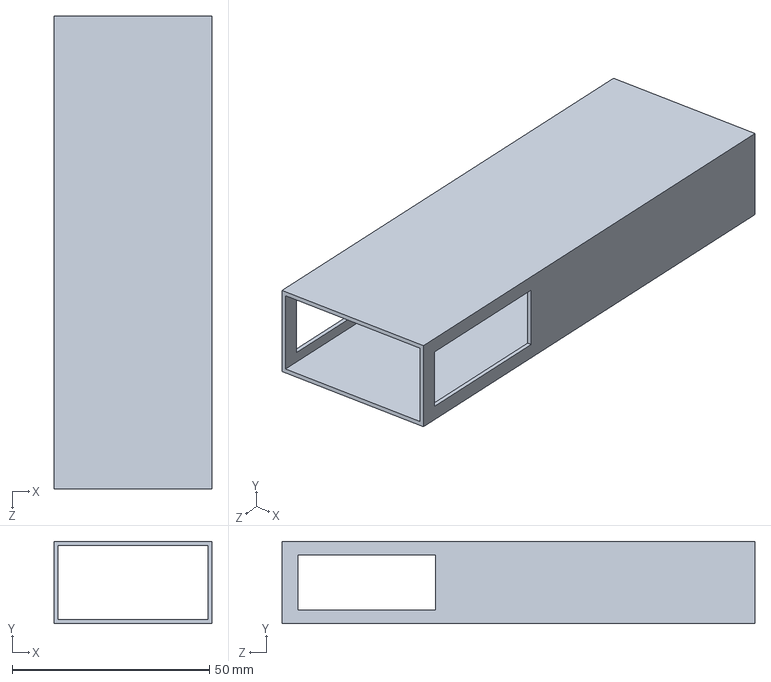
[picture p77: CAD file, 2026-08-14]
Simulacion_Matlab_SolidWorks/Vtol Stallion/MatLab_Simulaciones/cad/Piezas3D/Diseño Avion/Archvivos_Alas/Ensamblaje Soporte Motor/Soporte Motor.SLDPRT
40.0 x 20.9 x 120.0 mm
