XavierianAerospace/Plane_Proyect/MECÁNICA/Modelo 3D Avion/Estrucutura General/Principal Cuerpo Avion.SLDPRT

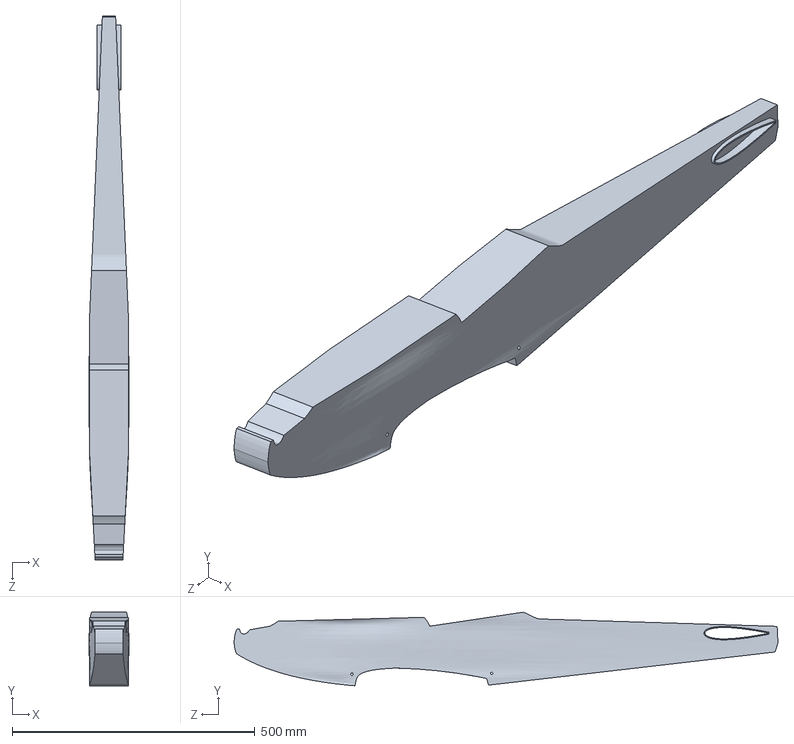
[picture p78: CAD file, 2026-05-02]
MECÁNICA/Modelo 3D Avion/Estrucutura General/Principal Cuerpo Avion.SLDPRT
83.1 x 151.7 x 1120.0 mm
