XavierianAerospace/Plane_Proyect/Prueba thrust/Bearing_Ball_6200_2RS.SLDPRT

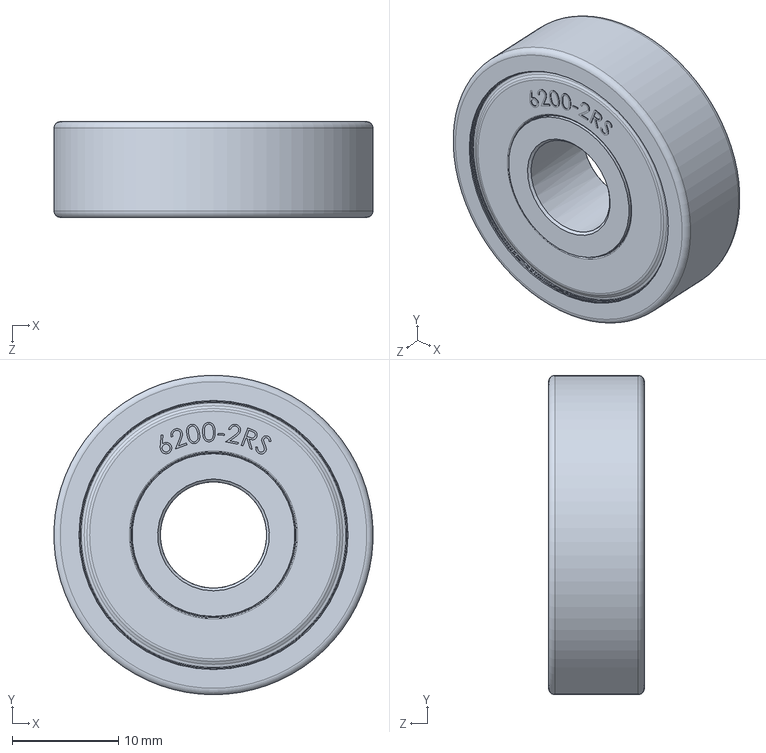
[picture p79: CAD file, 2026-05-09]
Prueba thrust/Bearing_Ball_6200_2RS.SLDPRT
30.0 x 30.0 x 9.00 mm
