XavierianAerospace/Plane_Proyect/Simulacion_Matlab_SolidWorks/Vtol Stallion/MatLab_Simulaciones/cad/componentes_dxf/BATERIA.DXF

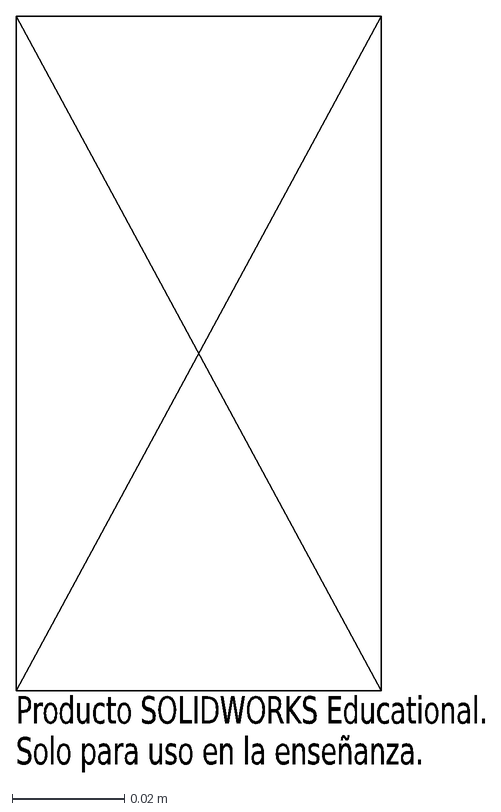
[picture p80: CAD file, 2026-08-14]
Simulacion_Matlab_SolidWorks/Vtol Stallion/MatLab_Simulaciones/cad/componentes_dxf/BATERIA.DXF
Producto SOLIDWORKS Educational.
Solo para uso en la enseñanza.
