XavierianAerospace/Plane_Proyect/Simulacion_Matlab_SolidWorks/Vtol Stallion/MatLab_Simulaciones/cad/Piezas3D/Diseño Avion/Archvivos_Alas/Ensamblaje Soporte Motor/soporte helice.SLDPRT

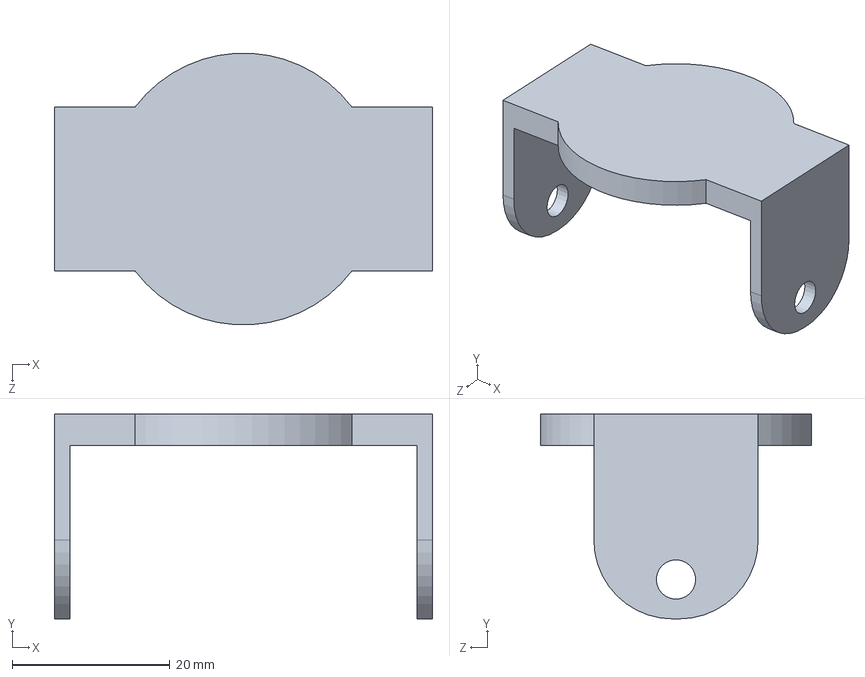
[picture p81: CAD file, 2026-08-14]
Simulacion_Matlab_SolidWorks/Vtol Stallion/MatLab_Simulaciones/cad/Piezas3D/Diseño Avion/Archvivos_Alas/Ensamblaje Soporte Motor/soporte helice.SLDPRT
48.0 x 26.0 x 34.5 mm
