XavierianAerospace/Plane_Proyect/MECÁNICA/Modelo 3D Avion/Estrucutura General/Ala Traseras Avion.SLDPRT

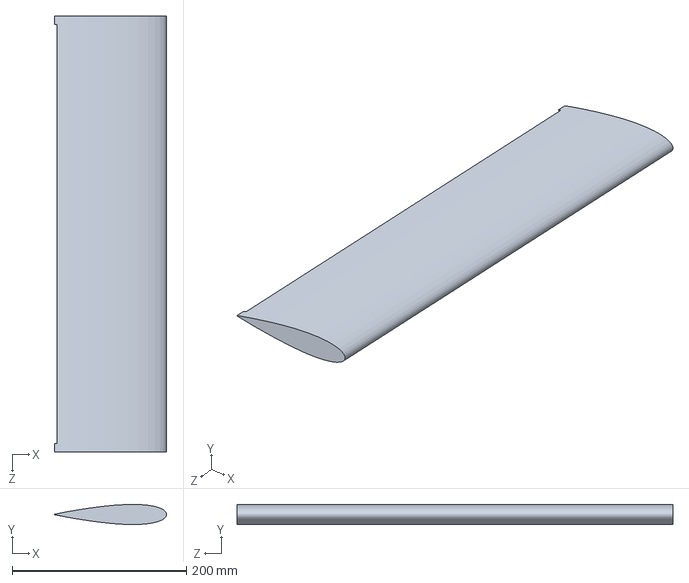
[picture p83: CAD file, 2026-05-02]
MECÁNICA/Modelo 3D Avion/Estrucutura General/Ala Traseras Avion.SLDPRT
128.8 x 23.1 x 500.0 mm
