XavierianAerospace/Plane_Proyect/Prueba thrust/Celda de carga.SLDPRT

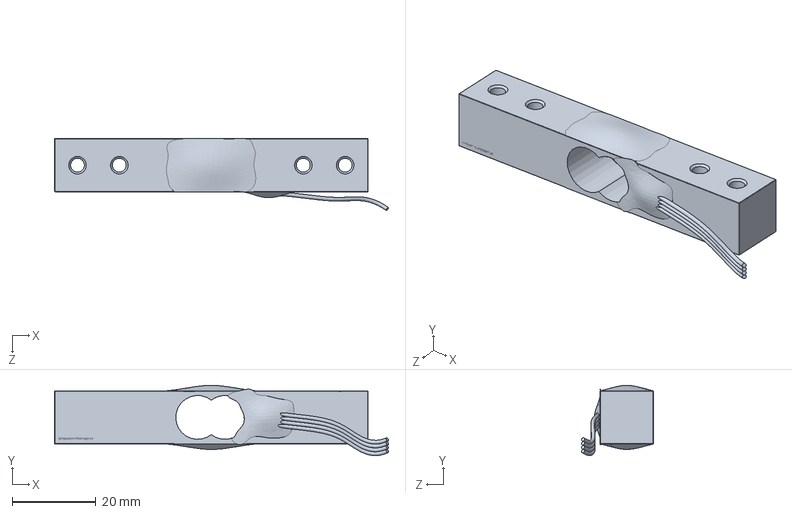
[picture p84: CAD file, 2026-05-09]
Prueba thrust/Celda de carga.SLDPRT
79.9 x 16.8 x 17.2 mm
