XavierianAerospace/Plane_Proyect/Simulacion_Matlab_SolidWorks/Vtol Stallion/MatLab_Simulaciones/cad/Piezas3D/Diseño Avion/Archvivos_Alas/Ensamblaje Alas y Flaps/Flap_Vtol_Segunda_Etapa.SLDPRT

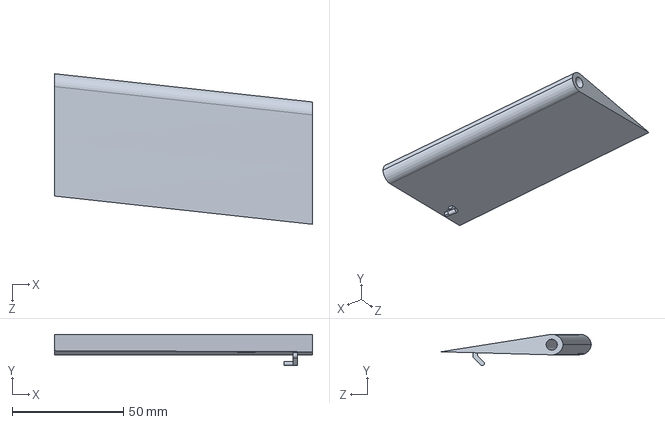
[picture p85: CAD file, 2026-08-23]
Simulacion_Matlab_SolidWorks/Vtol Stallion/MatLab_Simulaciones/cad/Piezas3D/Diseño Avion/Archvivos_Alas/Ensamblaje Alas y Flaps/Flap_Vtol_Segunda_Etapa.SLDPRT
116.0 x 14.1 x 67.7 mm
