XavierianAerospace/Plane_Proyect/MECÁNICA/Modelo 3D Avion/Estrucutura General/Ala Avion.SLDPRT

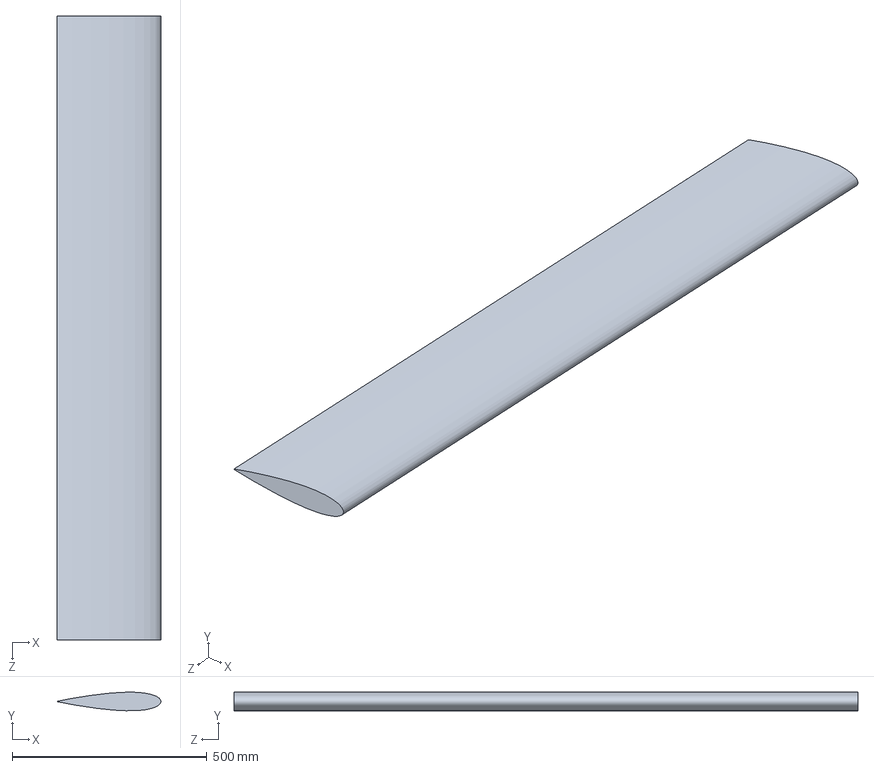
[picture p87: CAD file, 2026-04-15]
MECÁNICA/Modelo 3D Avion/Estrucutura General/Ala Avion.SLDPRT
266.0 x 47.5 x 1600.0 mm
