XavierianAerospace/Plane_Proyect/Prueba thrust/Brazo.SLDPRT

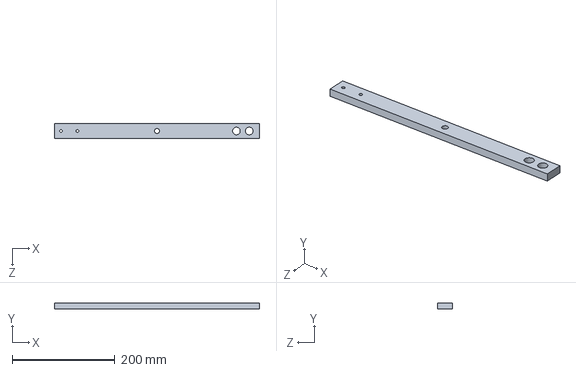
[picture p88: CAD file, 2026-05-09]
Prueba thrust/Brazo.SLDPRT
400.0 x 12.0 x 30.0 mm
