XavierianAerospace/Plane_Proyect/Simulacion_Matlab_SolidWorks/Vtol Stallion/MatLab_Simulaciones/cad/Piezas3D/Diseño Avion/Archvivos_Alas/Ensamblaje Alas y Flaps/eje menor.SLDPRT

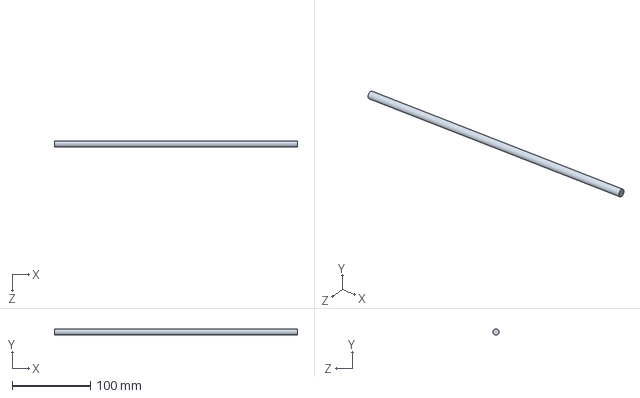
[picture p89: CAD file, 2026-08-23]
Simulacion_Matlab_SolidWorks/Vtol Stallion/MatLab_Simulaciones/cad/Piezas3D/Diseño Avion/Archvivos_Alas/Ensamblaje Alas y Flaps/eje menor.SLDPRT
310.0 x 7.98 x 8.00 mm
