XavierianAerospace/Plane_Proyect/MECÁNICA/Modelo 3D Avion/Estrucutura General/SOPORTES_ALAS_AVIÓN_2024.SLDPRT

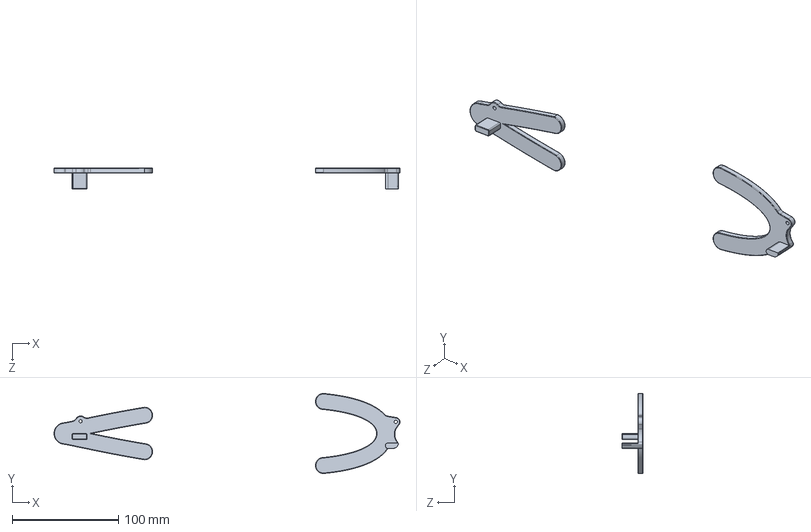
[picture p90: CAD file, 2026-04-15]
MECÁNICA/Modelo 3D Avion/Estrucutura General/SOPORTES_ALAS_AVIÓN_2024.SLDPRT
325.6 x 75.3 x 20.0 mm
