XavierianAerospace/Plane_Proyect/Simulacion_Matlab_SolidWorks/Vtol Stallion/MatLab_Simulaciones/cad/Piezas3D/Diseño Avion/Archvivos_Alas/Ensamblaje Alas y Flaps/Flap_Vtol_Primera_Etapa.SLDPRT

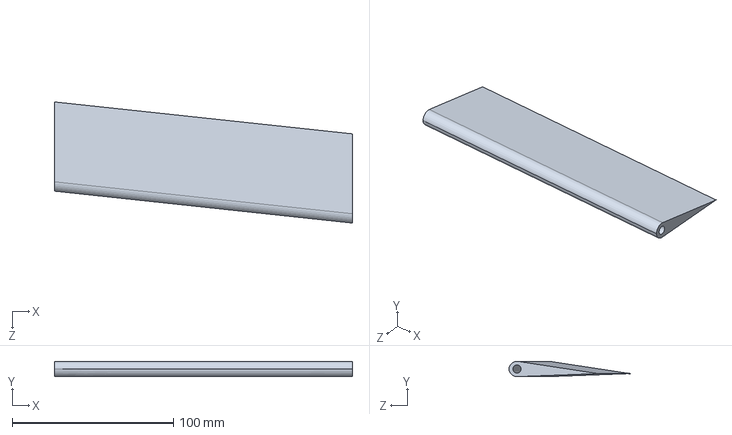
[picture p91: CAD file, 2026-08-23]
Simulacion_Matlab_SolidWorks/Vtol Stallion/MatLab_Simulaciones/cad/Piezas3D/Diseño Avion/Archvivos_Alas/Ensamblaje Alas y Flaps/Flap_Vtol_Primera_Etapa.SLDPRT
184.6 x 9.44 x 75.0 mm
