XavierianAerospace/Plane_Proyect/MECÁNICA/Modelo 3D Avion/Estrucutura General/BACK FLAPS SUPPORT 2024.SLDPRT

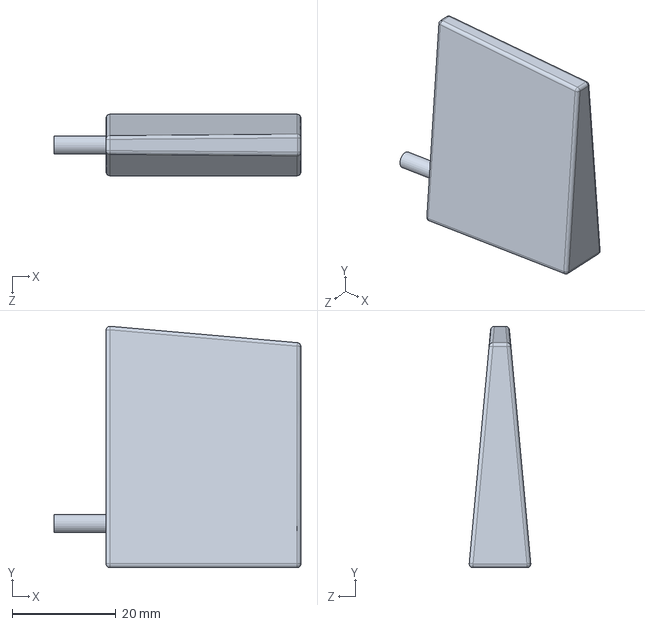
[picture p92: CAD file, 2026-04-15]
MECÁNICA/Modelo 3D Avion/Estrucutura General/BACK FLAPS SUPPORT 2024.SLDPRT
47.5 x 46.4 x 11.9 mm
