XavierianAerospace/Plane_Proyect/MECÁNICA/Modelo 3D Avion/Estrucutura General/LEADING EDGE DOUBLER 2024.SLDPRT

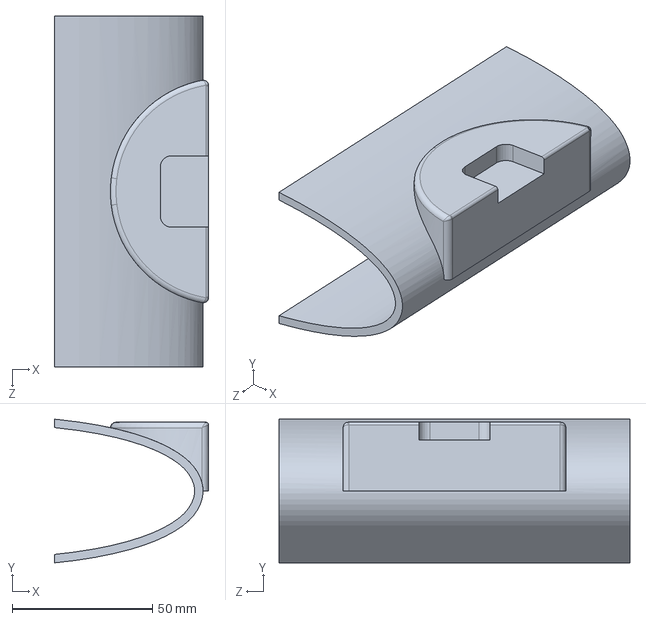
[picture p93: CAD file, 2026-04-15]
MECÁNICA/Modelo 3D Avion/Estrucutura General/LEADING EDGE DOUBLER 2024.SLDPRT
55.0 x 51.2 x 125.0 mm
