XavierianAerospace/Plane_Proyect/MECÁNICA/Modelo 3D Avion/Estrucutura General/AIRFOIL TIP 2024.SLDPRT

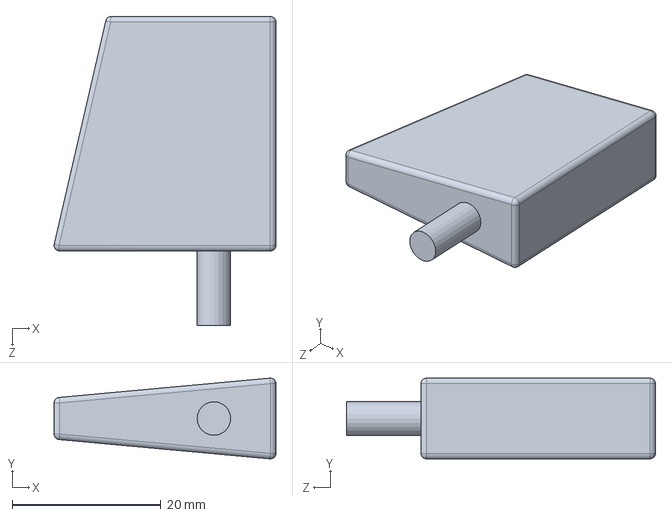
[picture p95: CAD file, 2026-04-15]
MECÁNICA/Modelo 3D Avion/Estrucutura General/AIRFOIL TIP 2024.SLDPRT
29.8 x 10.8 x 41.5 mm
