XavierianAerospace/Plane_Proyect/Electronica/Corona_DS939MG_filDroit.SLDASM

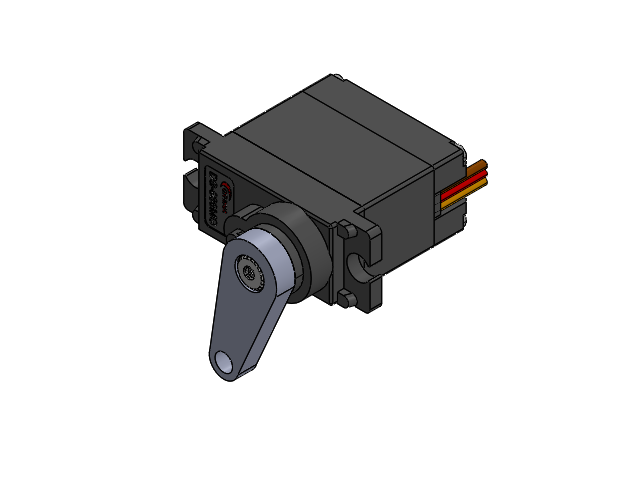
[picture p97: CAD file, 2026-09-22]
Electronica/Corona_DS939MG_filDroit.SLDASM
Corps.step
M1.2-Screw001.step
M1.2-Screw002.step
M1.2-Screw003.step
M1.2-Screw004.step
Axe.step
FilRougeDroit.step
FilMarronDroit.step
FilOraqngeDroit.step
Etiquette2.step
