XavierianAerospace/Plane_Proyect/Simulacion_Matlab_SolidWorks/Vtol Stallion/MatLab_Simulaciones/cad/Piezas3D/Diseño Avion/Archivos_Avion_Vtol_Completo/Ensamblaje_Completo_Vtol.SLDASM

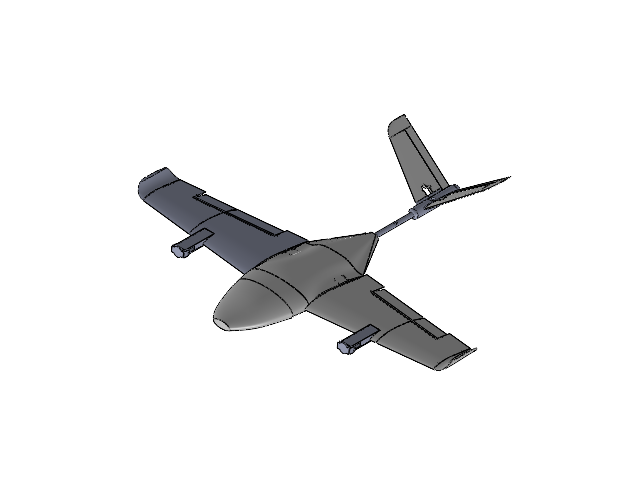
[picture p98: CAD file, 2026-09-22]
Simulacion_Matlab_SolidWorks/Vtol Stallion/MatLab_Simulaciones/cad/Piezas3D/Diseño Avion/Archivos_Avion_Vtol_Completo/Ensamblaje_Completo_Vtol.SLDASM
Ala_Vtol_Primera_Etapa
Ala_Vtol_Segunda_Etapa
Flap_Vtol_Primera_Etapa
Soporte Motor
soporte helice
Eje_flaps
Flap_Vtol_Segunda_Etapa
eje mayor
eje menor
Ala_Vtol_Primera_Etapa1
Ala_Vtol_Segunda_Etapa1
Flap_Vtol_Primera_Etapa1
Soporte Motor1
soporte helice1
Eje_flaps1
Flap_Vtol_Segunda_Etapa1
eje menor1
Fuselaje_Vtol_Central
Fuselaje_Vtol_Frontal
Fuselaje_Vtol_Trasero
cuerpo de cola
cola vtol x 2
flap_cola x 2
cilindro_cola
