XavierianAerospace/Plane_Proyect/Simulacion_Matlab_SolidWorks/Vtol Stallion/MatLab_Simulaciones/cad/Piezas3D/Diseño Avion/Archvivos_Alas/Ensamblaje Alas y Flaps/Ensamblaje_Alas_Vtol.SLDASM

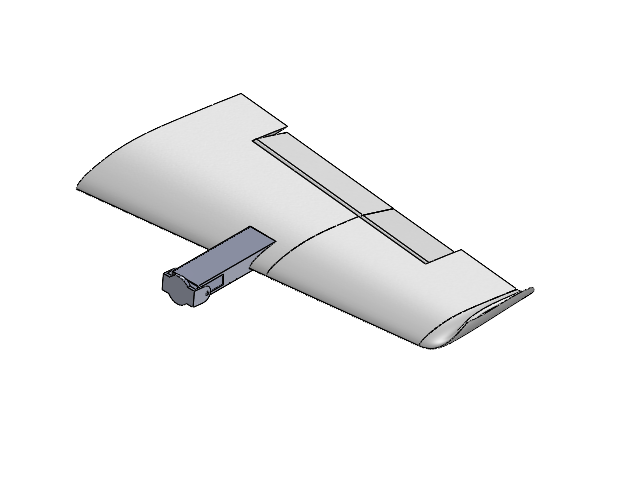
[picture p100: CAD file, 2026-09-22]
Simulacion_Matlab_SolidWorks/Vtol Stallion/MatLab_Simulaciones/cad/Piezas3D/Diseño Avion/Archvivos_Alas/Ensamblaje Alas y Flaps/Ensamblaje_Alas_Vtol.SLDASM
Ala_Vtol_Primera_Etapa
Ala_Vtol_Segunda_Etapa
Flap_Vtol_Primera_Etapa
Soporte Motor
soporte helice
Eje_flaps
Flap_Vtol_Segunda_Etapa
