XavierianAerospace/Plane_Proyect/Simulacion_Matlab_SolidWorks/Vtol Stallion/MatLab_Simulaciones/cad/Piezas3D/Diseño Avion/Archvivos_Alas/Ensamblaje Soporte Motor/Ensamblaje_Soporte_Motor_Vtol.SLDASM

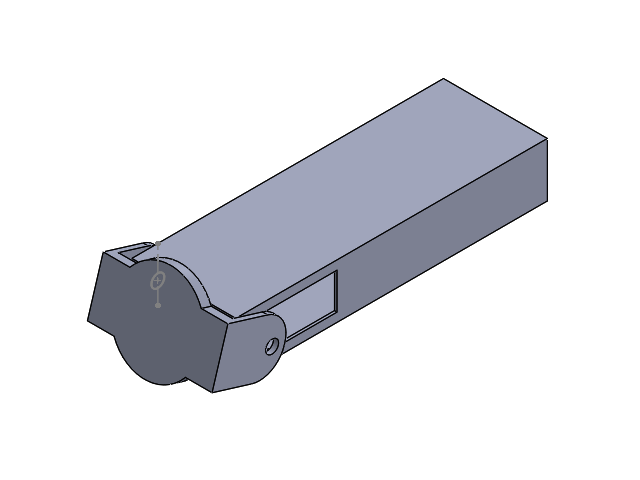
[picture p101: CAD file, 2026-08-23]
Simulacion_Matlab_SolidWorks/Vtol Stallion/MatLab_Simulaciones/cad/Piezas3D/Diseño Avion/Archvivos_Alas/Ensamblaje Soporte Motor/Ensamblaje_Soporte_Motor_Vtol.SLDASM
Soporte Motor
soporte helice
