XavierianAerospace/Plane_Proyect/Simulacion_Matlab_SolidWorks/Vtol Stallion/MatLab_Simulaciones/cad/Piezas3D/Diseño Avion/Archvivos_Alas/Ensamblaje Soporte Motor/ensamble soporte de motor.SLDASM

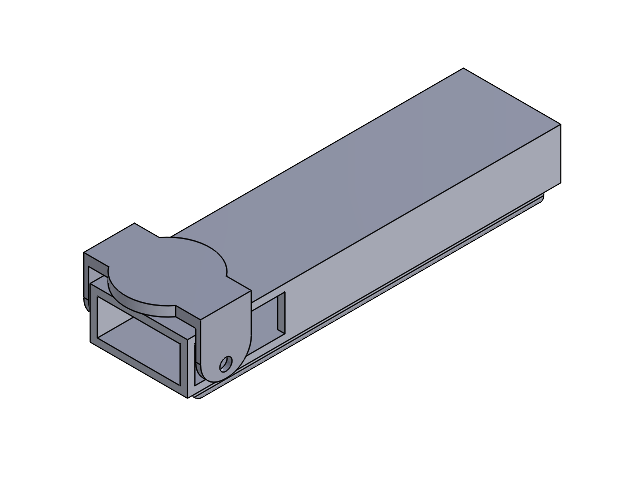
[picture p102: CAD file, 2026-08-17]
Simulacion_Matlab_SolidWorks/Vtol Stallion/MatLab_Simulaciones/cad/Piezas3D/Diseño Avion/Archvivos_Alas/Ensamblaje Soporte Motor/ensamble soporte de motor.SLDASM
soporte motor
soporte helice
