XavierianAerospace/Plane_Proyect/(list of files, cad)

Other CAD files:
Electronica/Corona_DS939MG_filDroit1.SLDASM
Simulacion_Matlab_SolidWorks/Vtol Stallion/MatLab_Simulaciones/cad/Piezas3D/Diseño Avion/Archvivos_Alas/Ensamblaje Alas y Flaps/Ensamblaje_Alas_Vtol_Derecho.SLDASM
Simulacion_Matlab_SolidWorks/Vtol Stallion/MatLab_Simulaciones/cad/Piezas3D/Diseño Avion/Archvivos_Alas/Ensamblaje Soporte Motor/Ensamblaje_Soporte_Motor_Vtol1.SLDASM
Electronica/MirrorCorona_DS939MG_filDroit.SLDASM
Simulacion_Matlab_SolidWorks/Vtol Stallion/MatLab_Simulaciones/cad/Piezas3D/Diseño Avion/Archvivos_Alas/Ensamblaje Soporte Motor/MirrorEnsamblaje_Soporte_Motor_Vtol.SLDASM
MECÁNICA/Modelo 3D Avion/Estrucutura General/Ensamblaje Avion Completo.SLDASM
Simulacion_Matlab_SolidWorks/Vtol Stallion/MatLab_Simulaciones/cad/general_dxf/VTOL_GENERAL.DXF
Simulacion_Matlab_SolidWorks/Vtol Stallion/MatLab_Simulaciones/cad/Piezas3D/Diseño Avion/Archivos_servos/cabeza_servo1.SLDPRT
Simulacion_Matlab_SolidWorks/Vtol Stallion/MatLab_Simulaciones/cad/Piezas3D/Diseño Avion/Archvivos_Alas/Ensamblaje Soporte Motor/soporte helice1.SLDPRT
Simulacion_Matlab_SolidWorks/Vtol Stallion/MatLab_Simulaciones/cad/Piezas3D/Esquema_General.SLDPRT
Simulacion_Matlab_SolidWorks/Vtol Stallion/MatLab_Simulaciones_Actualizado/cad/general_dxf/VTOL_GENERAL.DXF
Simulacion_Matlab_SolidWorks/Vtol Stallion/MatLab_Simulaciones_Actualizado/cad/Piezas3D/Esquema_General.SLDPRT
Simulacion_Matlab_SolidWorks/Vtol Stallion/MatLab_Simulaciones/cad/Piezas3D/Diseño Avion/Archivos_servos/Mirrorcabeza_servo.SLDPRT
Simulacion_Matlab_SolidWorks/Vtol Stallion/MatLab_Simulaciones/cad/Piezas3D/Diseño Avion/Archvivos_Alas/Ensamblaje Soporte Motor/Mirrorsoporte helice.SLDPRT
MECÁNICA/Modelo 3D Avion/Estrucutura General/tuerca.SLDPRT
Simulacion_Matlab_SolidWorks/Vtol Stallion/MatLab_Simulaciones/cad/Piezas3D/Diseño Avion/Archvivos_Alas/Ensamblaje Alas y Flaps/Ala_Vtol_Primera_Etapa1.SLDPRT
Simulacion_Matlab_SolidWorks/Vtol Stallion/MatLab_Simulaciones/cad/Piezas3D/Diseño Avion/Archvivos_Alas/Ensamblaje Soporte Motor/Soporte Motor1.SLDPRT
Electronica/SpeedyBee 2807 1050kV Motor/Bearings.SLDPRT
Prueba thrust/Bracket 40(imprimir).SLDPRT
Simulacion_Matlab_SolidWorks/Vtol Stallion/MatLab_Simulaciones/cad/Piezas3D/Diseño Avion/Archvivos_Alas/Ensamblaje Alas y Flaps/Ala_Vtol_Segunda_Etapa1.SLDPRT
Simulacion_Matlab_SolidWorks/Vtol Stallion/MatLab_Simulaciones/cad/Piezas3D/Diseño Avion/Archvivos_Alas/Ensamblaje Alas y Flaps/Eje_flaps1.SLDPRT
Simulacion_Matlab_SolidWorks/Vtol Stallion/MatLab_Simulaciones/cad/Piezas3D/Diseño Avion/Archvivos_Alas/Ensamblaje Soporte Motor/MirrorSoporte Motor.SLDPRT
Simulacion_Matlab_SolidWorks/Vtol Stallion/MatLab_Simulaciones/cad/Piezas3D/Diseño Avion/Archvivos_Alas/Ensamblaje Alas y Flaps/Flap_Vtol_Primera_Etapa1.SLDPRT
Simulacion_Matlab_SolidWorks/Vtol Stallion/MatLab_Simulaciones/cad/Piezas3D/Diseño Avion/Archvivos_Alas/Ensamblaje Alas y Flaps/Flap_Vtol_Segunda_Etapa1.SLDPRT
Simulacion_Matlab_SolidWorks/Vtol Stallion/MatLab_Simulaciones/cad/Piezas3D/Diseño Avion/Archvivos_Alas/Ensamblaje Alas y Flaps/eje menor1.SLDPRT
Electronica/SpeedyBee 2807 1050kV Motor/Bottom Hex Screw.SLDPRT
Prueba thrust/Bracket 40(imprimir).STL
Prueba thrust/Plugs_soporte_motor.STL
Prueba thrust/Soporte motor.STL
Prueba thrust/Soporte.DXF
Simulacion_Matlab_SolidWorks/Vtol Stallion/MatLab_Simulaciones/cad/Piezas3D/Diseño Avion/Archivos_Avion_Vtol_Completo/Planos_Avion.SLDDRW
Simulacion_Matlab_SolidWorks/Vtol Stallion/MatLab_Simulaciones/cad/Piezas3D/Diseño Avion/Archivos_SnapFit/gancho.STL
Simulacion_Matlab_SolidWorks/Vtol Stallion/MatLab_Simulaciones/cad/Piezas3D/Diseño Avion/Archivos_SnapFit/hembra.STL
