XavierianAerospace/Plane_Proyect/Simulacion_Matlab_SolidWorks/Vtol Stallion/MatLab_Simulaciones/resultados/figuras/07_VTOL_DXF_Masa_por_tipo.pdf

Masa por tipo

ala
superficie
c

ontrol
boom
cola

fuselaje
fuselaje
c

ola
soportem

otor
bateria
electronica

motor
servo

M

a

s

a [g]

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
