XavierianAerospace/Plane_Proyect/Simulacion_Matlab_SolidWorks/Vtol Stallion/MatLab_Simulaciones/resultados/figuras/06_VTOL_DXF_Masa_por_categoria.pdf

Masa por categoria

estructura

componente

M

a

s

a [g]

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
