XavierianAerospace/Plane_Proyect/Simulacion_Matlab_SolidWorks/Vtol Stallion/MatLab_Simulaciones/resultados/figuras/02_VTOL_DXF_Zonas_estructurales_sobre_silueta_DXF.png

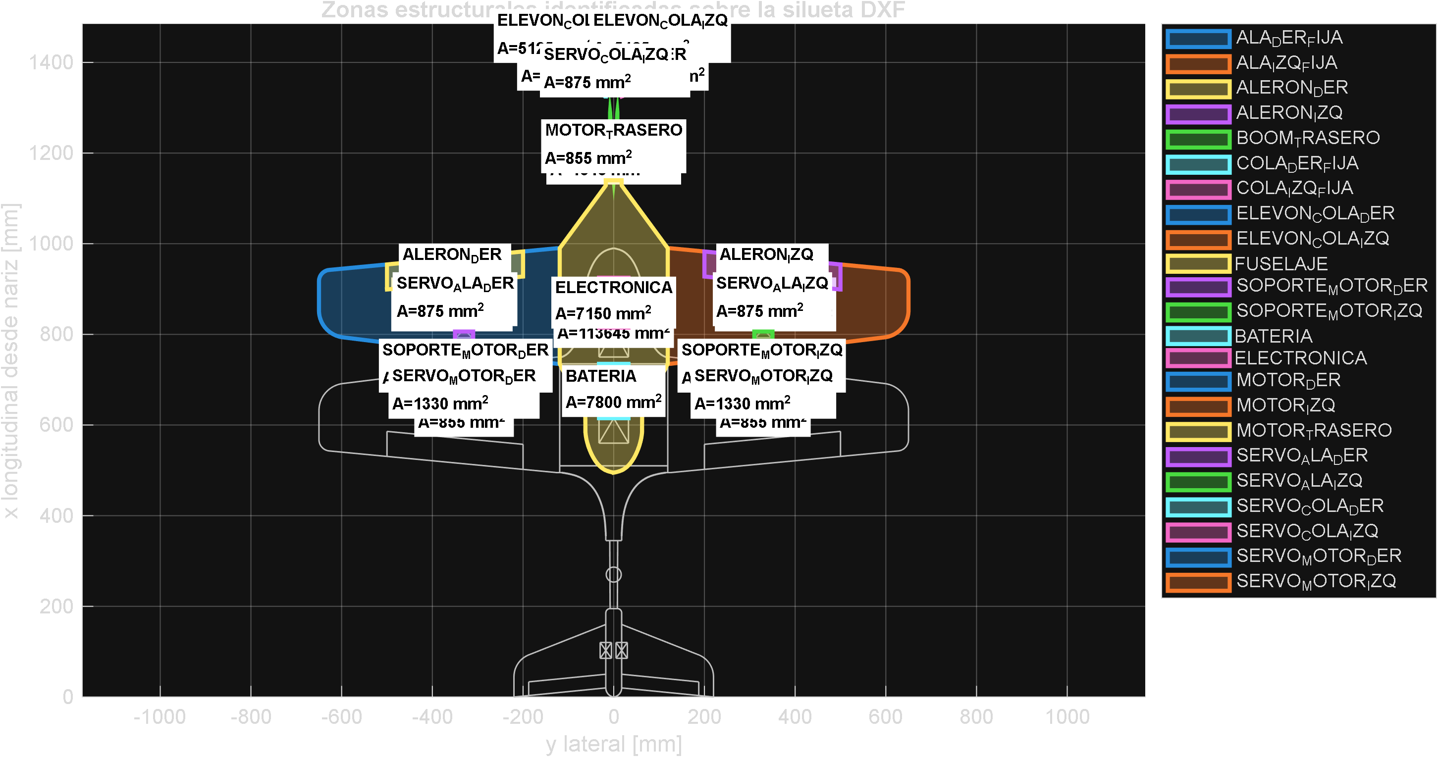
Simulacion_Matlab_SolidWorks/Vtol Stallion/MatLab_Simulaciones/resultados/figuras/02_VTOL_DXF_Zonas_estructurales_sobre_silueta_DXF.png
