XavierianAerospace/Plane_Proyect/Simulacion_Matlab_SolidWorks/Vtol Stallion/MatLab_Simulaciones/resultados/figuras/06_VTOL_DXF_Masa_por_categoria.png

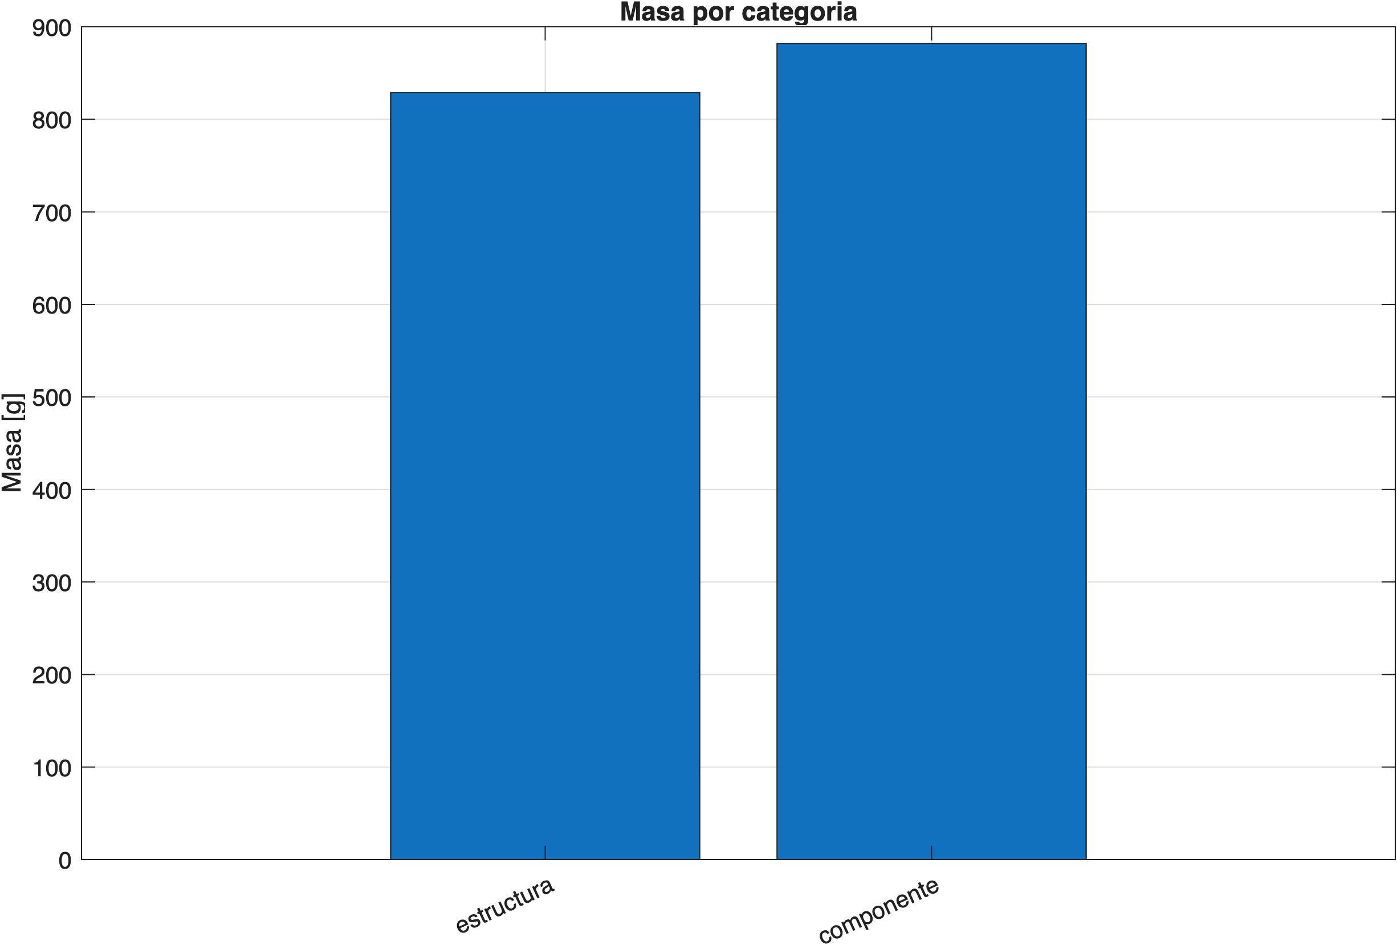
Simulacion_Matlab_SolidWorks/Vtol Stallion/MatLab_Simulaciones/resultados/figuras/06_VTOL_DXF_Masa_por_categoria.png
