XavierianAerospace/Plane_Proyect/Simulacion_Matlab_SolidWorks/Vtol Stallion/MatLab_Simulaciones_Actualizado/resultados/figuras/04_VTOL_DXF_Distribucion_de_masa_y_CG_vista_superior.png

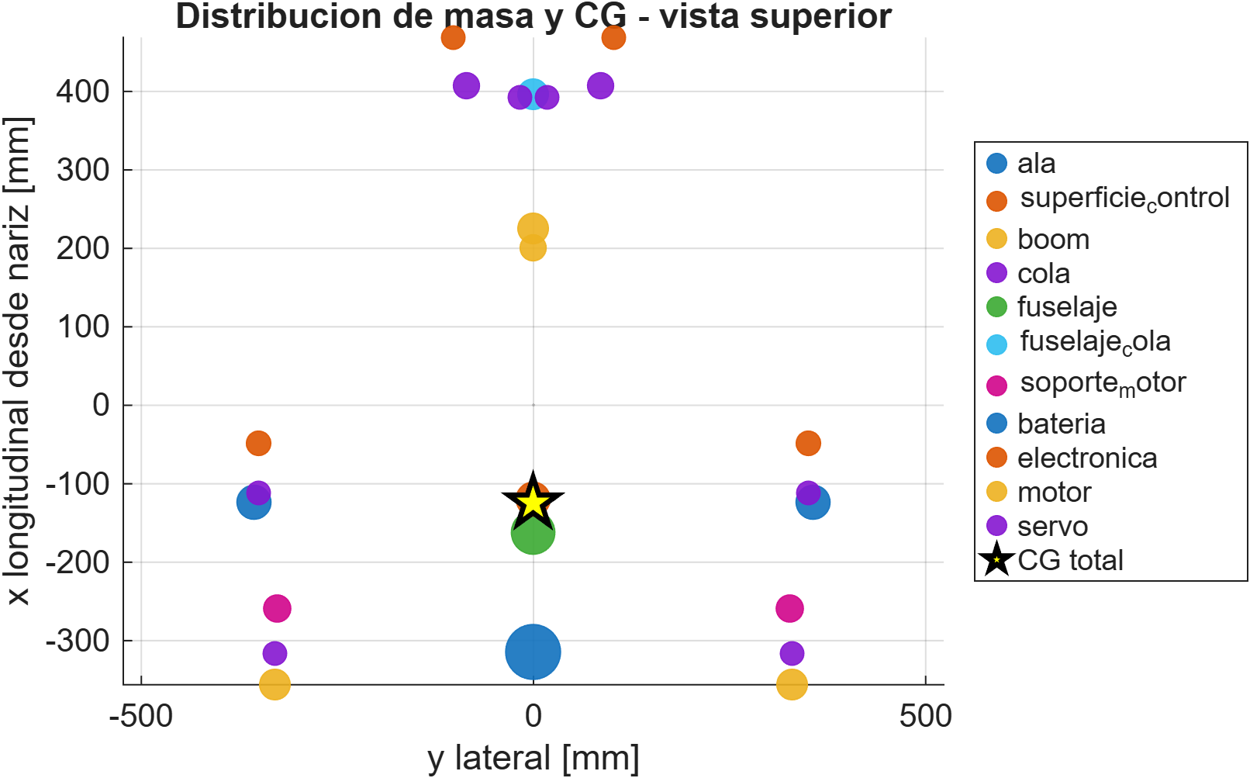
Simulacion_Matlab_SolidWorks/Vtol Stallion/MatLab_Simulaciones_Actualizado/resultados/figuras/04_VTOL_DXF_Distribucion_de_masa_y_CG_vista_superior.png
