XavierianAerospace/Plane_Proyect/Simulacion_Matlab_SolidWorks/Vtol Stallion/MatLab_Simulaciones_Actualizado/resultados/figuras/05_VTOL_DXF_Distribucion_de_masa_y_CG_vista_lateral.png

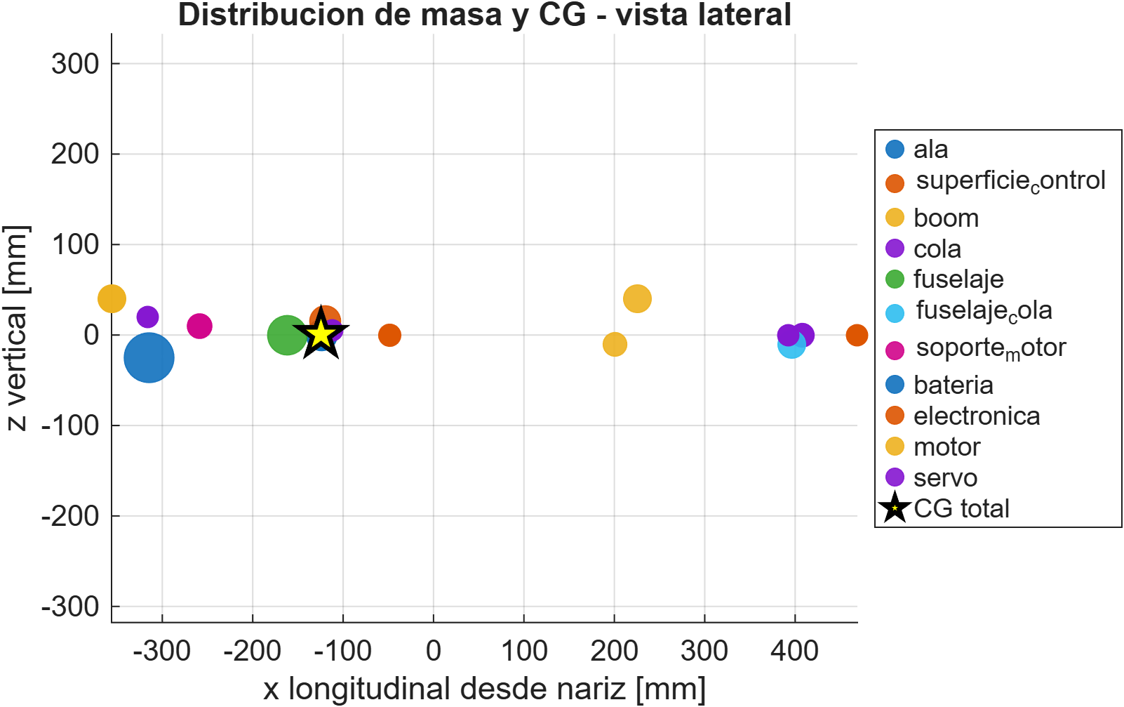
Simulacion_Matlab_SolidWorks/Vtol Stallion/MatLab_Simulaciones_Actualizado/resultados/figuras/05_VTOL_DXF_Distribucion_de_masa_y_CG_vista_lateral.png
