XavierianAerospace/Plane_Proyect/Simulacion_Matlab_SolidWorks/Vtol Stallion/MatLab_Simulaciones_Actualizado/resultados/figuras/07_VTOL_DXF_Masa_por_tipo.png

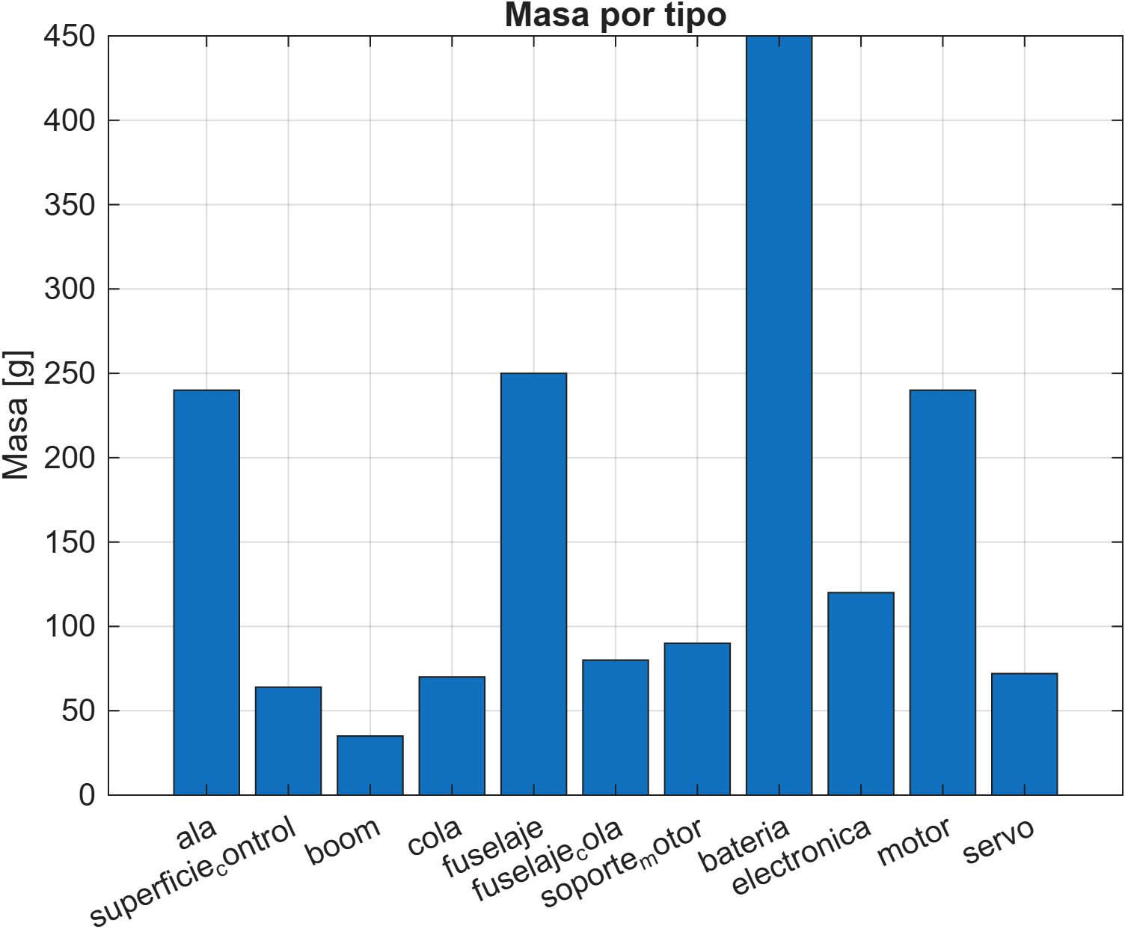
Simulacion_Matlab_SolidWorks/Vtol Stallion/MatLab_Simulaciones_Actualizado/resultados/figuras/07_VTOL_DXF_Masa_por_tipo.png
