XavierianAerospace/Plane_Proyect/Simulacion_Matlab_SolidWorks/Vtol Stallion/MatLab_Simulaciones_Actualizado/resultados/figuras/09_VTOL_DXF_Simulacion_Vuelo_VTOL.png

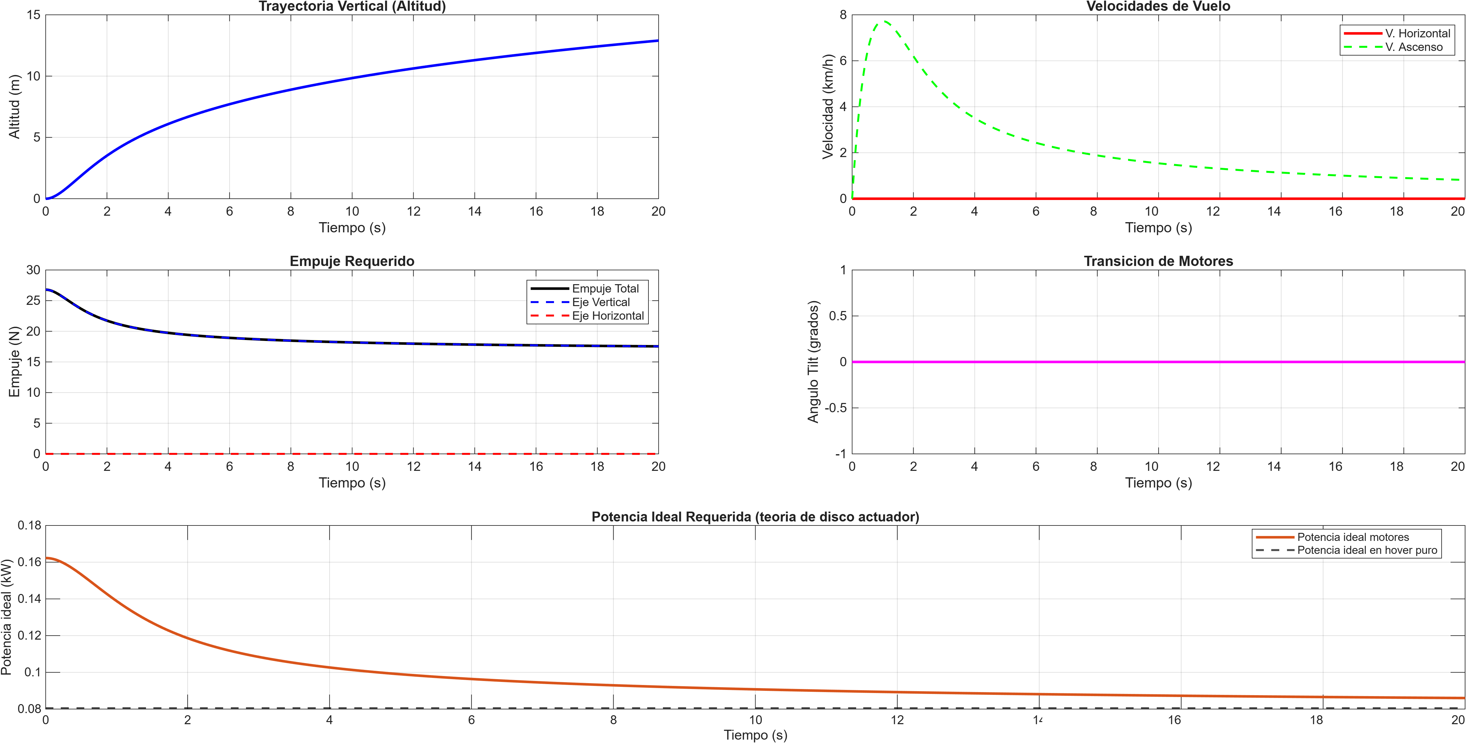
Simulacion_Matlab_SolidWorks/Vtol Stallion/MatLab_Simulaciones_Actualizado/resultados/figuras/09_VTOL_DXF_Simulacion_Vuelo_VTOL.png
