XavierianAerospace/Plane_Proyect/DOCUMENTACIÓN/PLANTILLAS/Plantillas de los Proyectos/Plantillas de los Proyectos/xae_P2_bitacora_de_sesion.docx

Bitácora de Sesión

Se llena cada vez que el equipo trabaja o se reúne, sin importar si es una hora o una tarde completa. Es el registro cronológico del proyecto.

Encabezado de la sesión

Proyecto | Fecha | Duración | Sesión #
Nombre del proyecto | DD/MM/AAAA | Ej: 2 horas | Número correlativo

Lugar / Modalidad | Quien registra esta bitácora
Ej: Lab 204 / Videollamada / Trabajo individual | Nombre del miembro que llena este documento

Participantes

Lista todos los que estuvieron en esta sesión. Ej: Santiago Castro, Juan Pablo Ruiz, Sofía Vega.

Objetivo de la sesión

¿Qué se quería lograr en esta sesión?

Una o dos oraciones. Ej: revisar el diseño del sistema de recuperación y definir el material del paracaídas.

Lo que se hizo

↳ Describe cronológicamente lo que pasó. No lo que se planeaba hacer: lo que efectivamente ocurrió.

Hora | Actividad / Lo que se hizo | Responsable
HH:MM | Describe la actividad con suficiente detalle para que alguien que no estuvo entienda qué pasó. | Nombre(s)
HH:MM | Describe la actividad con suficiente detalle para que alguien que no estuvo entienda qué pasó. | Nombre(s)
HH:MM | Describe la actividad con suficiente detalle para que alguien que no estuvo entienda qué pasó. | Nombre(s)
HH:MM | Describe la actividad con suficiente detalle para que alguien que no estuvo entienda qué pasó. | Nombre(s)
HH:MM | Describe la actividad con suficiente detalle para que alguien que no estuvo entienda qué pasó. | Nombre(s)
HH:MM | Describe la actividad con suficiente detalle para que alguien que no estuvo entienda qué pasó. | Nombre(s)
HH:MM | Describe la actividad con suficiente detalle para que alguien que no estuvo entienda qué pasó. | Nombre(s)
HH:MM | Describe la actividad con suficiente detalle para que alguien que no estuvo entienda qué pasó. | Nombre(s)

Decisiones tomadas en esta sesión

↳ Solo las decisiones que afectan el rumbo del proyecto. No las conversaciones: las conclusiones. Si no se tomó ninguna, escríbelo explícitamente.

Decisión tomada | ¿Por qué se tomó esta decisión? | ¿Quién la aprobó?
Describe la decisión de forma clara y definitiva. Ej: se usará nylon de 1.2 mm para el paracaídas principal. | Breve justificación técnica o práctica. | Nombre o 'Equipo completo'
Describe la decisión de forma clara y definitiva. Ej: se usará nylon de 1.2 mm para el paracaídas principal. | Breve justificación técnica o práctica. | Nombre o 'Equipo completo'
Describe la decisión de forma clara y definitiva. Ej: se usará nylon de 1.2 mm para el paracaídas principal. | Breve justificación técnica o práctica. | Nombre o 'Equipo completo'
Describe la decisión de forma clara y definitiva. Ej: se usará nylon de 1.2 mm para el paracaídas principal. | Breve justificación técnica o práctica. | Nombre o 'Equipo completo'

Evidencias de la sesión

↳ Lista todos los archivos, fotos, planos, cálculos o prototipos generados en esta sesión. Incluye el enlace o ruta donde están guardados.

Tipo de evidencia | Descripción / Nombre del archivo | Ubicación (enlace o ruta) | Formato
Foto / Plano / Cálculo / Video / Documento / Prototipo | Ej: Plano del sistema de recuperación v2 | Drive / GitHub / Carpeta local | .pdf / .jpg / .dwg
Foto / Plano / Cálculo / Video / Documento / Prototipo | Ej: Plano del sistema de recuperación v2 | Drive / GitHub / Carpeta local | .pdf / .jpg / .dwg
Foto / Plano / Cálculo / Video / Documento / Prototipo | Ej: Plano del sistema de recuperación v2 | Drive / GitHub / Carpeta local | .pdf / .jpg / .dwg
Foto / Plano / Cálculo / Video / Documento / Prototipo | Ej: Plano del sistema de recuperación v2 | Drive / GitHub / Carpeta local | .pdf / .jpg / .dwg
Foto / Plano / Cálculo / Video / Documento / Prototipo | Ej: Plano del sistema de recuperación v2 | Drive / GitHub / Carpeta local | .pdf / .jpg / .dwg
Foto / Plano / Cálculo / Video / Documento / Prototipo | Ej: Plano del sistema de recuperación v2 | Drive / GitHub / Carpeta local | .pdf / .jpg / .dwg

Pendientes y compromisos

↳ Lo que quedó acordado para antes de la próxima sesión. Si alguien se comprometió a algo, queda registrado aquí.

¿Qué queda pendiente? | Responsable | Fecha límite
Tarea o entregable pendiente | Nombre | DD/MM/AAAA
Tarea o entregable pendiente | Nombre | DD/MM/AAAA
Tarea o entregable pendiente | Nombre | DD/MM/AAAA
Tarea o entregable pendiente | Nombre | DD/MM/AAAA
Tarea o entregable pendiente | Nombre | DD/MM/AAAA

¿Se logró el objetivo de la sesión? | Próxima sesión planificada
Sí / Parcialmente / No. Si no: ¿por qué? | DD/MM/AAAA · Hora estimada · Lugar

XAVERIAN AEROSPACE ENGINEERING Bitácora de Sesión Versión 1.0 · 2025
