XavierianAerospace/Plane_Proyect/Simulacion_Matlab_SolidWorks/Vtol Stallion/MatLab_Simulaciones/resultados/figuras/01_VTOL_DXF_DXF_avion_2D_deteccion_inicial.pdf

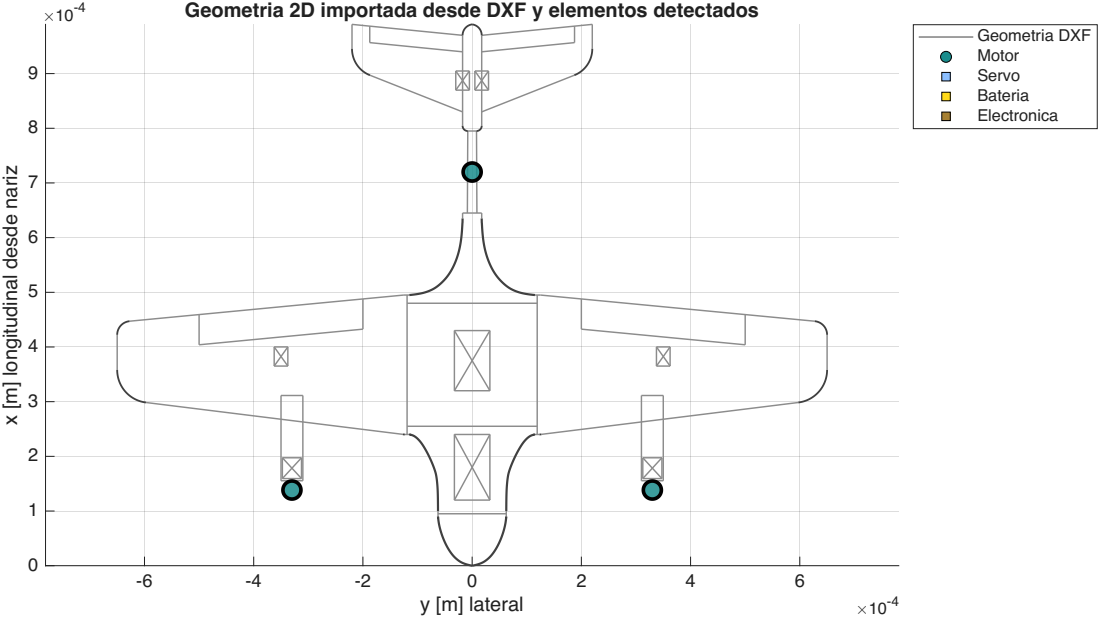
[picture p115: page 1]
y [m] lateral; gitu; din; ariz; Geometria 2D importada desde DXF y elementos detectados; Geometria DXF Motor Servo Bateria Electronica
