XavierianAerospace/Plane_Proyect/Simulacion_Matlab_SolidWorks/Vtol Stallion/MatLab_Simulaciones/resultados/figuras/04_VTOL_DXF_Distribucion_de_masa_y_CG_vista_superior.pdf

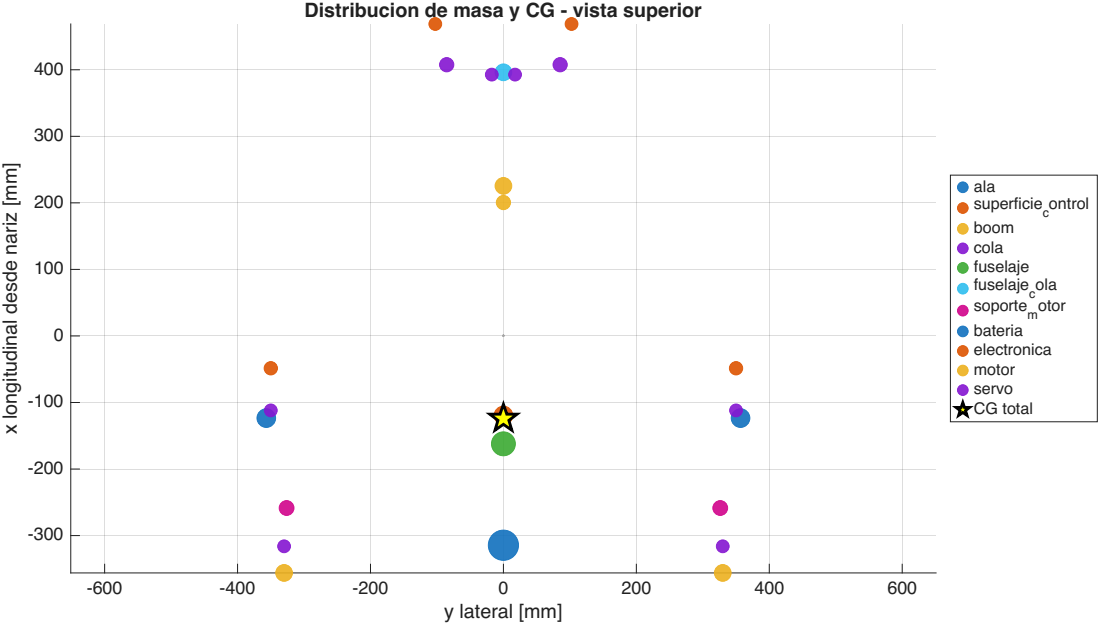
[picture p116: page 1]
Dis; rib; cio; vis; rio; ala sup e; cie

x longitudinal desde nariz [mm]

ol boom cola fuselaje fuselajecola soportemotor bateria electronica motor servo CG total
