XavierianAerospace/Plane_Proyect/Simulacion_Matlab_SolidWorks/Vtol Stallion/MatLab_Simulaciones/resultados/figuras/05_VTOL_DXF_Distribucion_de_masa_y_CG_vista_lateral.pdf

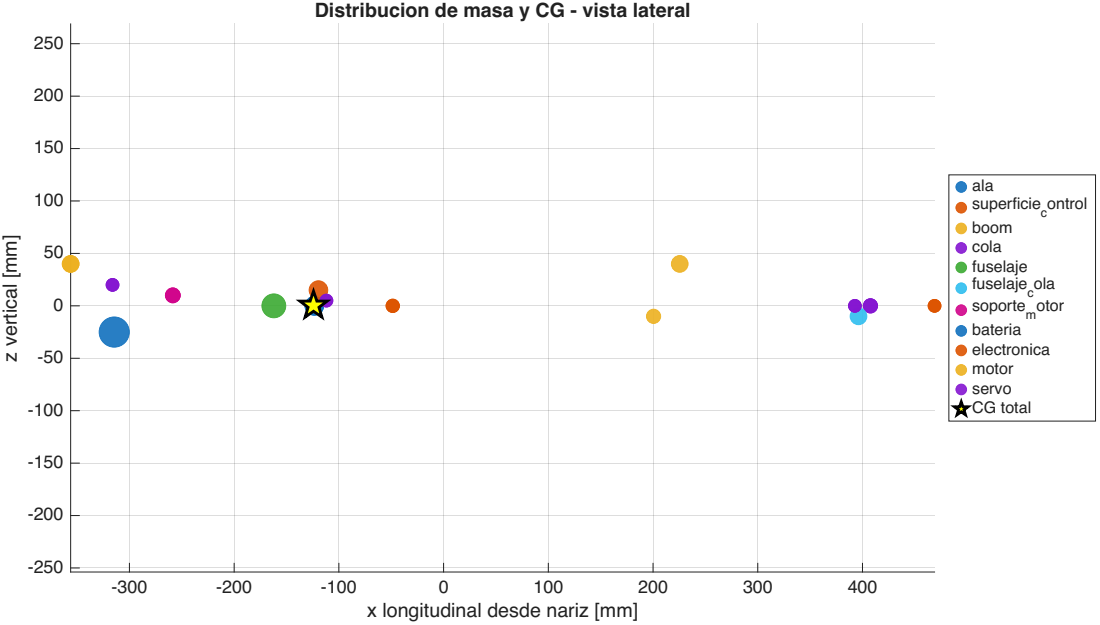
[picture p117: page 1]
ertic; ala superficie; control; boom cola fuselaje fuselaje; cola soportem; otor; bateria electronica motor servo CG total

Distribucion de masa y CG - vista lateral

x longitudinal desde nariz [mm]
