XavierianAerospace/Plane_Proyect/Simulacion_Matlab_SolidWorks/Vtol Stallion/MatLab_Simulaciones_Actualizado/resultados/figuras/01_VTOL_DXF_DXF_avion_2D_deteccion_inicial.pdf

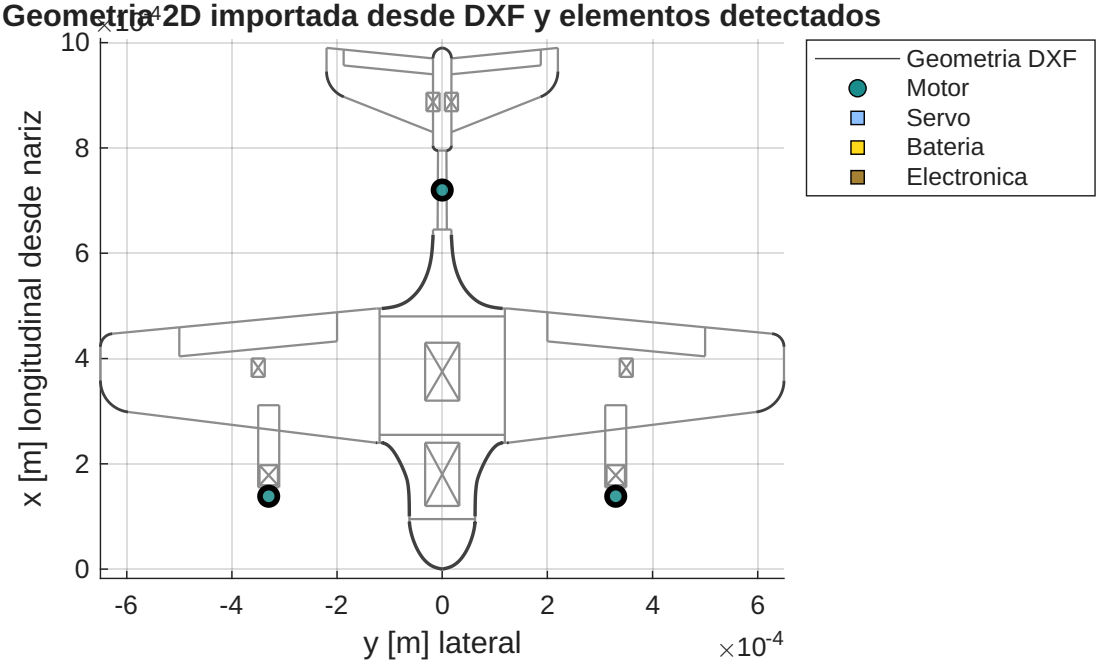
[picture p118: page 1]
y [m] lateral; gitu; din; ariz; Geometria DXF Motor Servo Bateria Electronica

#10 Geome -4 tria 2D importada desde DXF y elementos detectados
