XavierianAerospace/Plane_Proyect/Simulacion_Matlab_SolidWorks/Vtol Stallion/MatLab_Simulaciones_Actualizado/resultados/figuras/04_VTOL_DXF_Distribucion_de_masa_y_CG_vista_superior.pdf

### Distribucion de masa y CG - vista superior

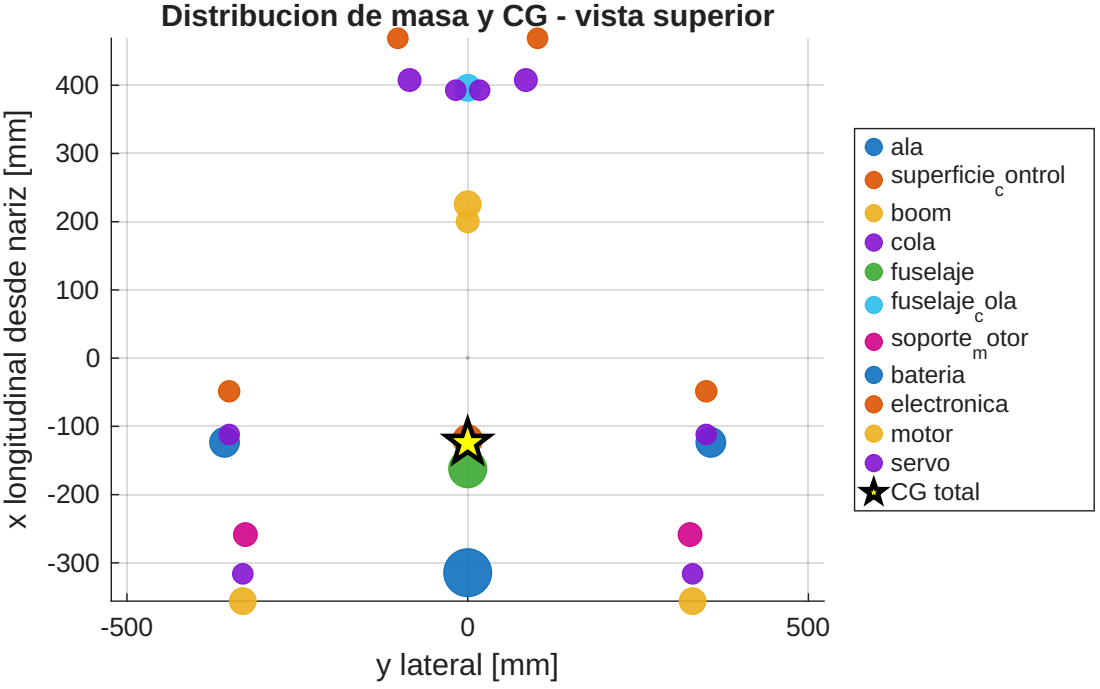
[picture p119: page 1]
y lateral [mm]; gitu; din; ariz [m; ala superficie c; ontrol; boom cola fuselaje fuselaje c; ola soportem; otor; bateria electronica motor servo CG total
