XavierianAerospace/Plane_Proyect/Simulacion_Matlab_SolidWorks/Vtol Stallion/MatLab_Simulaciones_Actualizado/resultados/figuras/05_VTOL_DXF_Distribucion_de_masa_y_CG_vista_lateral.pdf

### Distribucion de masa y CG - vista lateral

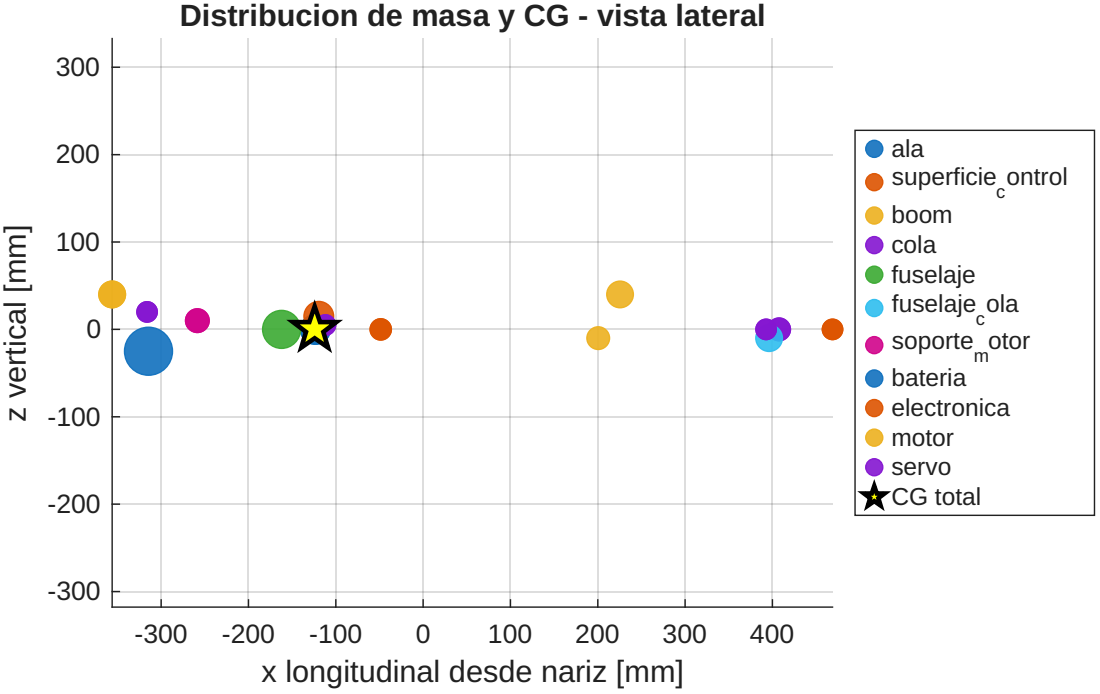
[picture p120: page 1]
ertic; ala superficie c; ontrol; boom cola fuselaje fuselaje c; ola soportem; otor; bateria electronica motor servo CG total

x longitudinal desde nariz [mm]
