XavierianAerospace/Plane_Proyect/Simulacion_Matlab_SolidWorks/Vtol Stallion/MatLab_Simulaciones_Actualizado/resultados/figuras/09_VTOL_DXF_Simulacion_Vuelo_VTOL.pdf

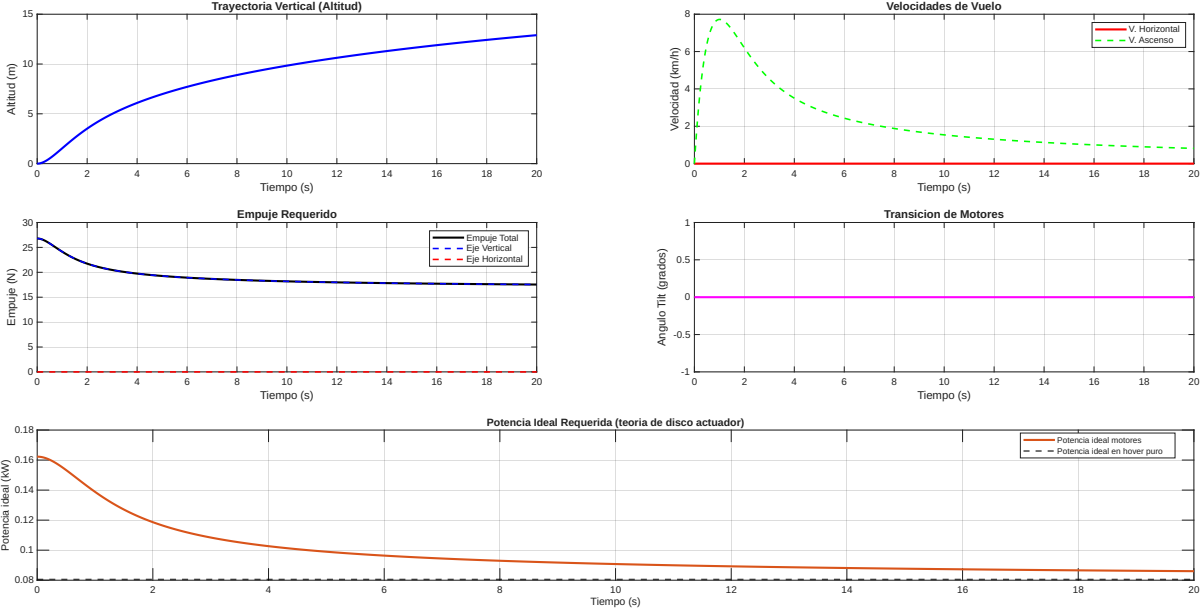
[picture p121: page 1]
Tie; Altitud (m); ria; tic; Altit; Velocidad (km/h); Velo; cid; elo; riz; al V. Ascenso; Empuje (N); rid; al Eje Vertical Eje Horizontal; sicio; cia; dis; cia id

Angulo Tilt (grados)

Potencia ideal (kW)
