XavierianAerospace/Plane_Proyect/Simulacion_Matlab_SolidWorks/Vtol Stallion/MatLab_Simulaciones/cad/Piezas3D/Diseño Avion/Archivos_Avion_Vtol_Completo/Planos_Avion.pdf

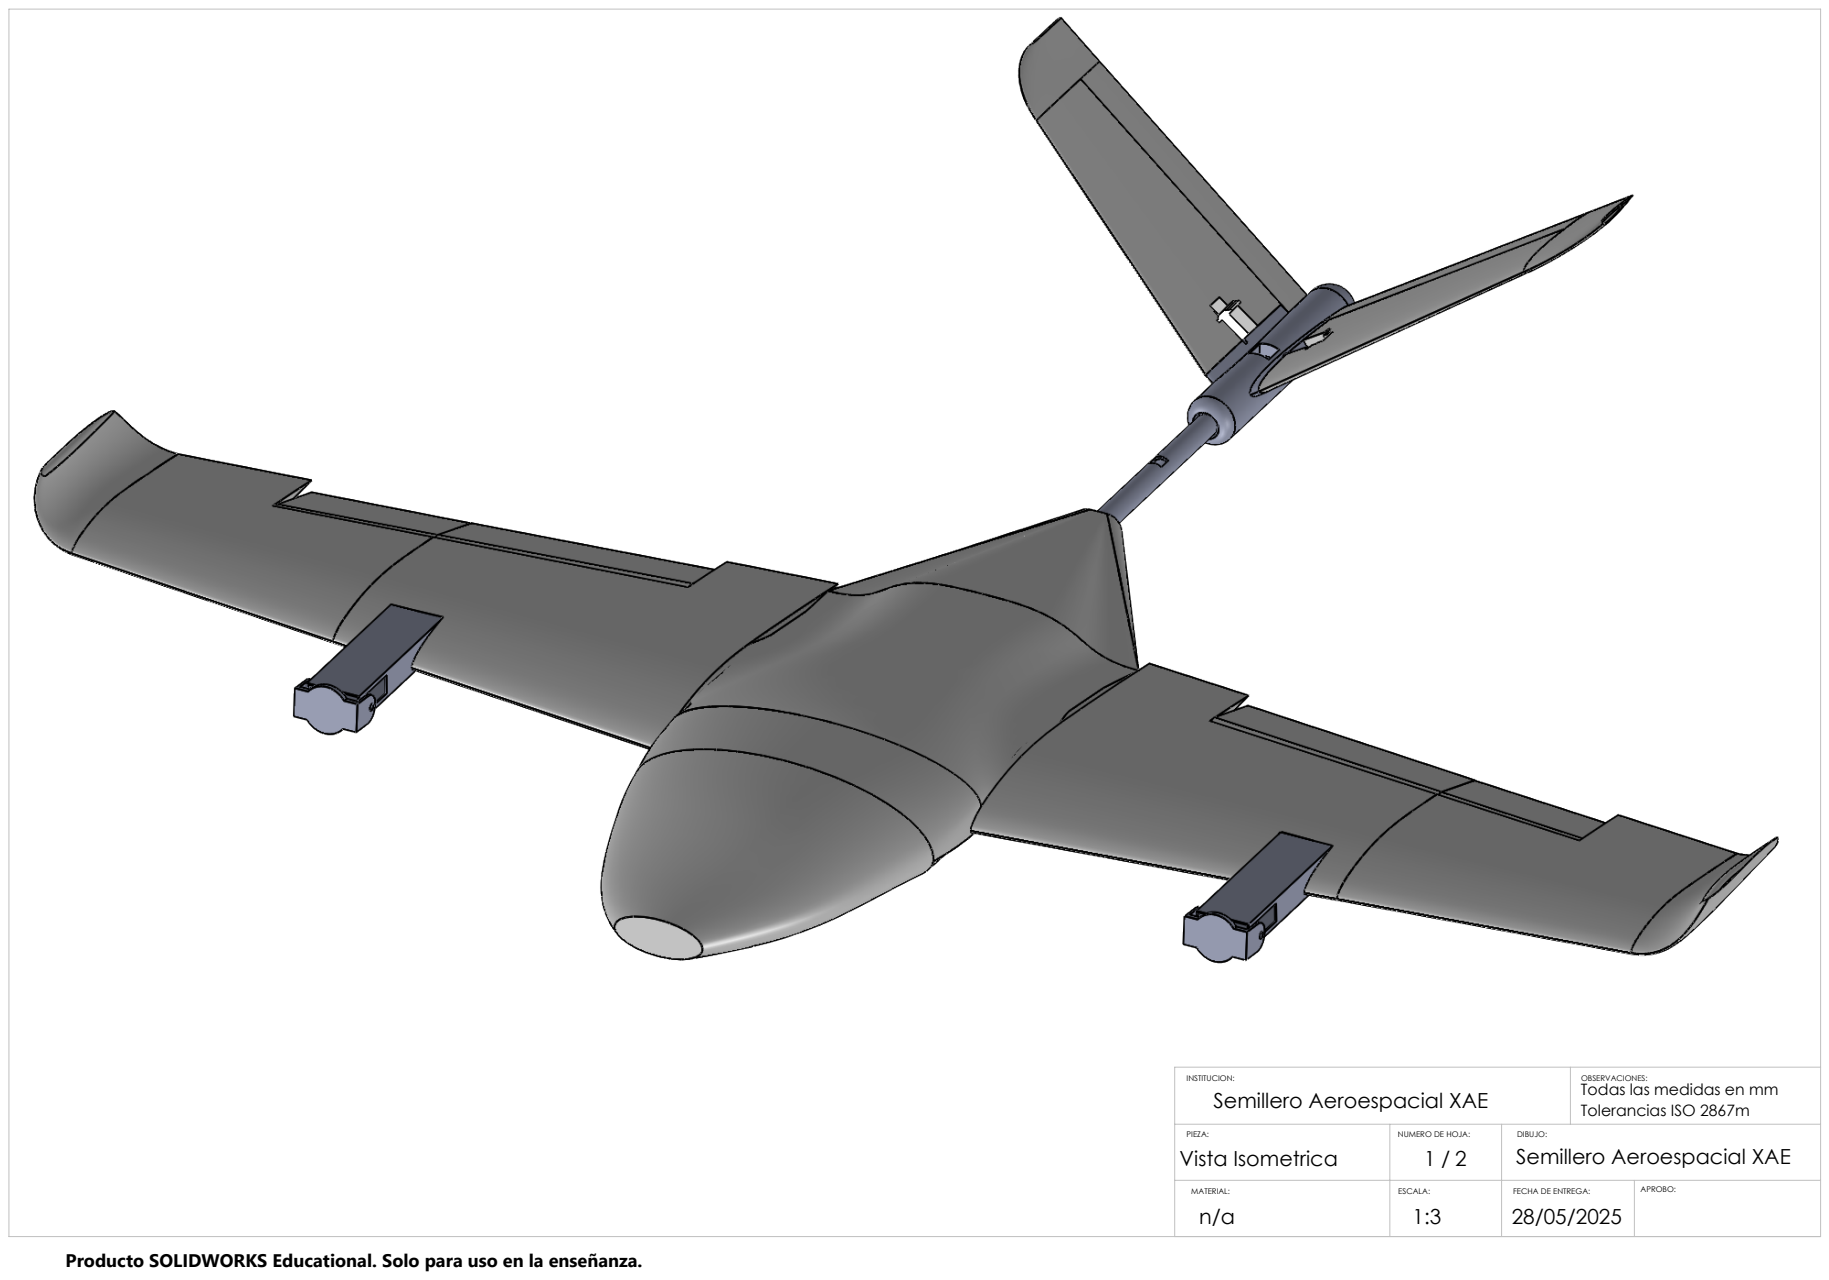
[picture p122: page 1]

INSTITUCION: Semillero Aeroespacial XAE | OBSERVACIONES: Todas las medidas en mm Tolerancias ISO 2867m

PIEZA: Vista Isometrica | NUMERO DE HOJA: 1 / 2 | DIBUJO: Semillero Aeroespacial XAE

MATERIAL: n/a | ESCALA: 1:3 | FECHA DE ENTREGA: 28/05/2025 | APROBO:

Producto SOLIDWORKS Educational. Solo para uso en la enseñanza.

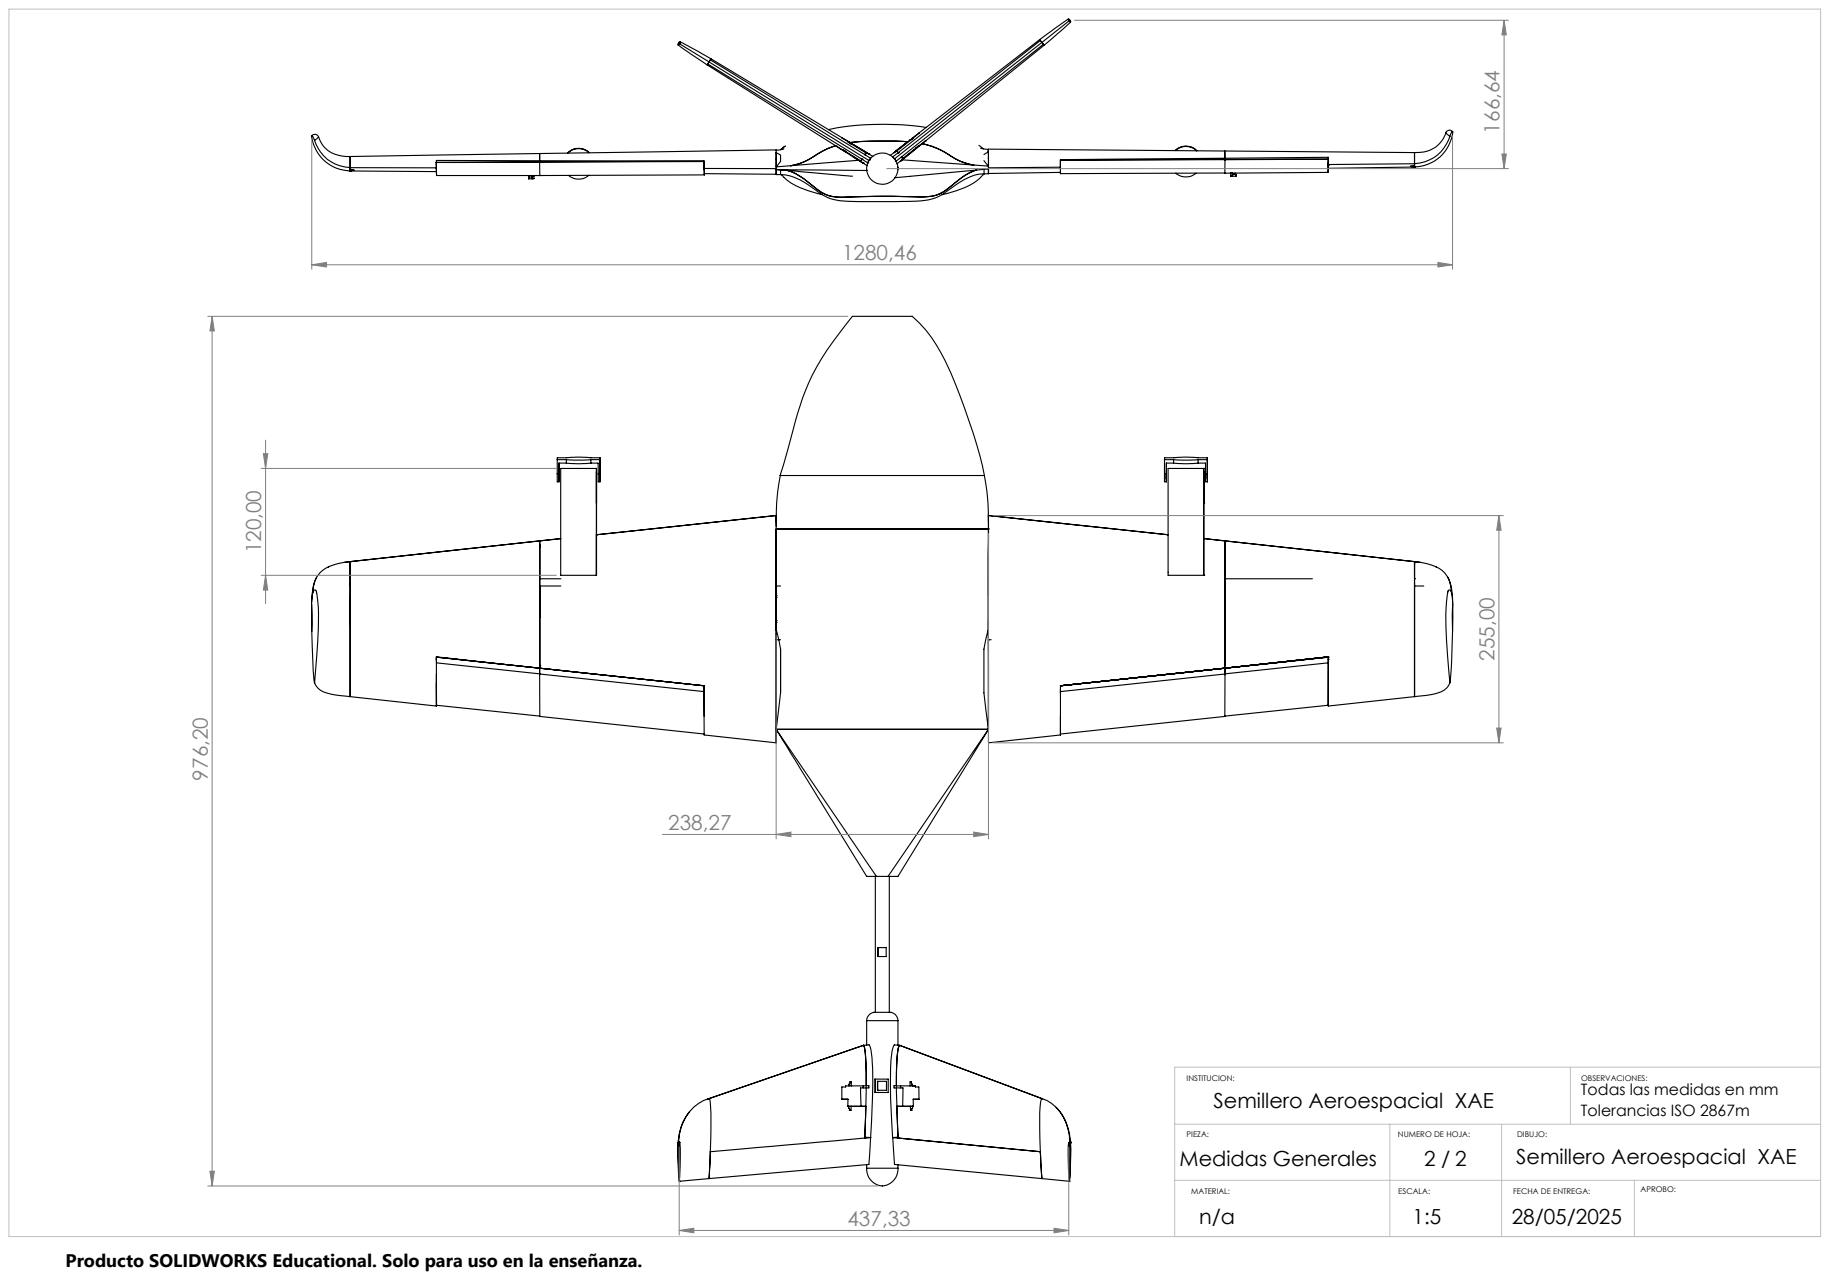
[picture p123: page 2]

INSTITUCION: Semillero Aeroespacial XAE | OBSERVACIONES: Todas las medidas en mm Tolerancias ISO 2867m

PIEZA: Medidas Generales | NUMERO DE HOJA: 2 / 2 | DIBUJO: Semillero Aeroespacial XAE

MATERIAL: n/a | ESCALA: 1:5 | FECHA DE ENTREGA: 28/05/2025 | APROBO:

Producto SOLIDWORKS Educational. Solo para uso en la enseñanza.
