XavierianAerospace/Plane_Proyect/Simulacion_Matlab_SolidWorks/Vtol Stallion/MatLab_Simulaciones/resultados/figuras/02_VTOL_DXF_Partes_DXF_separadas_geometria_real.pdf

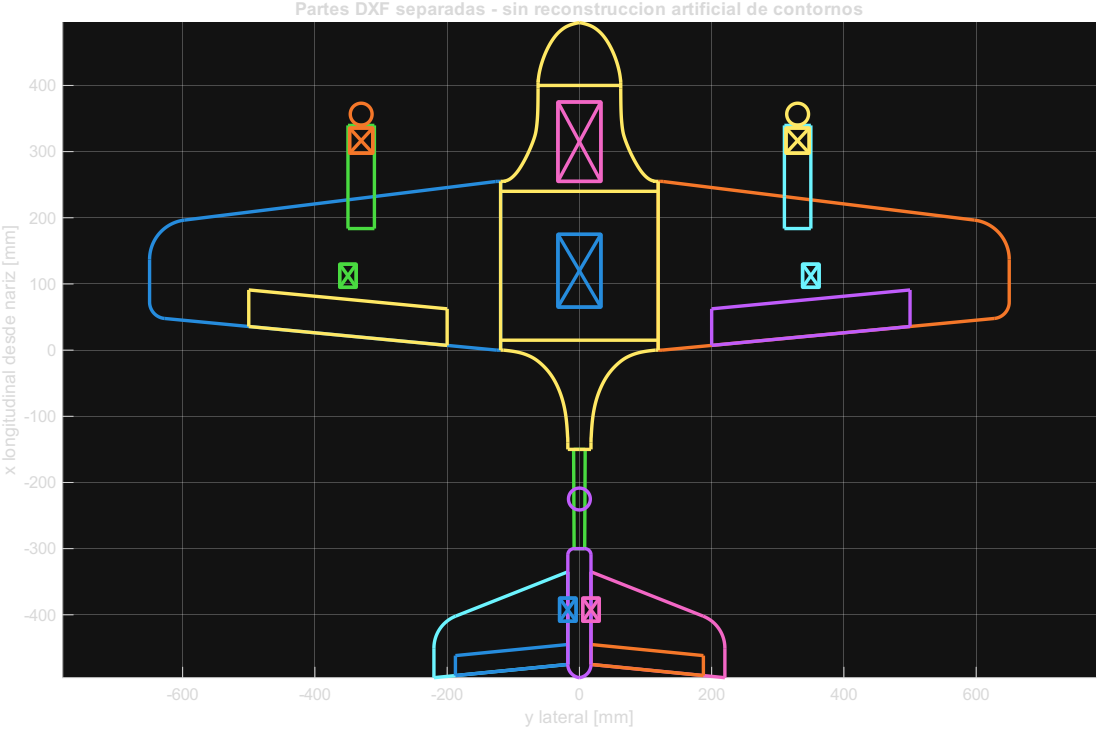
[picture p125: page 1]
y lateral [mm]; x longitudinal d; e nariz [m

Partes DXF separadas - sin reconstruccion artificial de contornos
