XavierianAerospace/Plane_Proyect/Simulacion_Matlab_SolidWorks/Vtol Stallion/MatLab_Simulaciones/resultados/figuras/02_VTOL_DXF_Partes_DXF_separadas_geometria_real_resaltada.pdf

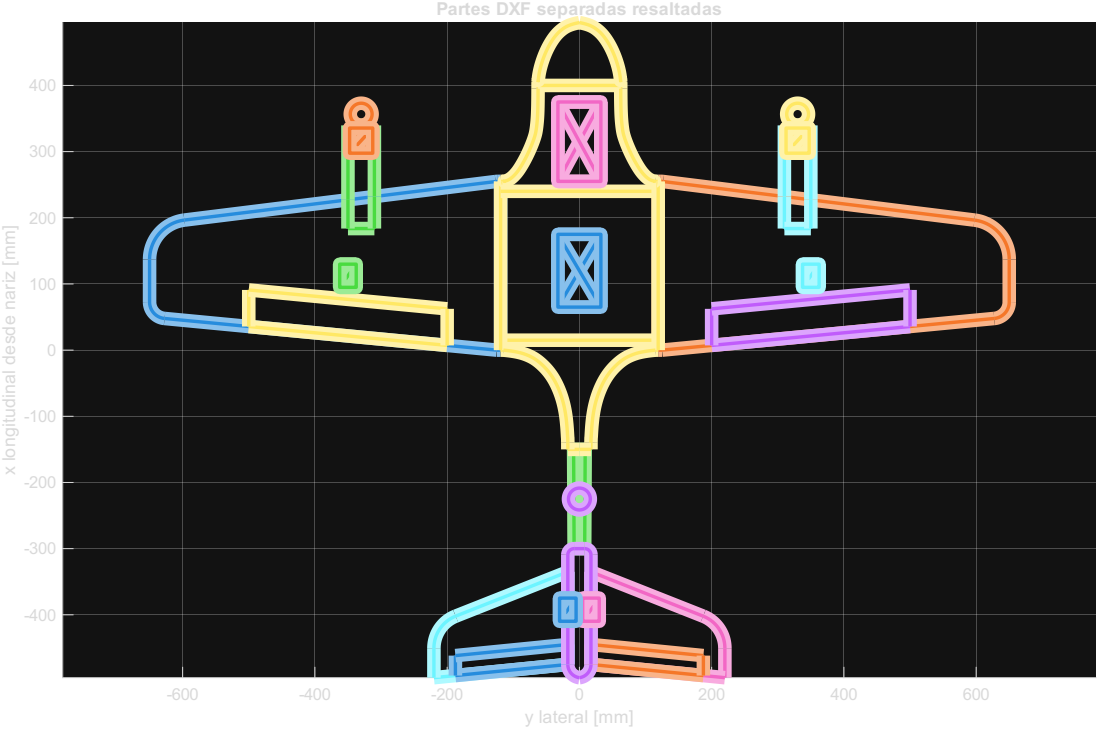
[picture p126: page 1]
y lateral [mm]; x longitudinal d; e nariz [m

Partes DXF separadas resaltadas
