XavierianAerospace/Plane_Proyect/Simulacion_Matlab_SolidWorks/Vtol Stallion/MatLab_Simulaciones/resultados/figuras/02_VTOL_DXF_Partes_DXF_sobre_silueta_general.pdf

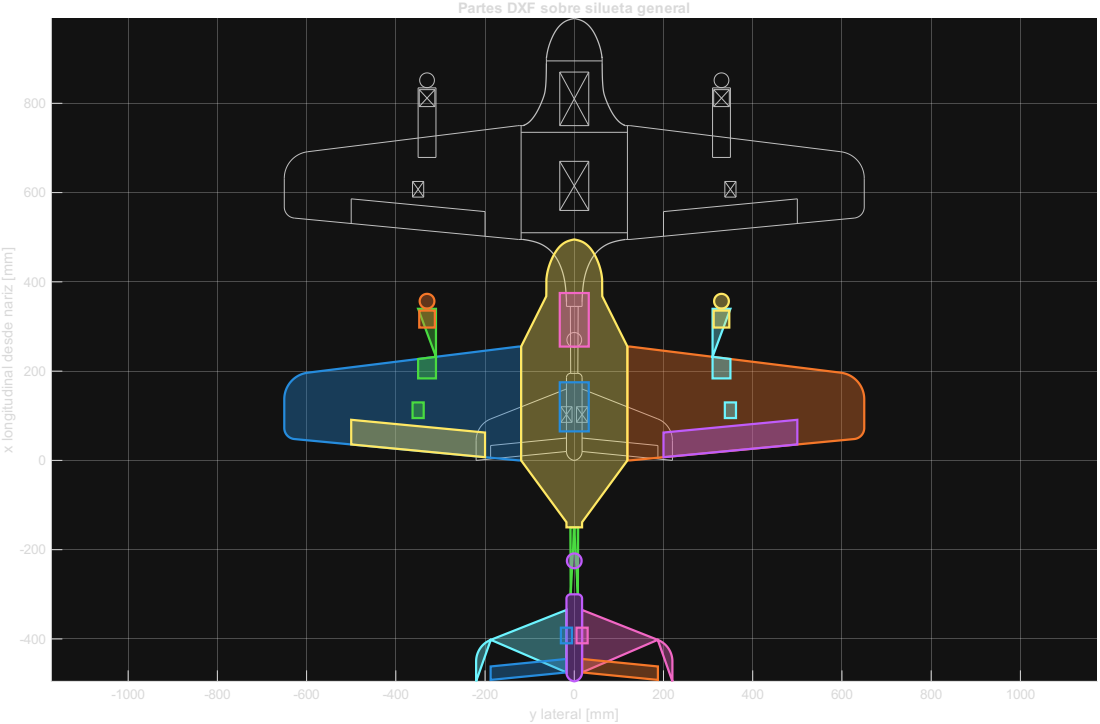
[picture p128: page 1]
y lateral [mm]; x longitudinal d; e nariz [m

Partes DXF sobre silueta general
