XavierianAerospace/Plane_Proyect/Simulacion_Matlab_SolidWorks/Vtol Stallion/MatLab_Simulaciones/resultados/figuras/02_VTOL_DXF_Zonas_estructurales_sobre_silueta_DXF.pdf

Z

o

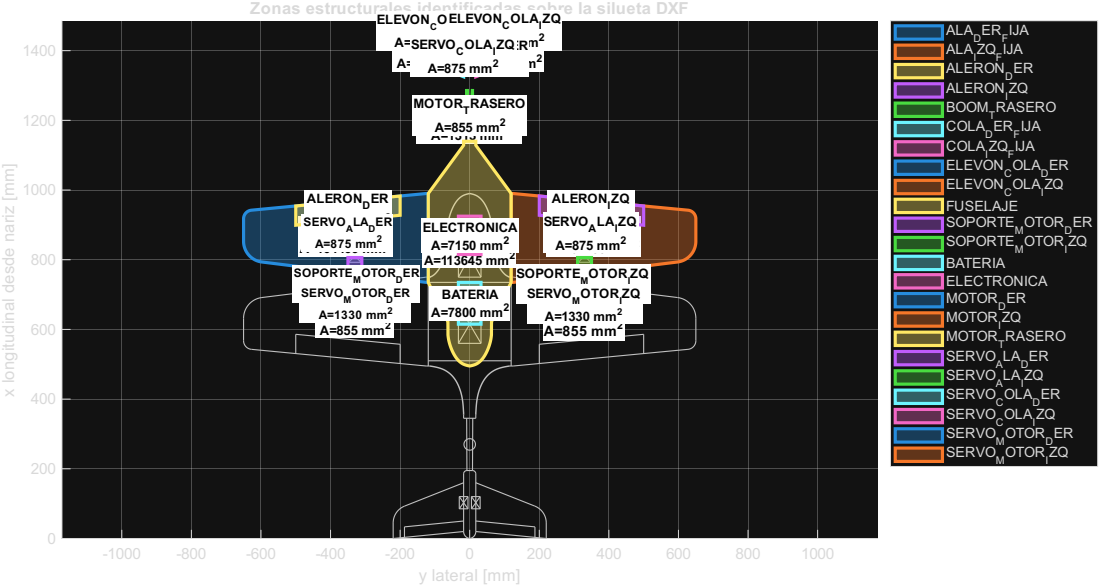
[picture p129: page 1]
FIJ; AIZ; NIZ; RIZ; RIA; NIC

x longitudinal desde nariz [mm]
