XavierianAerospace/Plane_Proyect/Simulacion_Matlab_SolidWorks/Vtol Stallion/MatLab_Simulaciones_Actualizado/resultados/figuras/02_VTOL_DXF_Partes_DXF_separadas_con_area_transparente.pdf

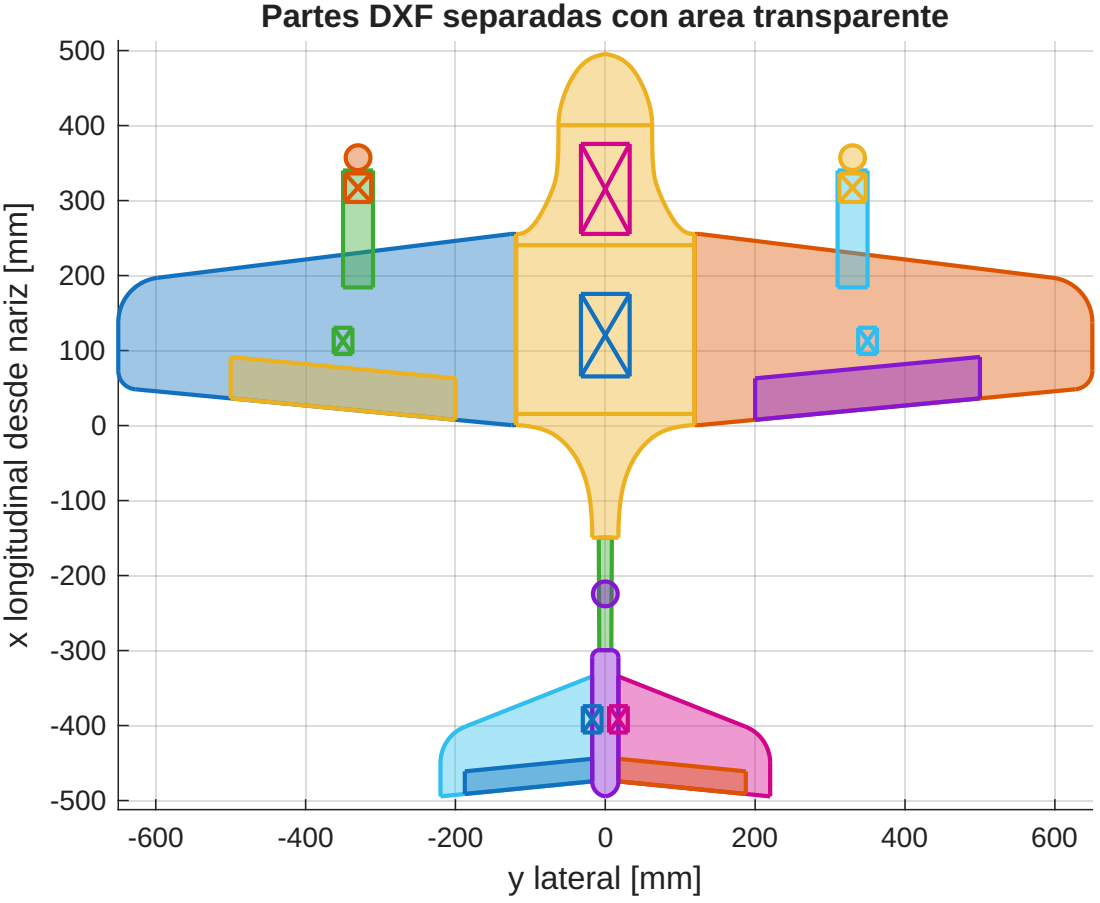
[picture p130: page 1]
y lateral [mm]; gitu; din; ariz [m

Partes DXF separadas con area transparente
