XavierianAerospace/Plane_Proyect/(commit log)

2026-04-06 AGREGANDO ENSAMBLE Y PIEZAS DE LA CAJA DEL AVION
    [CPU.SLDPRT, Ensamblaje distribucion CE.SLDASM, Tabla.SLDPRT, batería.SLDPRT, servomotor.SLDPRT]
2026-04-12 Archivos del modelo general del avion, avances semanales.
    [CPU.SLDPRT, Ensamblaje distribucion CE.SLDASM, Tabla.SLDPRT, batería.SLDPRT, cuerpo_superior.SLDPRT, servomotor.SLDPRT]
2026-04-12 Agrega archivos de Estructura General
    [AIRFOIL TIP 2024.SLDPRT, Ala Avion.SLDPRT, Ala Inferior Avion.SLDPRT, Ala Traseras Avion.SLDPRT, BACK FLAPS SUPPORT 2024.SLDPRT, Cola.SLDPRT, Ensamblaje Avion Completo.SLDASM, LEADING EDGE DOUBLER 2024.SLDPRT]
2026-04-15 COMPONENTES Y DISEÑO TREN DE ATERRIZAJE AVION
    [eje inferior nose gear.SLDPRT, eje superior nose gear.SLDPRT, main landing gear.SLDPRT, nose gear inferior.SLDPRT, nose gear superior.SLDPRT, rueda avión.SLDPRT, tren de aterrizaje delantero.SLDASM]
2026-04-22 piezas tren de aterrizaje
    [eje inferior nose gear.SLDPRT, eje superior nose gear.SLDPRT, main landing gear.SLDPRT, nose gear inferior.SLDPRT, nose gear superior.SLDPRT, rueda avión.SLDPRT, tren de aterrizaje delantero.SLDASM]
2026-04-22 moviendo tren de aterrizaje a carpeta modelo 3d avión
    [eje inferior nose gear.SLDPRT, eje superior nose gear.SLDPRT, main landing gear.SLDPRT, nose gear inferior.SLDPRT, nose gear superior.SLDPRT, rueda avión.SLDPRT, tren de aterrizaje delantero.SLDASM]
2026-04-22 cargando plantillas, carpetas para documentación
2026-04-22 Creando carpetas para la organización de los reportes
    [AIRFOIL TIP 2024.SLDPRT, Ala Avion.SLDPRT, Ala Inferior Avion.SLDPRT, Ala Traseras Avion.SLDPRT, BACK FLAPS SUPPORT 2024.SLDPRT, CPU.SLDPRT, Cola.SLDPRT, Ensamblaje Avion Completo.SLDASM]
2026-05-02 Subiendo ensamble de tren de aterizaje e incorporandolo al ensamble del avión
    [Ala Inferior Avion.SLDPRT, Ala Traseras Avion.SLDPRT, Cola.SLDPRT, Ensamblaje Avion Completo.SLDASM, Principal Cuerpo Avion.SLDPRT, cuerpo tren.SLDPRT, eje tren de aterrizaje.SLDPRT, ensamble tren de aterrizaje.SLDASM]
2026-05-02 moviendo tren de aterrizaje a carpeta de estructura general de
    [cuerpo tren.SLDPRT, eje tren de aterrizaje.SLDPRT, ensamble tren de aterrizaje.SLDASM, rueda avión.SLDPRT, tuerca.SLDPRT]
2026-05-02 añadiendo placa de madera y corrección del tren de aterrizaje
    [Ensamblaje Avion Completo.SLDASM, cuerpo tren.SLDPRT, ensamble tren de aterrizaje.SLDASM, placa de madera.SLDPRT]
2026-05-09 Modelo del montaje de pruebas de motor brushless
    [15 cm Propeller.SLDPRT, Base1.SLDPRT, Bearing_Ball_6200_2RS.SLDPRT, Bracket 40(imprimir).SLDPRT, Bracket 40(imprimir).STL, Bracket 40.SLDPRT, Brazo.SLDPRT, Celda de carga.SLDPRT]
2026-05-11 Prueba de esfuerzos tren de aterrizaje
    [cuerpo tren.SLDPRT, eje tren de aterrizaje.SLDPRT, ensamble tren de aterrizaje.SLDASM]
2026-05-29 Agregando ensamble del tren de aterrizaje delantero fijo
    Ya se simulo los esfuerzos de carga, falta aprobacion
    [CUERPO TREN DE ATERRIZAJE FIJO.SLDPRT, EJE.SLDPRT, ENSAMBLE TREN DE ATERRIZAJE FIJO.SLDASM, Ensamblaje Avion Completo.SLDASM, RUEDA.SLDPRT, cuerpo tren.SLDPRT, eje tren de aterrizaje.SLDPRT, ensamble tren de aterrizaje.SLDASM]
2026-05-29 agregando tren de aterrizaje al avion
    [CUERPO TREN DE ATERRIZAJE FIJO.SLDPRT, ENSAMBLE TREN DE ATERRIZAJE FIJO.SLDASM, Ensamblaje Avion Completo.SLDASM]
2026-07-17 Adelanto modelo de simulacion 2D avion + solidworks2d
    [ALA_DER_FIJA.DXF, ALA_IZQ_FIJA.DXF, ALERON_DER.DXF, ALERON_IZQ.DXF, BATERIA.DXF, BOOM_TRASERO.DXF, COLA_DER_FIJA.DXF, COLA_IZQ_FIJA.DXF]
2026-07-17 Cambios y Seguimiento del codigo, impleentacion de centros de masa y resultados.
    [VTOL_GENERAL.DXF, componentes_vtol_base.csv]
2026-07-17 Archivos y Documentos de informacion actual del proyecto.
2026-07-24 Create BOM
2026-08-04 Cambios en el modelo 3D del avion, ultima version.
    [Ala_Vtol_Primera_Etapa.SLDPRT, Ala_Vtol_Primera_Etapa1.SLDPRT, Ala_Vtol_Segunda_Etapa.SLDPRT, Ala_Vtol_Segunda_Etapa1.SLDPRT, Ensamblaje_Alas_Vtol.SLDASM, Ensamblaje_Alas_Vtol_Espejo_Derecho.SLDASM, Ensamblaje_Completo_Vtol.SLDASM, Ensamblaje_Fuselaje_Vtol.SLDASM]
2026-08-04 Ultimos archivos guardados de la anterior version.
    [Ensamblaje_Fuselaje_Vtol.SLDASM]
2026-08-05 Flight Controller
    [Matek F405.step.SLDPRT]
2026-08-07 agregando piezas y ensamble de cola VTOL
    [Ensamble_cola.SLDASM, cilindro_cola.SLDPRT, cola vtol.SLDPRT, cuerpo de cola.SLDPRT, cuerpo tren.SLDPRT, ensamble tren de aterrizaje.SLDASM, flap_cola.SLDPRT]
2026-08-13 soporte para servo motores en el ala
    [Ala_Vtol_Segunda_Etapa.SLDPRT, Ala_Vtol_Segunda_Etapa1.SLDPRT]
2026-08-14 Graficas Matlab
    Graficas Matlab
    [componentes_vtol_base.csv]
2026-08-16 Soporte para servo Ds939mg en alas
    [Ala_Vtol_Segunda_Etapa.SLDPRT]
2026-08-17 Agregando sistema de servos y ejes de soporte de alas.
    [Ala_Vtol_Primera_Etapa.SLDPRT, Ala_Vtol_Primera_Etapa1.SLDPRT, Ala_Vtol_Segunda_Etapa.SLDPRT, Ala_Vtol_Segunda_Etapa1.SLDPRT, Corona_DS939MG_filDroit.SLDASM, Eje_flaps.SLDPRT, Ensamblaje_Alas_Vtol.SLDASM, Ensamblaje_Alas_Vtol_Espejo_Derecho.SLDASM]
2026-08-23 Cambios solid.
    [Corona_DS939MG_filDroit.SLDASM, Ensamblaje_Alas_Vtol.SLDASM, Ensamblaje_Fuselaje_Vtol.SLDASM, Fuselaje_Vtol_Central.SLDPRT, Fuselaje_Vtol_Trasero.SLDPRT]
2026-08-23 Fuselaje Trasero en el avion.
    [Ensamblaje_Fuselaje_Vtol.SLDASM, Fuselaje_Vtol_Central.SLDPRT, Fuselaje_Vtol_Trasero.SLDPRT]
2026-08-23 Avion Basico Completo
    [Ala_Vtol_Primera_Etapa1.SLDPRT, Ala_Vtol_Segunda_Etapa.SLDPRT, Ala_Vtol_Segunda_Etapa1.SLDPRT, Corona_DS939MG_filDroit.SLDASM, Corona_DS939MG_filDroit1.SLDASM, Eje_flaps1.SLDPRT, Ensamblaje_Alas_Vtol.SLDASM, Ensamblaje_Alas_Vtol_Derecho.SLDASM]
2026-08-25 Avion Completo
    [Corona_DS939MG_filDroit1.SLDASM, Ensamblaje_Alas_Vtol_Derecho.SLDASM, Ensamblaje_Completo_Vtol.SLDASM]
2026-09-07 AVION PERFECTO SIN ERRORES
    [Corona_DS939MG_filDroit1.SLDASM, Ensamblaje_Alas_Vtol.SLDASM, Ensamblaje_Alas_Vtol_Derecho.SLDASM, Ensamblaje_Completo_Alas_Vtol.SLDASM, Ensamblaje_Completo_Vtol.SLDASM]
2026-09-08 subiendo enganche para ensamble de fuselaje con alas
    [Ala_Vtol_Segunda_Etapa1.SLDPRT, Corona_DS939MG_filDroit1.SLDASM, Ensamblaje_Alas_Vtol.SLDASM, Ensamblaje_Alas_Vtol_Derecho.SLDASM, Ensamblaje_Completo_Alas_Vtol.SLDASM, Ensamblaje_Completo_Vtol.SLDASM, Ensamblaje_Fuselaje_Vtol.SLDASM, Fuselaje_Vtol_Central.SLDPRT]
2026-09-08 Cambios JAS
    [Eje_flaps1.SLDPRT, Ensamblaje_Alas_Vtol_Derecho.SLDASM, Ensamblaje_Completo_Alas_Vtol.SLDASM, Ensamblaje_Completo_Vtol.SLDASM, Ensamble_cola.SLDASM, Planos_Avion.SLDDRW, cola vtol.SLDPRT, flap_cola.SLDPRT]
2026-09-11 cargando sistema de ensamble de alas y archivo con los stl
    [Fuselaje_Vtol_Central.SLDPRT, ensamble_snapFit.SLDASM, gancho.SLDPRT, hembra.SLDPRT]
2026-09-11 subiendo stl y sistema de ensamble de alas al fuselaje
    [gancho.STL, hembra.STL]
2026-09-22 snap fit completo
    [Ala_Vtol_Primera_Etapa.SLDPRT, Ala_Vtol_Primera_Etapa1.SLDPRT, Corona_DS939MG_filDroit.SLDASM, Corona_DS939MG_filDroit1.SLDASM, Ensamblaje_Alas_Vtol.SLDASM, Ensamblaje_Alas_Vtol_Derecho.SLDASM, Ensamblaje_Completo_Alas_Vtol.SLDASM, Ensamblaje_Completo_Vtol.SLDASM]
2026-09-22 pequeña correccion de ensamble
    [Ensamblaje_Completo_Vtol.SLDASM]
